MicroLind-Developers/microlind/docs/AudioExpansionCard/AudioExpansionCard3.png

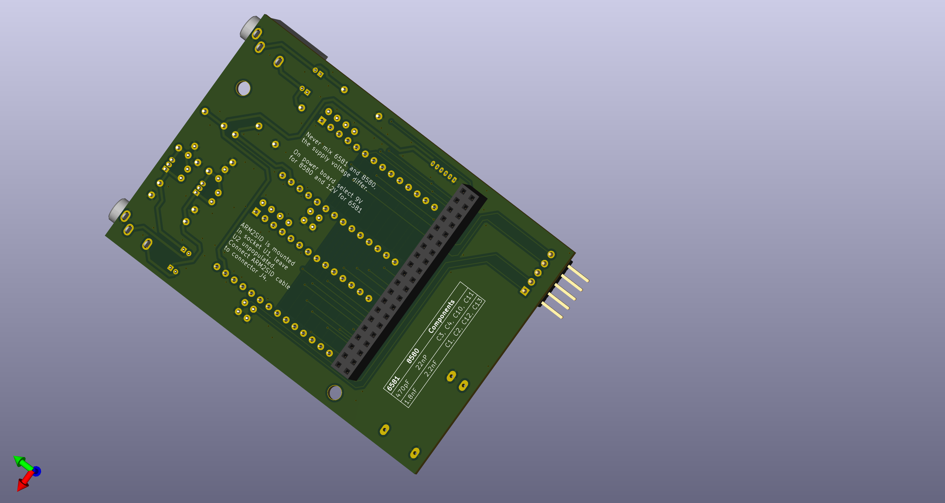
docs/AudioExpansionCard/AudioExpansionCard3.png
