MicroLind-Developers/microlind/README.md

# µLind
A 6809/6309 based micro computer with advanced memory and irq handling.
