MicroLind-Developers/microlind/docs/AudioExpansionCard/aeb-schematics.png

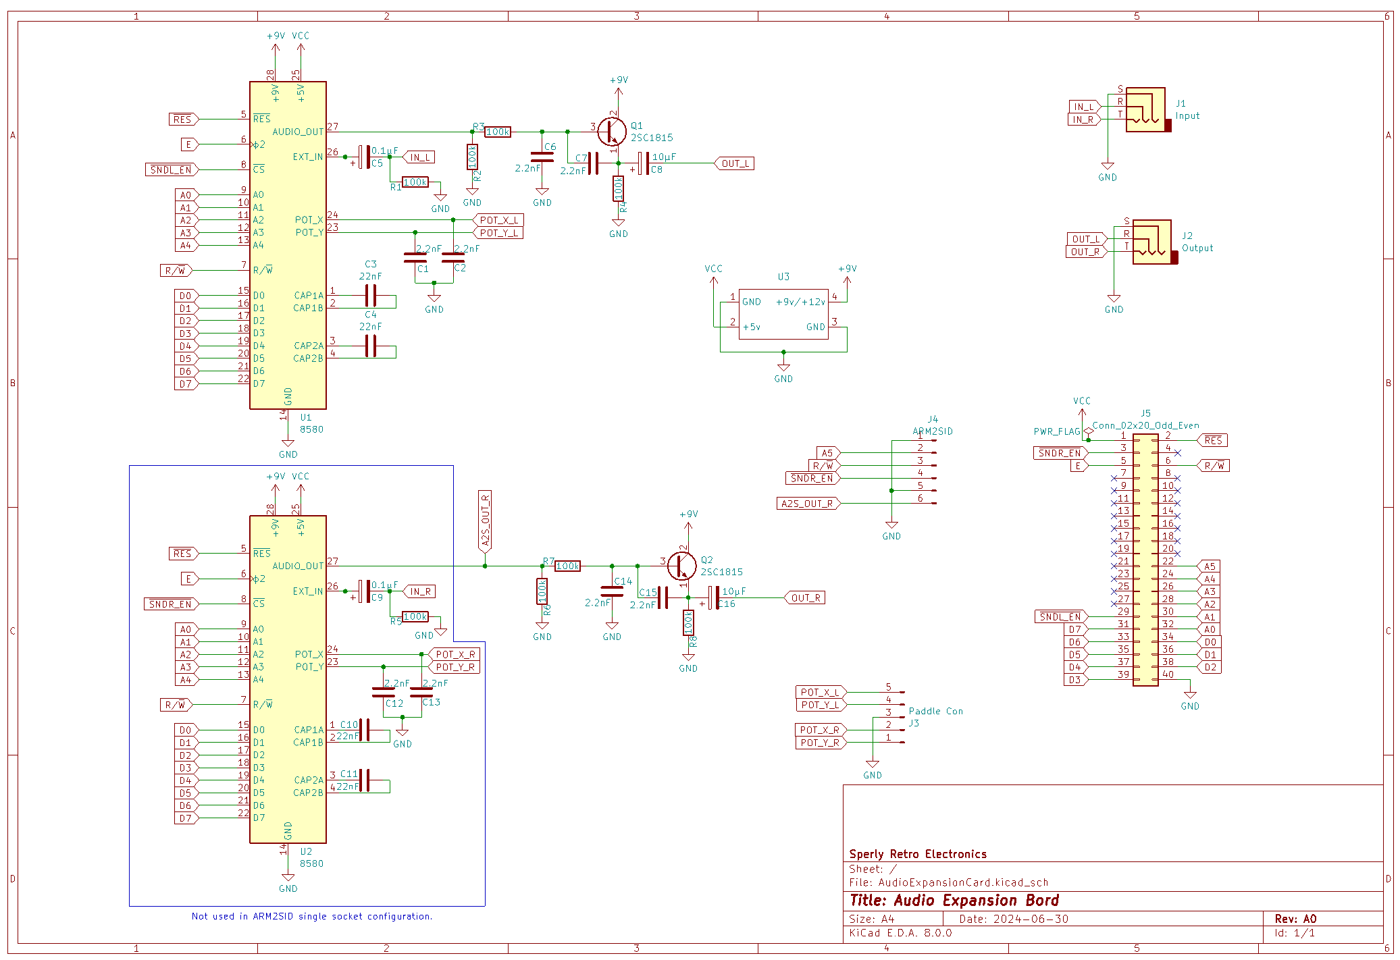
docs/AudioExpansionCard/aeb-schematics.png
