MicroLind-Developers/microlind/docs/AudioExpansionCard/AudioExpansionCard2.png

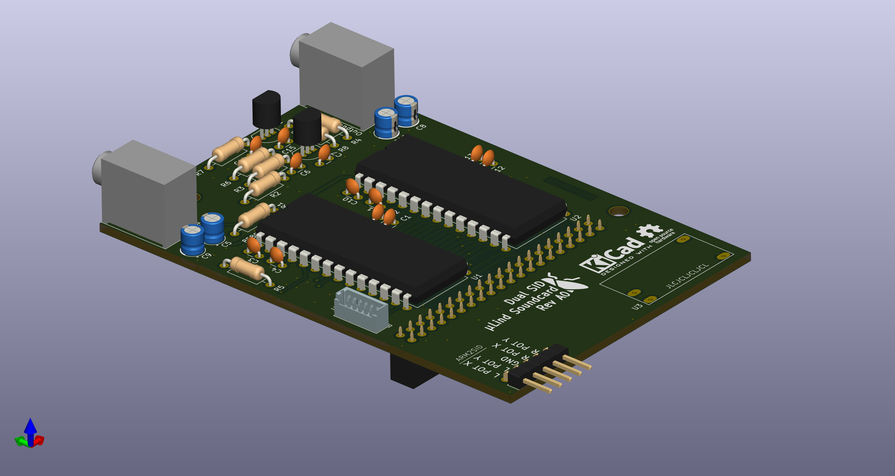
docs/AudioExpansionCard/AudioExpansionCard2.png
