MicroLind-Developers/microlind/docs/AudioExpansionCard/AudioExpansionCard.png

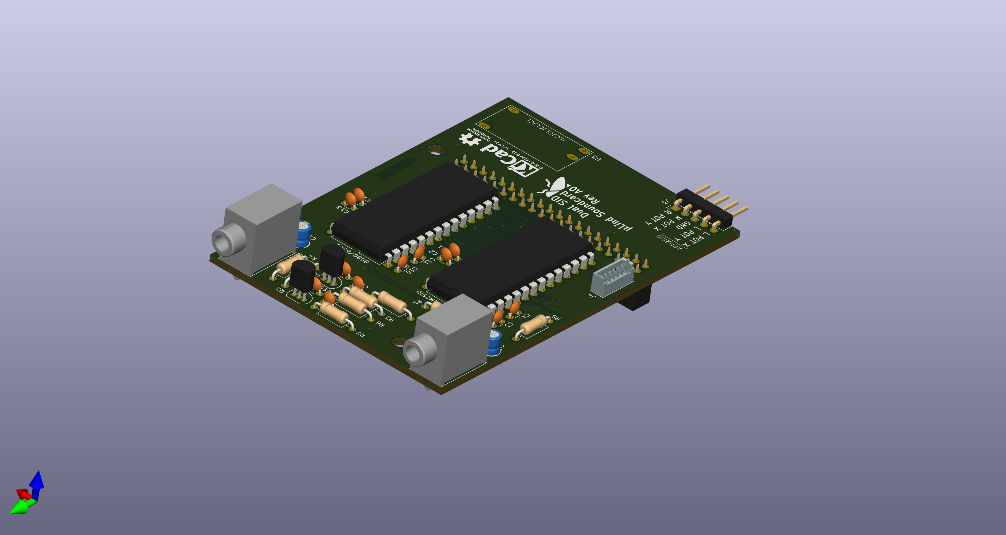
docs/AudioExpansionCard/AudioExpansionCard.png
