MicroLind-Developers/microlind/docs/DSView-240731-161717.png

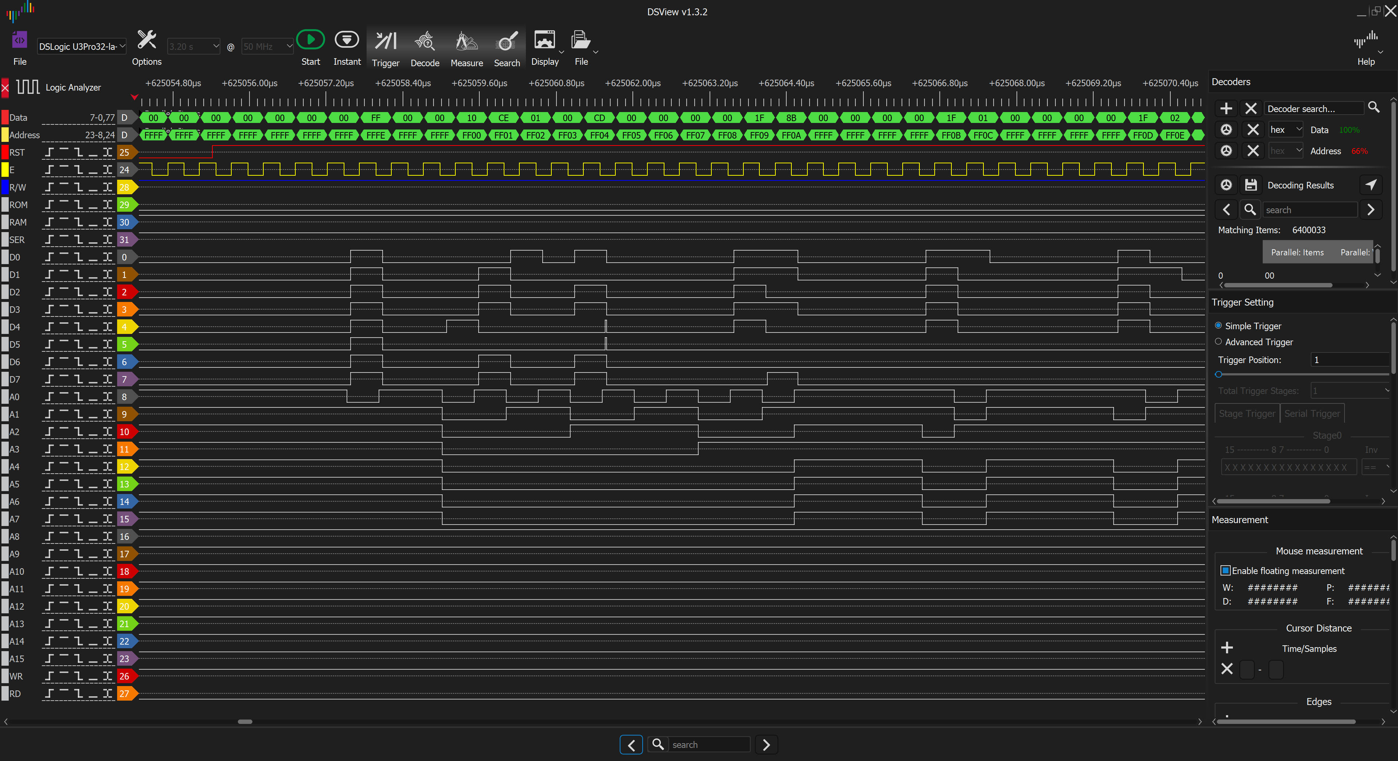
docs/DSView-240731-161717.png
