MicroLind-Developers/microlind/docs/FirstSuccessfulRun.png

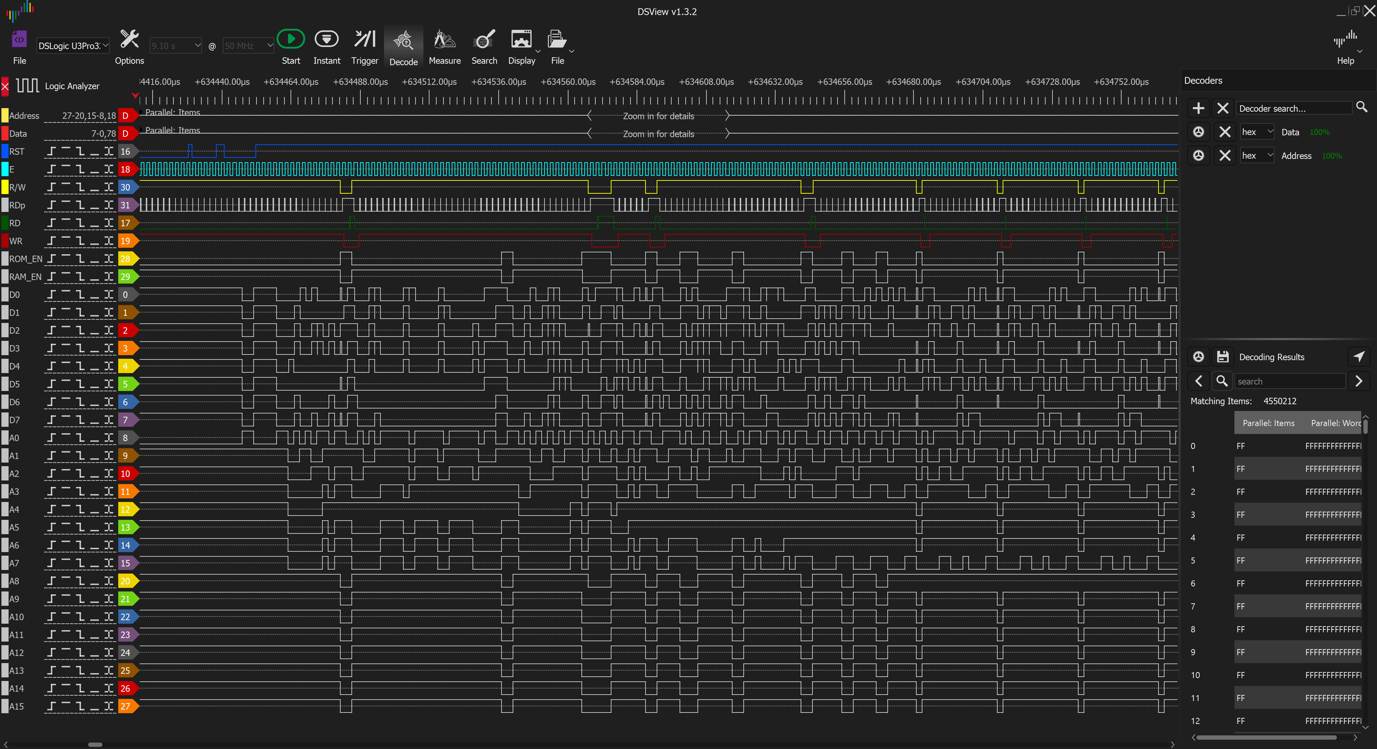
docs/FirstSuccessfulRun.png
