MicroLind-Developers/microlind/docs/motherboard.png

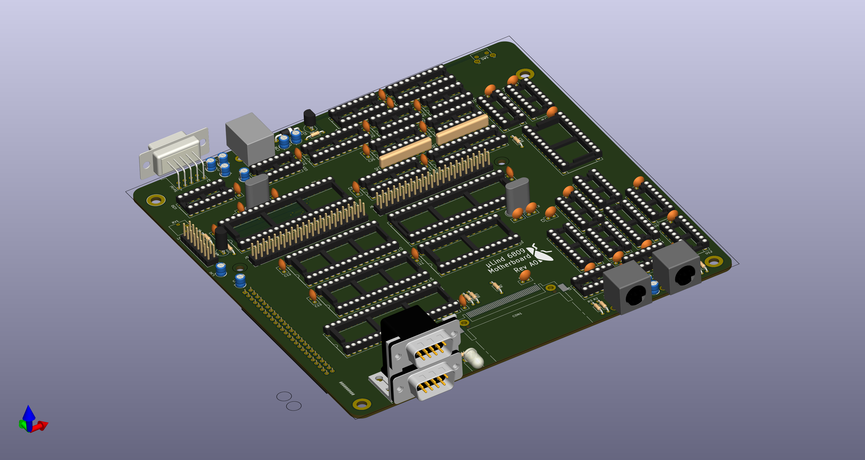
docs/motherboard.png
