MicroLind-Developers/microlind/docs/Parallell-Expansion.png

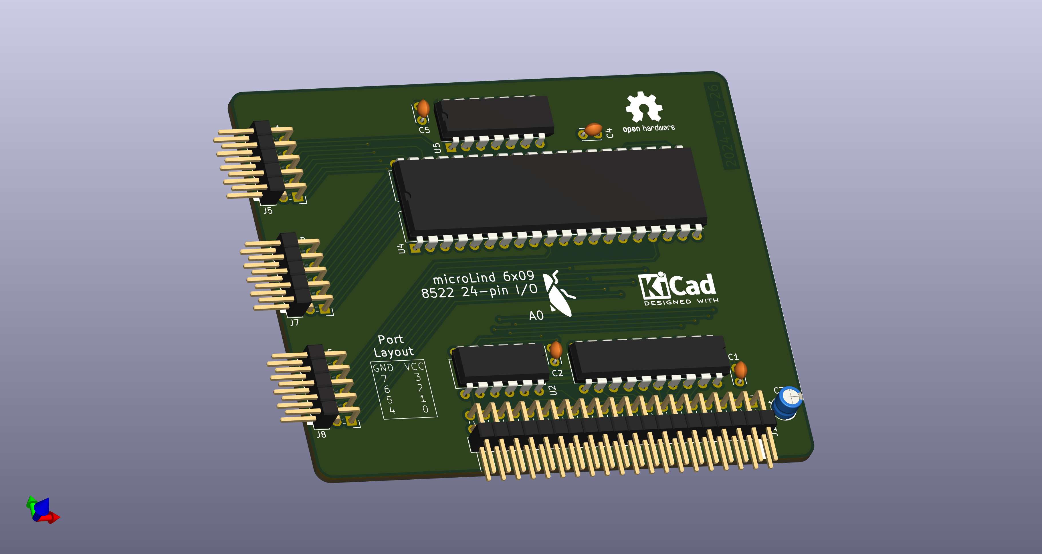
docs/Parallell-Expansion.png
