MicroLind-Developers/microlind/docs/sre.png

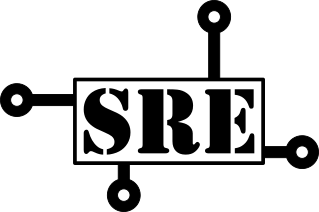
docs/sre.png
