MicroLind-Developers/microlind/docs/system-architecture.png

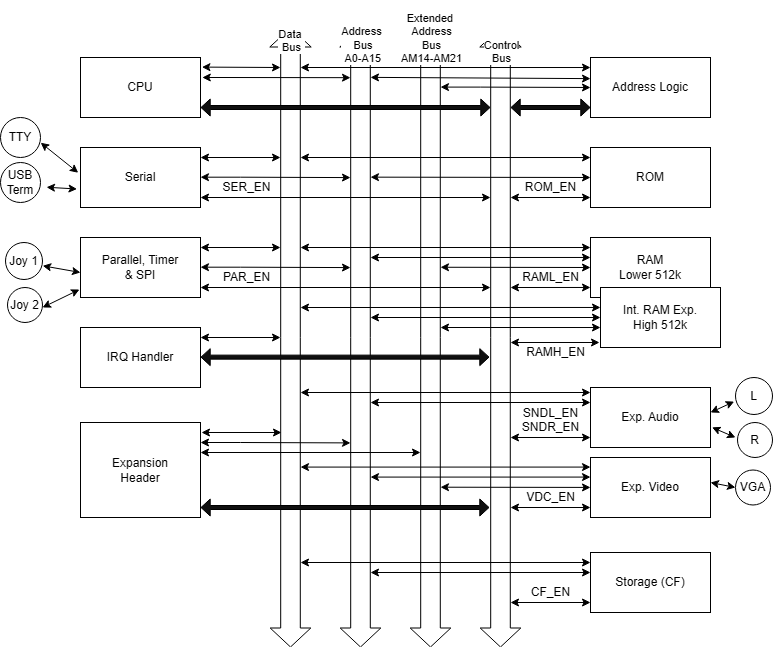
docs/system-architecture.png
