MicroLind-Developers/microlind/docs/TheBlipp.png

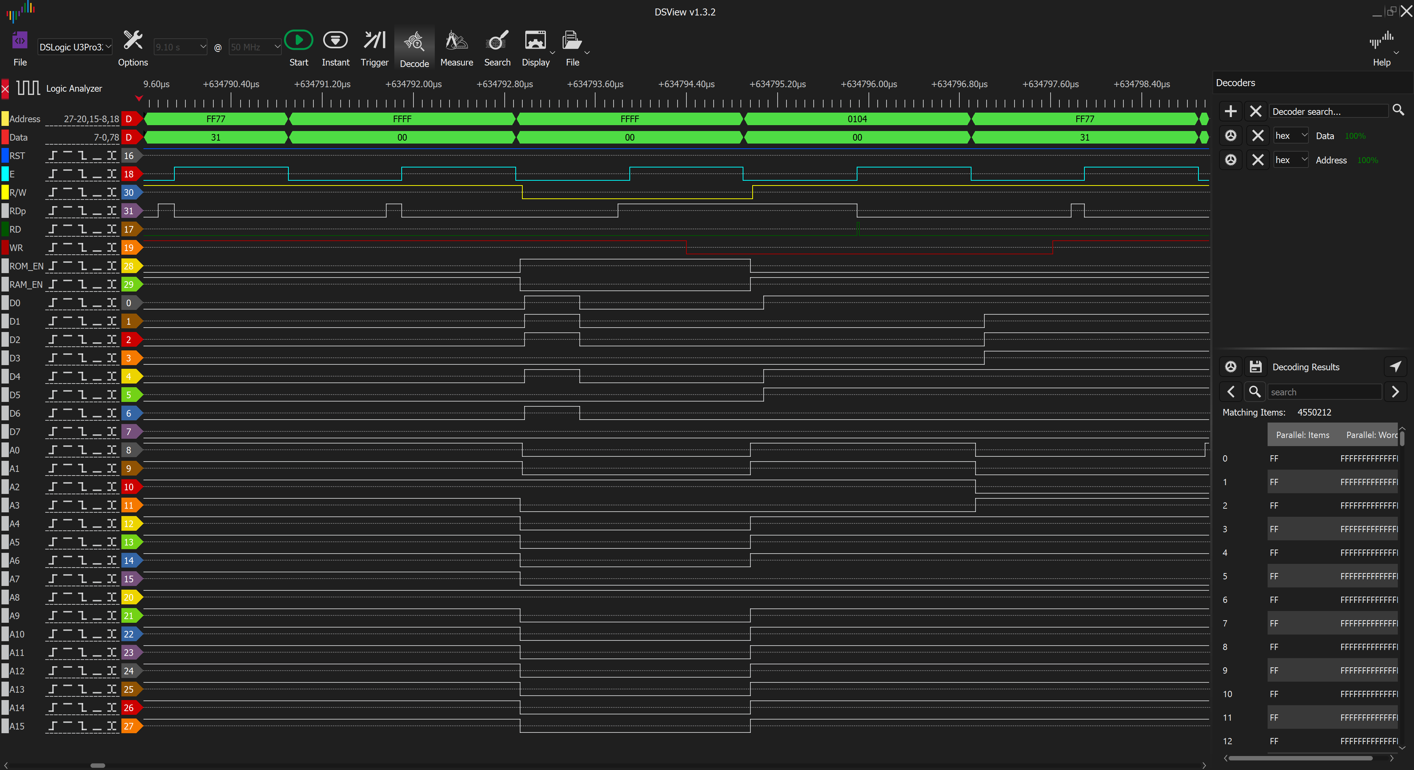
docs/TheBlipp.png
