MicroLind-Developers/microlind/releases/stage1/ml-stage1.png

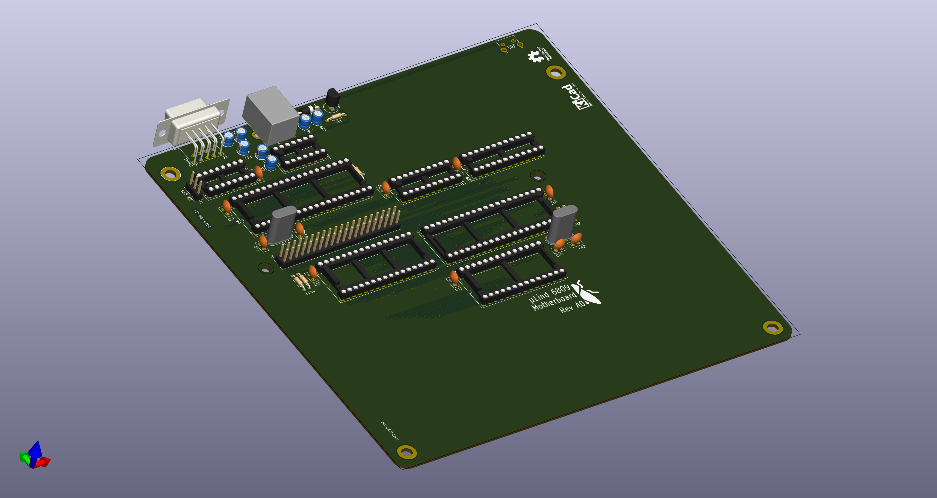
releases/stage1/ml-stage1.png
