MicroLind-Developers/microlind/releases/stage2/motherboard-stage2.png

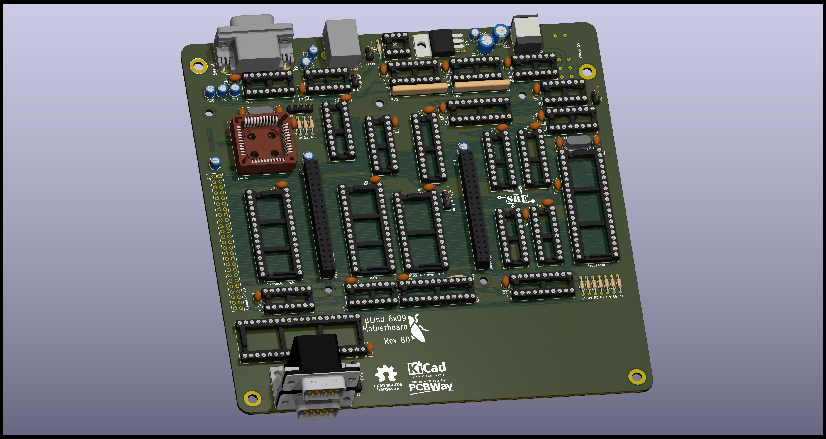
releases/stage2/motherboard-stage2.png
