MicroLind-Developers/microlind/kicad-lib/189-009-613r491.stp

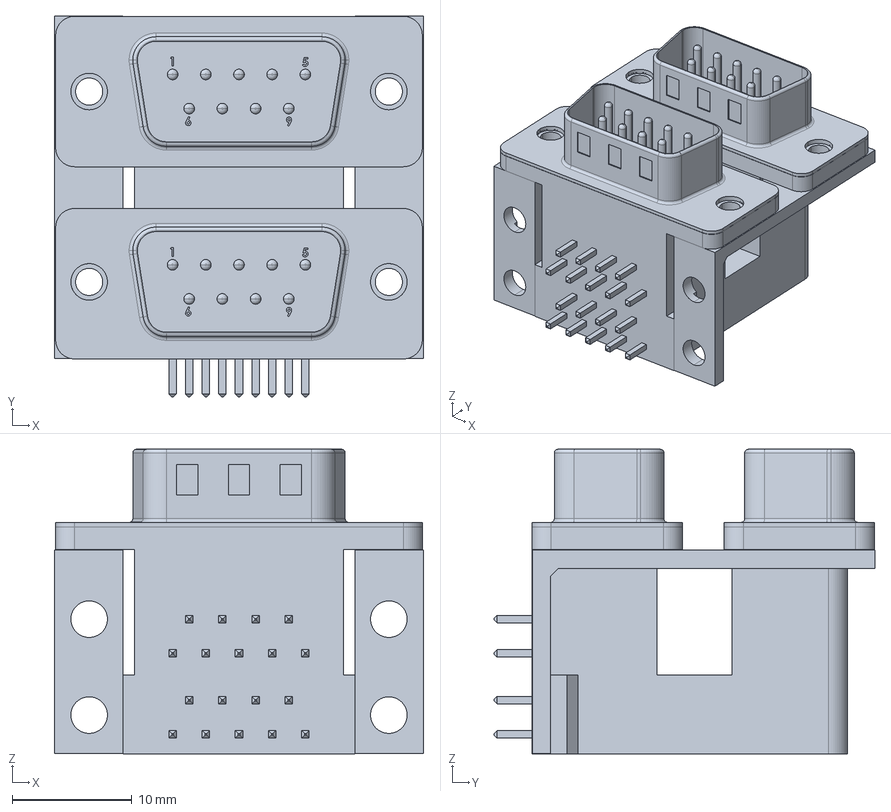
[picture p15: CAD file, 2025-04-27]
kicad-lib/189-009-613r491.stp
30.8 x 31.8 x 25.4 mm
