MicroLind-Developers/microlind/kicad-lib/DualSerialMaleConnector.step

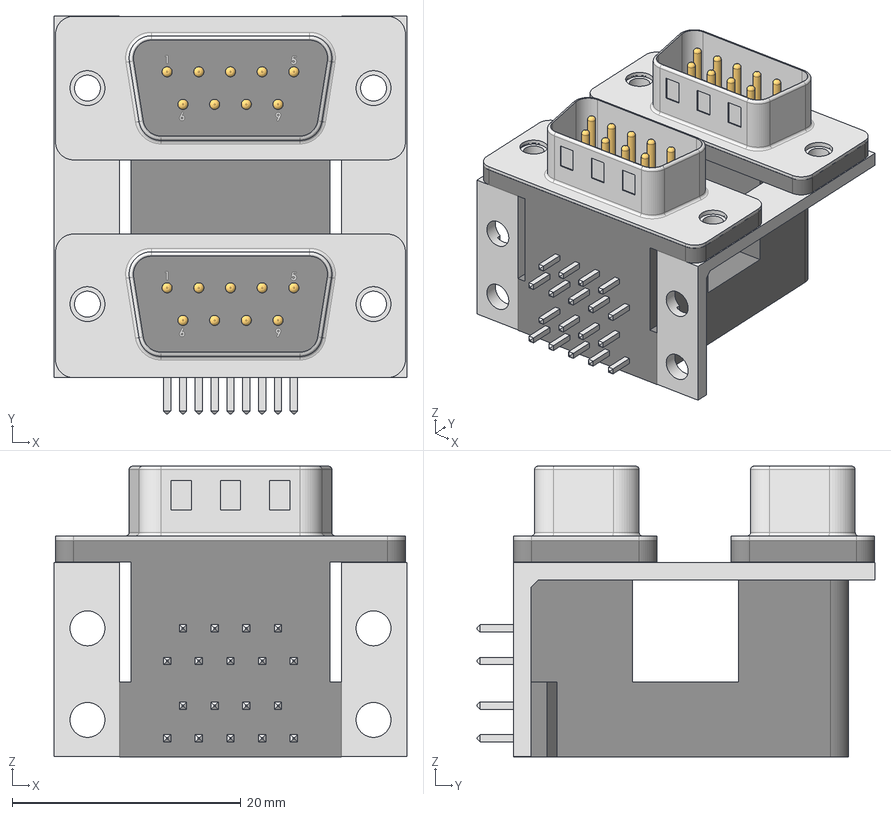
[picture p16: CAD file, 2025-04-27]
kicad-lib/DualSerialMaleConnector.step
30.8 x 34.8 x 25.4 mm
