MicroLind-Developers/microlind/kicad-lib/PLCC44_THT_Socket_P1,27_P2,54.stp

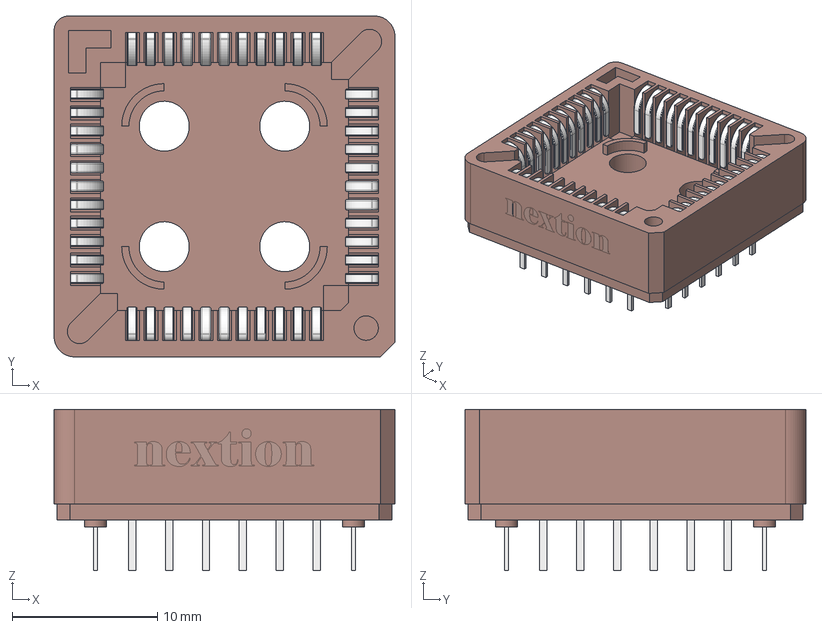
[picture p17: CAD file, 2024-10-30]
kicad-lib/PLCC44_THT_Socket_P1,27_P2,54.stp
23.5 x 23.5 x 11.1 mm
