MicroLind-Developers/microlind/kicad-lib/connector_a-dio-dp_06_gv.stp

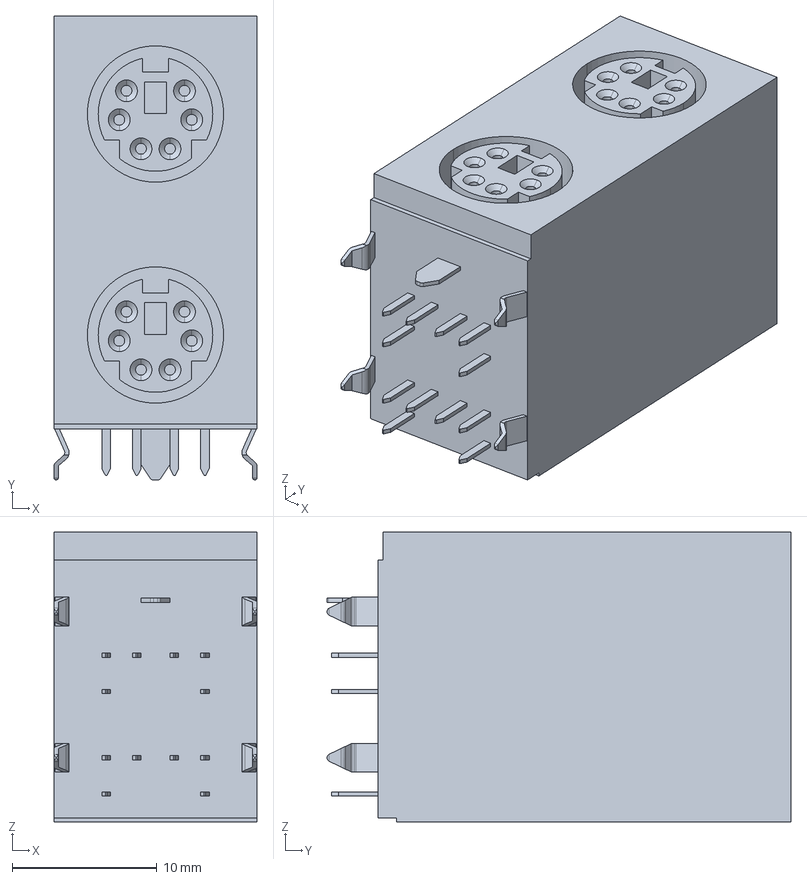
[picture p19: CAD file, 2024-10-30]
kicad-lib/connector_a-dio-dp_06_gv.stp
14.0 x 32.0 x 20.0 mm
