MicroLind-Developers/microlind/kicad-lib/7201J1AQE2.stp

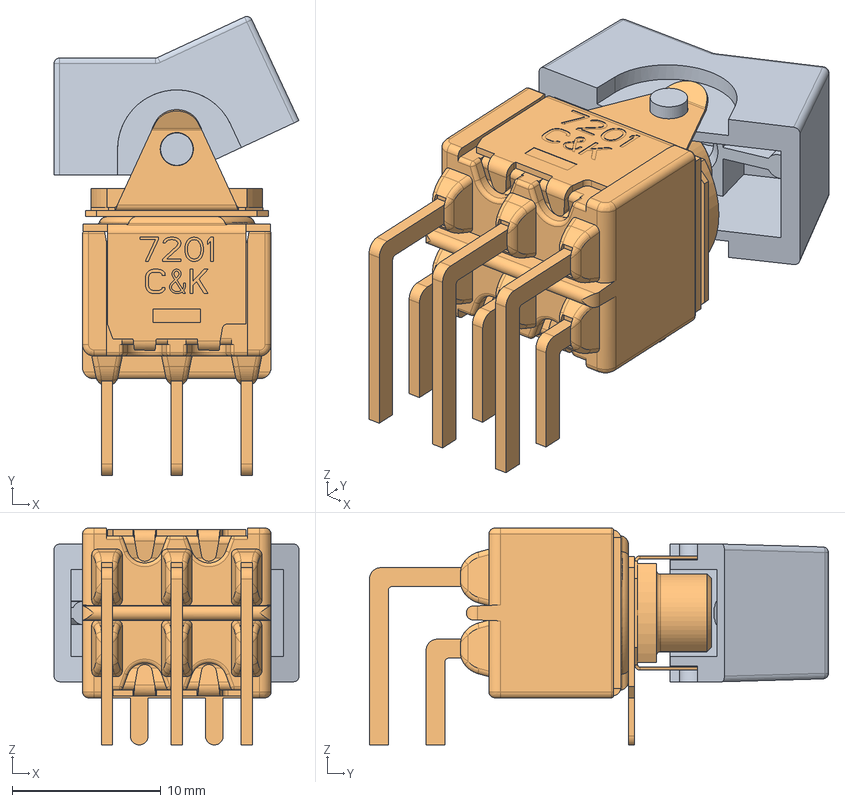
[picture p20: CAD file, 2024-10-30]
kicad-lib/7201J1AQE2.stp
16.5 x 30.9 x 14.6 mm
