MicroLind-Developers/microlind/kicad-lib/USB-B-S-F-B-TH.stp

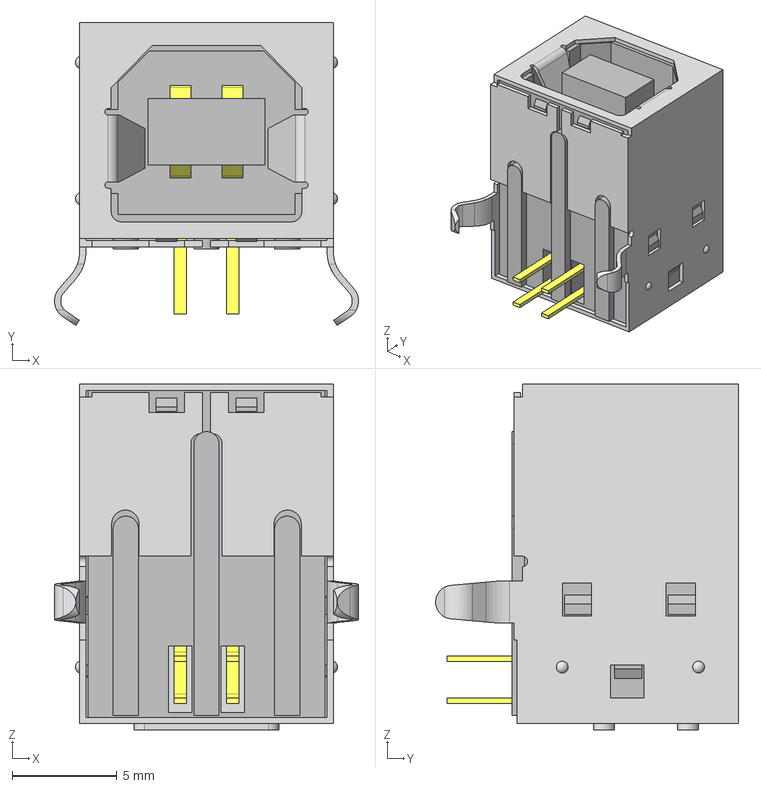
[picture p21: CAD file, 2024-10-30]
kicad-lib/USB-B-S-F-B-TH.stp
14.5 x 14.4 x 16.5 mm
USB-B-S-TH_S
USB-B-S-B-TH_B
USB-B-S-TH_P
