MicroLind-Developers/microlind/kicad-lib/USB type-B female PCB.STEP

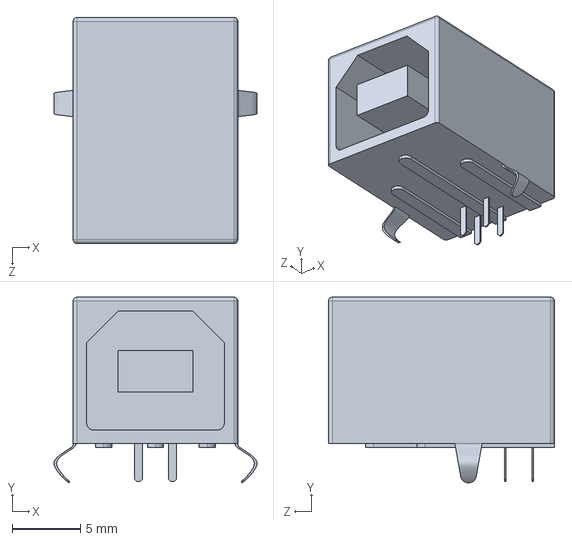
[picture p22: CAD file, 2024-10-30]
kicad-lib/USB type-B female PCB.STEP
14.9 x 13.6 x 16.6 mm
