MicroLind-Developers/microlind/kicad-lib/CUI_DEVICES_SJ1-3533NG.step

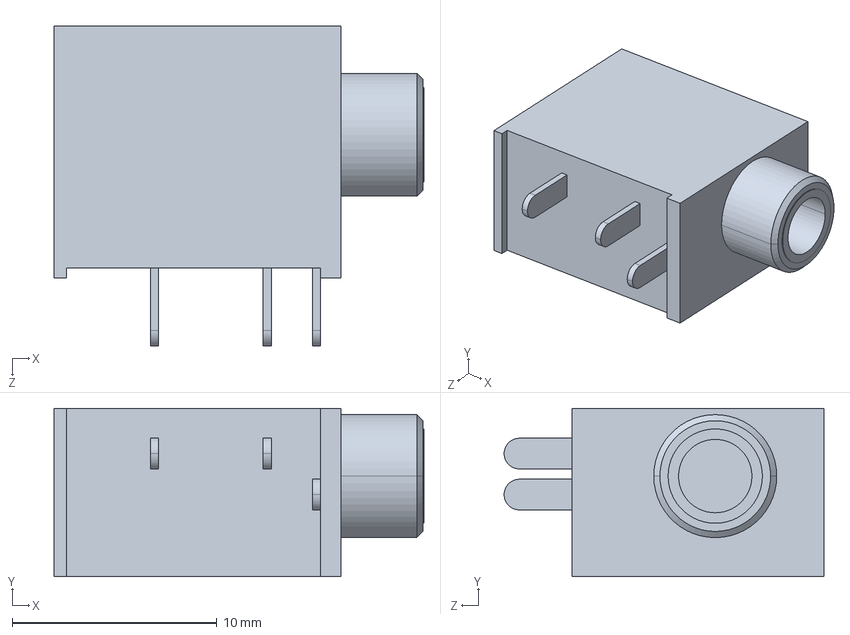
[picture p23: CAD file, 2024-10-30]
kicad-lib/CUI_DEVICES_SJ1-3533NG.step
18.1 x 8.20 x 15.6 mm
