MicroLind-Developers/microlind/kicad-lib/Mini-DIN-6P.step

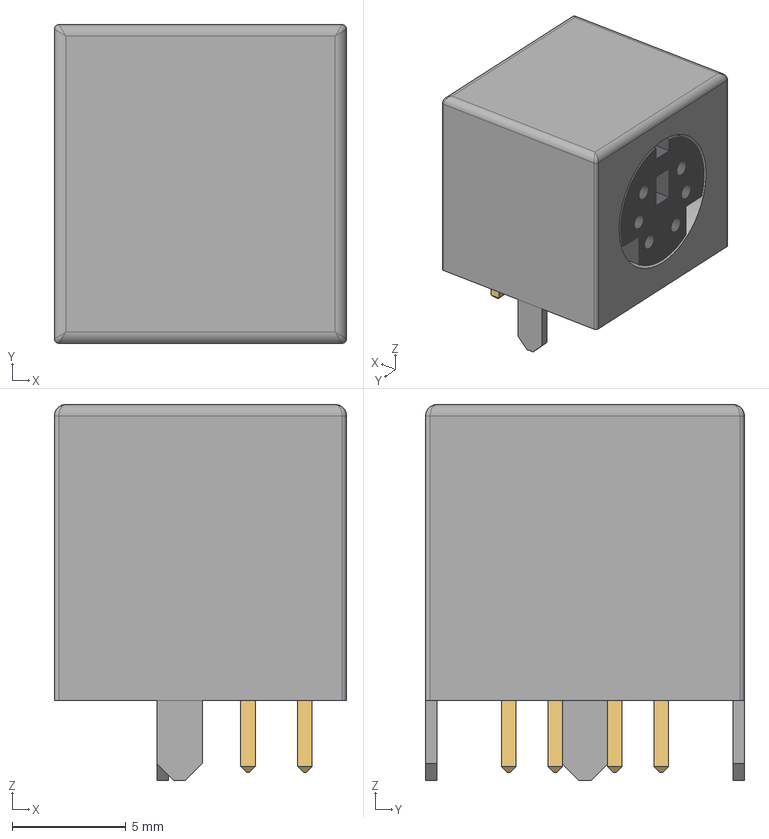
[picture p24: CAD file, 2024-07-31]
kicad-lib/Mini-DIN-6P.step
12.8 x 14.0 x 16.5 mm
