MicroLind-Developers/microlind/kicad-lib/PRT-16764.stp

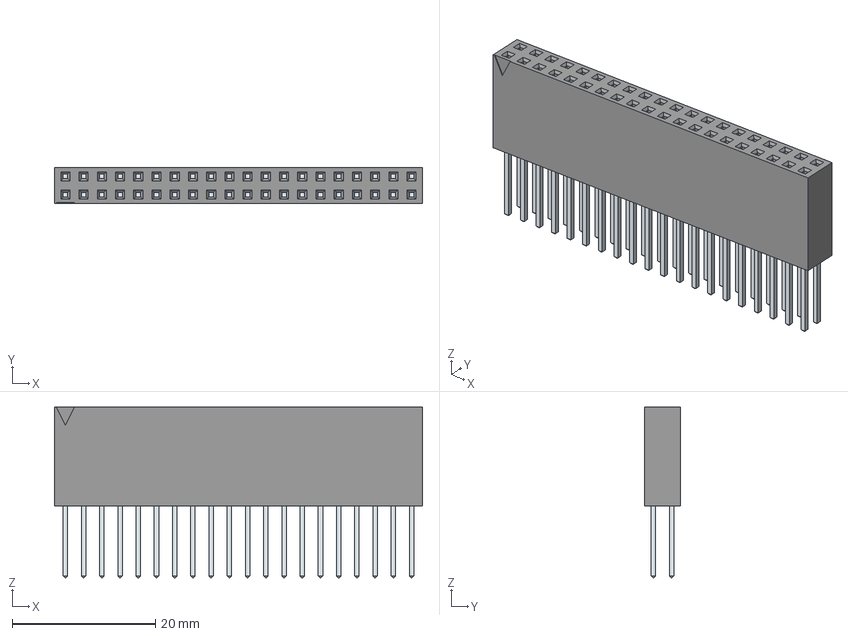
[picture p25: CAD file, 2024-07-31]
kicad-lib/PRT-16764.stp
51.3 x 5.00 x 23.8 mm
LeadsArray
