MicroLind-Developers/microlind/kicad-lib/N7E50-7516PK-20.stp

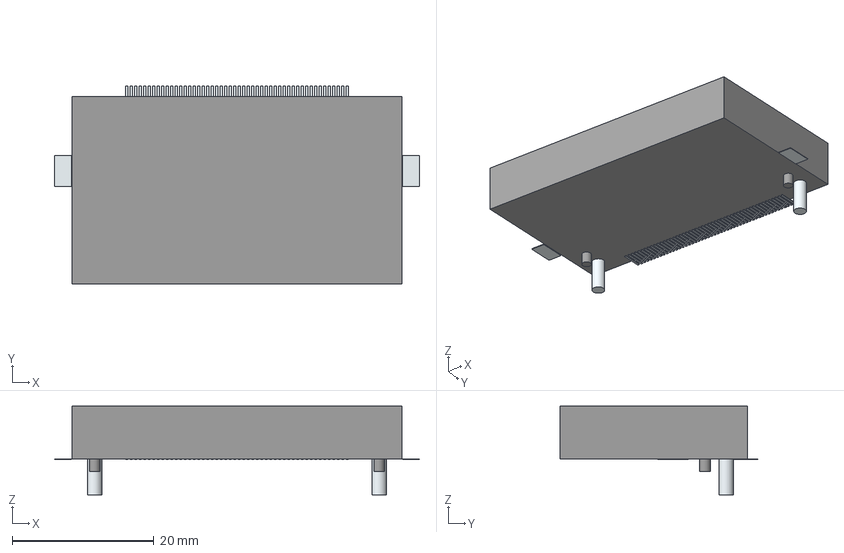
[picture p26: CAD file, 2024-07-31]
kicad-lib/N7E50-7516PK-20.stp
51.5 x 28.0 x 12.5 mm
Pins
Lugs x 4
Leads x 4
