MicroLind-Developers/microlind/kicad-lib/AudioExpansionCard.step

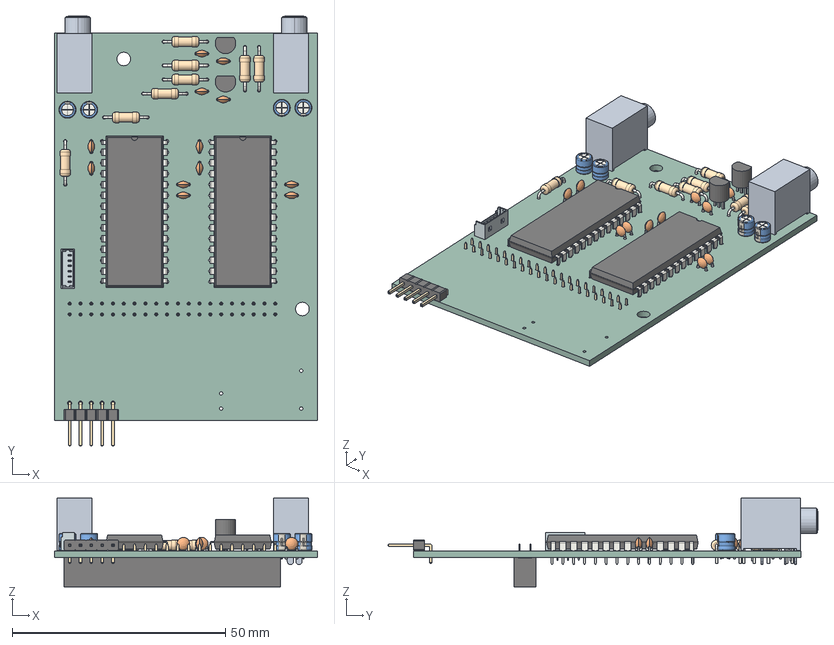
[picture p27: CAD file, 2024-07-31]
kicad-lib/AudioExpansionCard.step
61.7 x 100.9 x 20.8 mm
R_Axial_DIN0207_L63mm_D25mm_P1016mm_Horizontal x 8
C_Disc_D30mm_W16mm_P250mm x 12
DIP-28_W15.24mm x 2
CP_Radial_D40mm_P150mm x 4
CUI_DEVICES_SJ1-3533NG x 2
PinHeader_1x05_P254mm_Horizontal
530470610wbm000_01
PinSocket_2x20_P254mm_Vertical
TO-92_Inline_Narrow x 2
AudioExpansionCard_PCB
