MicroLind-Developers/microlind/kicad-lib/M3x8.STEP

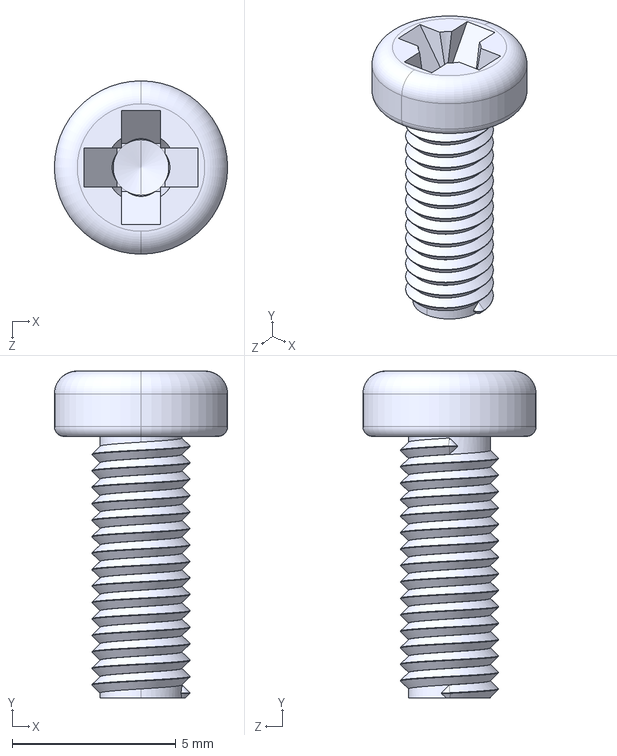
[picture p28: CAD file, 2024-10-30]
kicad-lib/M3x8.STEP
5.30 x 10.0 x 5.30 mm
