MicroLind-Developers/microlind/kicad-lib/530470610.stp

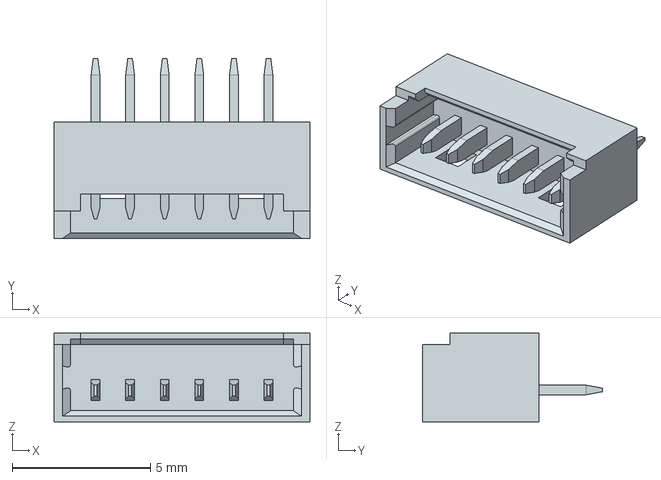
[picture p29: CAD file, 2024-10-30]
kicad-lib/530470610.stp
9.25 x 6.50 x 3.20 mm
