MicroLind-Developers/microlind/kicad-lib/5788667-1.stp

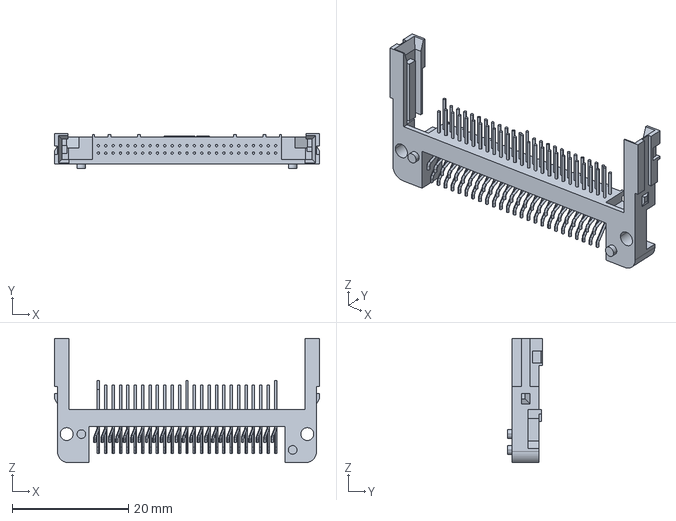
[picture p30: CAD file, 2024-10-30]
kicad-lib/5788667-1.stp
45.6 x 5.97 x 21.4 mm
