MicroLind-Developers/microlind/kicad-lib/2301843-1.step

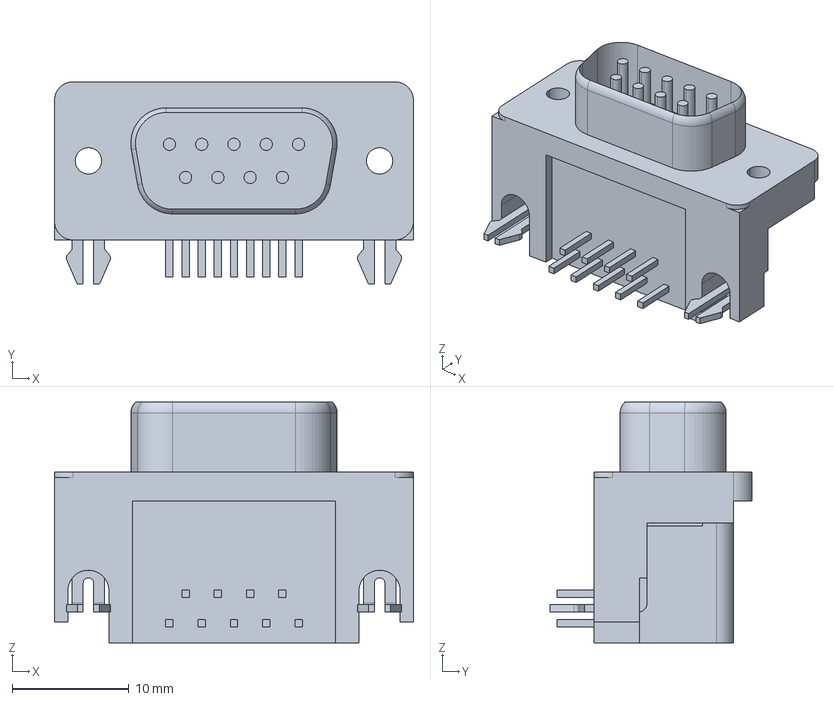
[picture p31: CAD file, 2024-07-31]
kicad-lib/2301843-1.step
30.8 x 17.4 x 20.6 mm
