MicroLind-Developers/microlind/(list of files, cad)

Other CAD files:
kicad-lib/189-009-613r571.stp
