MicroLind-Developers/microlind/docs/Microlind_Manual booklet 1-14.pdf

# µLind

# 8-bit Retro Computer

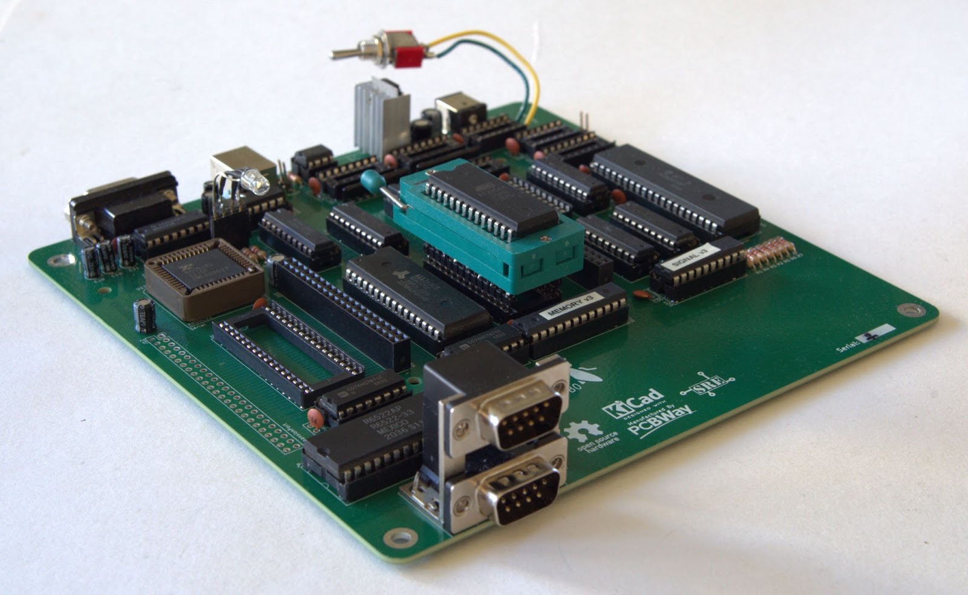
[picture p32: figure]

Sperly Retro Electronics | v1.0 | 2025-05-23

# noit cudort nI

si ht ni gni ht yr eve wohr eb me mer ot snae ma sa, dni L cir E, e myb nettir w si l auna msi hT eht , uoy hti w egdel wonk t aht er ahs ot snae m a sa osl a dna kr o w ot dednet ni si met sys ebt hgi msgni dr o w os r ekaeps hsil gnE evit an at on maI .l auna mt nell ecxe si ht f o r edaer e mos ebt hgi mer ehT. hguone r ael c eb ll ahs t net ni eht t aht epoh I t ub se mit e mos dri e w t uohti woS.ti xif nacI os e mot kcabti tr oper esael p, yna dnif uoyfi t ubll e wsa sr orr el aut caf

! sseni sub eht ot ni t eg s't el , odar ehtr uf

## wei vr evot cej or pf eir B

r of dna, gnit ser et ni na dnuof nos dl o r aey 41 neht y mr etf a, 3202 ni detr at s t cej or p si hT neeb gnol ecni s dahI ! 9086 ehT: spi hc dl of o gab a ni r ossecor por ci m, n wonknu suf o ht ob si ht f o ngi sed eht yb deugirt ni yl et ai de mmi sa wdnar et up mocor ci ma dli ub ot woh no suoir uc di va er a nos y m dna e m ht ob( 0156/ 2056 eht hti wr aili maf eti uq gni eB. pi hc elttil cit oxe e W. gnit ser et ni 9086 eht f o ser ut aef " decnavda" eht dnuof e w)! 46 OG. sr esu er odo mmo C dnA. od ot el ba eb ot r et up moc a ekil dl uo w e wt ah wf o saedi t ner effi d no gni hct eks detr at s r ossecor p si ht eda mt aht ser ut aef l ar eves dnuof r edaer t eehsat ad gni za ma na si oh wnos y m

. no met sys a dli ub ot gnit ser et ni f ot sil a no deltt es e wdnuor a saedi gni wor ht dna noi ssucsi df o sht no mf o el puoc ar etf A

: evah ot met sys eht det na we wser ut aef

) 9036 eht no dedi ced e wnor et al( r ossecor p 90x6 eht no desaB ●

) gni knabf o dni k e mos eri uqer dl uo wsi hT( MARel bali avaf o b M1t sael t a eva H ● sr evir d dna SOI B gnir ot sr of MORPEE ●

) gubed ot el ba eb ot( tr op el osnoc desab BSU ● noit aci nu mmocl ar ehpir epr of tr opl air eS ●

)t ne mni atr et ner of , el bit ap moc 46 C( str op kcit syoJ ●

)ll e wsa ecafr et ni esuo myll uf epoh dna( ecafr et ni dr aobyeK 2SP ●

) ytili bit ap mocti b- 8 ot eud, FCyl ekil t so m( snoit acil ppa dna SOr of egar ot sl anr et x E ●

) dnuos DI Sl ufr edno wt aht t na we w( tr oppus oi duA ●

) doogtif dl uo w821 Ceht ni pi hcl oc 08 ehT( seitili bapac oedi V ● …seitili bi ssop noi snapxer ehtr uf dnA ●

! sl ol r of t suj , egakcap XTI-i ni Ma ni si ht ll A ●

)fl esy mt uoyal dr aob eht f oll a di dI( I dr aob eno no si ht ll a egana m ot el ba eb ot dnA dr aobt aht t eg, ser ut aef e mos dda, gni kr o wci sab gni ht yr evet eg, segat s ni ti od ot dedi ced t aht was osl a e W. gnor wsi t ah w et al osi ot r ei sae si ti ya w si hT.t ser eht dda dna gni kr o w os, dr aob eht no sti ucri c oi duar or ell ort noc oedi v r ehti er of moor eb ot gni ogt on sa w er eht l ar eves t set dna r ett eb met sys eht r eyal ot el ba eb ot , str op- nodda ot devo m er e w yeht

. snoit ul os oi dua dna oedi vt ner effi d sci nort cel E ort e Rylr epS 2

## Pinout tables

## Circuit Diagrams & Schematics

### Annotated schematic diagrams

Detailed circuit descriptions

References and additional resources

14 | Sperly Retro Electronics

So we planned following stages:

- Stage 1: Basic functionality, processor, some unbanked RAM, EEPROM, basic logic chip setup and a serial controller.
- Stage 2: Stage 1 + banking system, more RAM, power and reset circuit, addon-ports (to be able to start developing video and audio addons), expansion port (with more “all” signals) and a parallel port for joysticks.
- Stage 3: Stage 2 + PS2 interfaces and CF addon port (this was not possible to fit on the board either).

This manual is written for Stage 3, the “final” stage, and will be updated upon correction and changes done to the system during the development (at the time of writing this, the Stage 3 has not been ordered yet, but all parts of stage 2 have been tested).

## Purpose and intended audience of the manual

This manual will be useful for anyone that needs to either fault trace the µLind, change settings or write applications for the system. Since this manual also contains a listing of all BIOS routines and memory mapping.

# Specifications

### Processor details (HD6x09, clock speed, etc.)

### Memory specifications (RAM/ROM configuration)

### I/O capabilities and peripherals

Sperly Retro Electronics | 3

# wei vr ev O met sy S

hti w esac XTI-i ni ma ni tif ot dengi sed si tI . yr ol g sti ll a ni dr aobr eht o m dni Lµ eht si si hT ekil , str op r esu dna kcab eht noll a er a str op ytilit u ehT. yl gni dr occa dengil a sel oh wer cs eht r of el bi ssecca yli sae,t norf eht no er a hsal Ft cap mo C dna esuo m, dr aobyek , skcit syoj gni kcat s r of dr aob eht f o edi s r eppu r ehti e no der edl os eb nac tr op noi snapxe ehT.r esu

. edi s eht ot r o wol eb snoi snapxe kcat s ot , edi s mott ob eht no r o pot no sdr ac noi snapxe ot der evil ed si dr aob eht neh w der edl os ebt on r edaeh dr aob noi snapxe eht lli w er of er ehT

.r esu dne eht

sci hpar G
- 044F$

nodda sci hpar g no gni dnepe D F74F$

L oi duA
- 084F$

nodda oi duA no gni dnepe D FB4F$

Roi duA
- 0 C4F$

nodda oi duA no gni dnepe D FF4F$

noi snapx E

tr oP
- 005F$

) ni ppa mr et si ger noi snapxe eS( snoi snapx E no gni dnepe D FF7F$

: woll of sa er a dr aob noi snapxe eht r of pa myr o me meht dnA ci goL sser ddA dr aoB noi snapxE

0A 1A 2A 3A 4A 5A 6A 7A 8A

1 dr aoBesaB x x x x x x 0 0 0 F36F 006F x x x x x x 1 0 0 F76F 046F

)ti B 7( 1t ol S

x x x x x x 0 1 0 FB6F 086F

)ti B 5( 2t ol S x x x x 1 0 1 1 0 FD6F 0 C6F

)ti B 3( 3t ol S x x x 0 0 1 1 1 0 7E6F 0E6F

)ti B 3( 4t ol S x x x 1 0 1 1 1 0 FE6F 8E6F

)ti B 3( 5t ol S x x x 0 1 1 1 1 0 7F6F 0F6F

)ti B 3( 6t ol S x x x 1 1 1 1 1 0 FF6F 8F6F

2 dr aoBesaB x x x x x x 0 0 1 F37F 007F x x x x x x 1 0 1 F77F 047F

)ti B 7( 1t ol S

x x x x x x 0 1 1 FB7F 087F

)ti B 5( 2t ol S x x x x 1 0 1 1 1 FD7F 0 C7F

)ti B 3( 3t ol S x x x 0 0 1 1 1 1 7E7F 0E7F

)ti B 3( 4t ol S x x x 1 0 1 1 1 1 FE7F 8E7F

)ti B 3( 5t ol S x x x 0 1 1 1 1 1 7F7F 0F7F

)ti B 3( 6t ol S x x x 1 1 1 1 1 1 FF7F 8F7F sr eil ppus dnat sil str aP

31 sci nort cel E ort e Rylr epS

$F409 | ER/FR | ErrorRegister | FeatureRegister
$F40A | SCR | Sector count register
$F40B | SNR | Sector number register
$F40C | CLR | Cylinder low register
$F40D | CHR | Cylinder high register
$F40E | DHR | Drive head register
$F40F | SR/CR | Status register | Command register
Parallel (VIA) | $F410 | ORB/IRA | Input Register B | Output Register B
| $F411 | ORA | Input Register A | Output Register A
| $F412 | DDRB | Data Direction Register B
| $F413 | DDRA | Data Direction Register A
| $F414 | T1L-L / T1C-L | T1 Counter Low | T1 Latch Low
| $F415 | T1C-H | T1 Counter High
| $F416 | T1L-L | T1 Latch Low
| $F417 | T1L-H | T1 Latch High
| $F418 | T2C-L | T2 Counter Low | T2 Latch Low
| $F419 | T2C-H | T2 Counter High
| $F41A | SR | Shift Register
| $F41B | ACR | Aux Control Register
| $F41C | PCR | Peripheral Control Register
| $F41D | IFR | Interupt Flag Register
| $F41E | IER | Interupt Enable Register
| $F41F | ORA/IRA | Same as register 1 without "handshake"
Serial (XR88C92) | $F420 | MRA | Mode Register A
| $F421 | SRA/CSRA | Status Register A | Clock Select Register A
| $F422 | CRA | Reserved | Command Register A
| $F423 | RXA/TXA | Receive Buffer A | Transmit Buffer A
| $F424 | IPCR/ACR | Input Port Change Register | Auxiliary Control Register
| $F425 | ISR/IMR | Interrupt Status Register | Interrupt Mask Register
| $F426 | CUR/CTPU | Counter / Timer Upper Register | C/T Pre-load Value Upper Register
| $F427 | CLR/CTPL | Counter / Timer Lower Register | C/T Pre-load Value Lower Register
| $F428 | MRB | Mode Register B
| $F429 | SRB/CSRB | Status Register B | Clock Select Register B
| $F42A | CRB | Reserved | Command Register B
| $F42B | RXB/TXB | Receive Buffer B | Transmit Buffer B
| $F42C | GPR | General Purpose Register
| $F42D | IPR/OPCR | Input Port Register | Output Port Control Register
| $F42E | STCR/SOPR | Start C/T Command | Set Output Port Register
| $F42F | SPCR/ROPR | Stop C/T Command | Reset Output Port Register
12 | Sperly Retro Electronics

## Block diagram of the µLind system

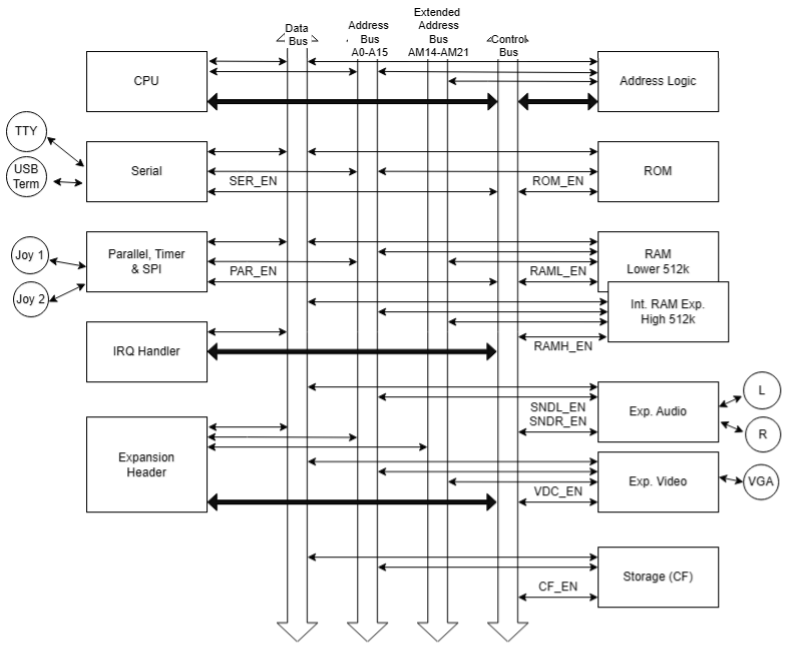
[picture p33: figure]

The block diagram shows the principle behind the µLind system. It shows what signals each subsystem is using and how they are interconnected. Do note that this is a simplified image and some signals may not be included.

## Explanation of key subsystems

To make it easier to explain how µLind is interconnected it will be described as subsystem according to the block diagram.

### The CPU subsystem

This is the heart of the µLind system and is connected to all main buses. It has the system clock crystal connected and will generate a E & Q clock, with the Q clock 90° before the E clock.

Sperly Retro Electronics | 5

### met sysbusl air eS ehT

l air es 2 hti wr ell ort nocl air es a ya w el p mi s a ni met sys dni Lµ eht ot t cennoc ot el ba eb oT l air es a sa desu yll a mr on, noit cennoc BSU a r of desu si tr op t srif ehT. dedda sa w str op

.tr opl air es el bali avar esu a si tr op dnoces ehT.l ani mr et

# st nenop mo Cer a wdr a H

## :t nenop moc ni a mhcaef o esopr up dna noit pir cse D

### ) 90x6 DH( r ossecor P

### o wt er a er ehT

### ) MOR/ MAR( sel udo myr o me M

### yrti ucri c noit ar eneg kcol C

### str opt upt uo/t upnI

### sr ot cennoc noi snapx E

### st ne meri uqer yl ppusr e woP

# snoit p O & noit ar ugif no C

## . sr ep muj gnil dnah no snoit curt sni l ar ene G

l acirt cel e na esuac nact ahT. nor e wop eht hti wt aht od T ONod, degnahc eb ot si r ep muj afI r e wop eht gul pnu sya wl A. el basunu dr aob r uoy r edner t hgi m dna met sys r uoy ni tl uaf

. sr ep muj dr aob yna gni gnahc er of ebr ot cennoc

## snoit p Onoit ar ugif no Cdna sgnitt eSr ep muJ

# er a wmri F dna gni mmar gor P

st ne mnori vne er a wtf os detr oppusf o wei vr ev O snoit curt sni er a wmrif gnit adpu dna gni daoL

# seci dneppA

## senit uo R SOI B

f o noit cell oc a si er eht dni Lµ eht r of gni mmar gor p neh w seussi ezi mi ni m dna yfil p mi s oT ot knab yr o me m gnitt es morf , sksat dr adnat s f o t ol a hti w pl eh nac t aht senit uor SOI B

. noiti sop yr o me ma ot FC morf elif a gni daol

## pa Myr o me M

ebt hgi myal psi d oedi v eht ekil snoit cnuf e mos( deppa myr o me msi met sys O/I erit ne ehT

: el bat si ht ot gni dr occa el bali avar et si ger yr eve si er of er eht dna) deppa myr o me moduesp noit cnuF: R W noit cnuF: DR ci no menN sser dA ti nU OI

yr o me M

0B M 004F$ r eppa M
t a egapr of kcol byr o me mt est nerr uc dae R

FFF3$- 0000$
t a egapr of kcol Byr o me Mt eS

FFF3$- 0000$

1B M 104F$
t a egapr of kcol byr o me mt est nerr uc dae R

FFF7$- 0004$
t a egapr of kcol Byr o me Mt eS

FFF7$- 0004$

2B M 204F$
t a egapr of kcol byr o me mt est nerr uc dae R

FFFB$- 0008$
t a egapr of kcol Byr o me Mt eS

FFFB$- 0008$

3B M 304F$
t a egapr of kcol byr o me mt est nerr uc dae R

FFFD$- 000 C$
t a egapr of kcol Byr o me Mt eS

) k8 yl no( FFFD$- 000 C$

MQRI/ RQRI 404F$ r el dna H QRI , QRI evit cat nerr uc el bbi n wol : DR ksa m QRI der ugif noc ylt nerr uc el bbi n hgi h

, ksa m QRI t es ot el bbi n hgi h: R W

r eggirt lli wksa mnaht r ehgi h s QRI yl no

QRI

SLP 504F$ DELr e woP
, woll eY = 3, neer G= 2, de R= 1,ff O= 0 eti h W= 7, nay C= 6,t el oi V = 5, eul B = 4 sser p yekt nerr uct e G RPK 604F$ 2SP et yb esuo mt nerr uct e G RM 704F$

r et si ge Rat a D RD 804F$ hsal Ft cap mo C

11 sci nort cel E ort e Rylr epS

### Typical Use-Cases

Storage expansion.

Boot options and file systems supported.

### Additional Expansion Options (if applicable)

Description of other possible expansions or optional modules planned or supported.

Information on compatibility and special considerations.

# Assembly Instructions

List of required components

Step-by-step assembly guidance

PCB layout considerations

# Testing and Troubleshooting

Initial power-up tests

Diagnostic routines

Common hardware troubleshooting scenarios and solutions

10 | Sperly Retro Electronics

The µLind board contains 16 different jumpers and on-board connectors that can be used for configuration of board functions.

Jumpers and Internal connectors
ID | Name
J1 | Halt
J2 | ROM Write Enable
J3 | USB Reset Enable
J4 | RGBLed
J5 | Reset
J6 | PWM Speaker
J7 | Pot Connector (For SID board)
J8 | SPI Port
J9 | LightPen (For VDC board)
J10 | CTS Enable (Must be used with J11)
J11 | RTS Enable (Must be used with J10)
J12 | Memory 1M
J13 | Expansion Board
J14 | Expansion Board 2
J15 | (For Future Use)
J16 | 12v In

### J1. Halt connector

This connector lets the user add a Halt button to the µLind board. The halt button lets you halt execution, for debugging or fault tracing purposes for example.

### J2. ROM Write Enable

This jumper, when added, lets you write to the EEPROM. It connects the WR line to the EEPROMS WR input. Special considerations need to be taken of how the EEPROM handles writes.

Sperly Retro Electronics | 7

### el banEt ese R BSU. 3J

ot det cennoc si ecafr et nI BSU eht f o enil TESER eht ecal p ni si r ep muj si ht fI e mit yr ever ell ort noc BSUeht t eser lli wsi hT. dr aob dni Lµ eht no enil TSR eht si ht t uohti w( yll a mr o N. desser p si dr aob dni Lµ eht no nott ub TESER eht det cennoc eht ot noit cennoc eht peek r ell ort noc BSU eht lli w )r ep muj

. st eser gnir udl ani mr et r et up moc

### r edae HdeL BGR. 4J

met sys wohs ot DEL BGR a gnit cennoc r of desu si r edaeh DEL BGR ehT si tI . KO s met sys ll a wohs ot putr at s t a neer g wohs lli w DEL si hT . sut at s

. putr at sr etf a DEL eht l ort noc ot r esu eht r of el bi ssop

r edae Ht ese R. 5J

r edae Hr ekaepS MWP. 6J

) DI Sr of yl n O( r ot cenno Ct oP. 7J

tr oPI PS. 8J

) CDVr of yl n O( r ot cenno CnePt hgi L. 9J

el banE STC. 01J

el banE STR. 11J

### el banE M1. 21J

eht gni dnapxe ,tr op yr o me m yr adnoces eht el bane ot dedda eb ot sdeen r ep muj si hT

. et ybage M1 ot yr o me m

### el banE 1 dr aob noi snapx E. 31J

. dr aob noi snapxet srif eht el bane ot r ep muj si ht tr ohS

### el banE 2 dr aob noi snapx E. 41J

osl a ot dr aobt srif eht seri uqer si hT. dr aob noi snapxe dnoces eht el bane ot r ep muj si ht tr ohS

) 31J eeS( . del bane eb

### desut o N. 51J

. desunu evaeL. desut on ylt nerr uc si r ep muj si hT

### t upnI v21. 61J

er a er ehT. str op noi snapxe eht ot v21r evil ed ot dr aob nodda v21 eht yb desu si r ep muj si hT t aht sdr ac noi snapxe/ nodda eb t hgi m er eht t ub ,fl es ti dr aob dni Lµ eht no r esu v21 on

v21r ehti e eri uqer lli wdr aob nodda oi dua DI S a el p maxer oF. v5 naht egatl ov r ehgi h eri uqer

. noi sr ev DI S no gni dneped v9r o

### ) 3 & 2 sr ep muJ( noit ar ugif no Cr ep muJ STR/ STC

. sl angi s STR/ STCeht f o noit pir cse D

. 3 & 2 sr ep muj gni su STR/ STCer ugif noc ot wo H

. sesac esul aci pyt dna sgnitt es dedne mmoce R

### snoit ar ugif no Cr ep muJr eht O

. dr aob eht not neser p sr ep muj noit ar ugif nocl anoiti dda ynaf o egasu dna noit anal px E

## )l anoit p O( dr aoB no- ddA hsal Ft cap mo C

### no- ddA hsal Ft cap mo Ceht ot noit cudort nI

. stif eneb dna ser ut aeF

. snoit ar edi snoc noit all at sni dna ytili bit ap moc er a wdr a H

### snoit curt snI noit all at snI

. er udecor p noit all at sni pet s- yb- pet S

. sr ep muj dna snoit cennoc yr assece N

### put eS dna noit ar ugif no C

. noit ar aper p dna gnitt a mr of evir d hsal Ft cap mo C

.tr oppus hsal Ft cap mo Cel bane ot noit ar ugif noc er a wmri F/ SOI B

9 sci nort cel E ort e Rylr epS
