MicroLind-Developers/microlind/docs/Stage3/schematics.pdf

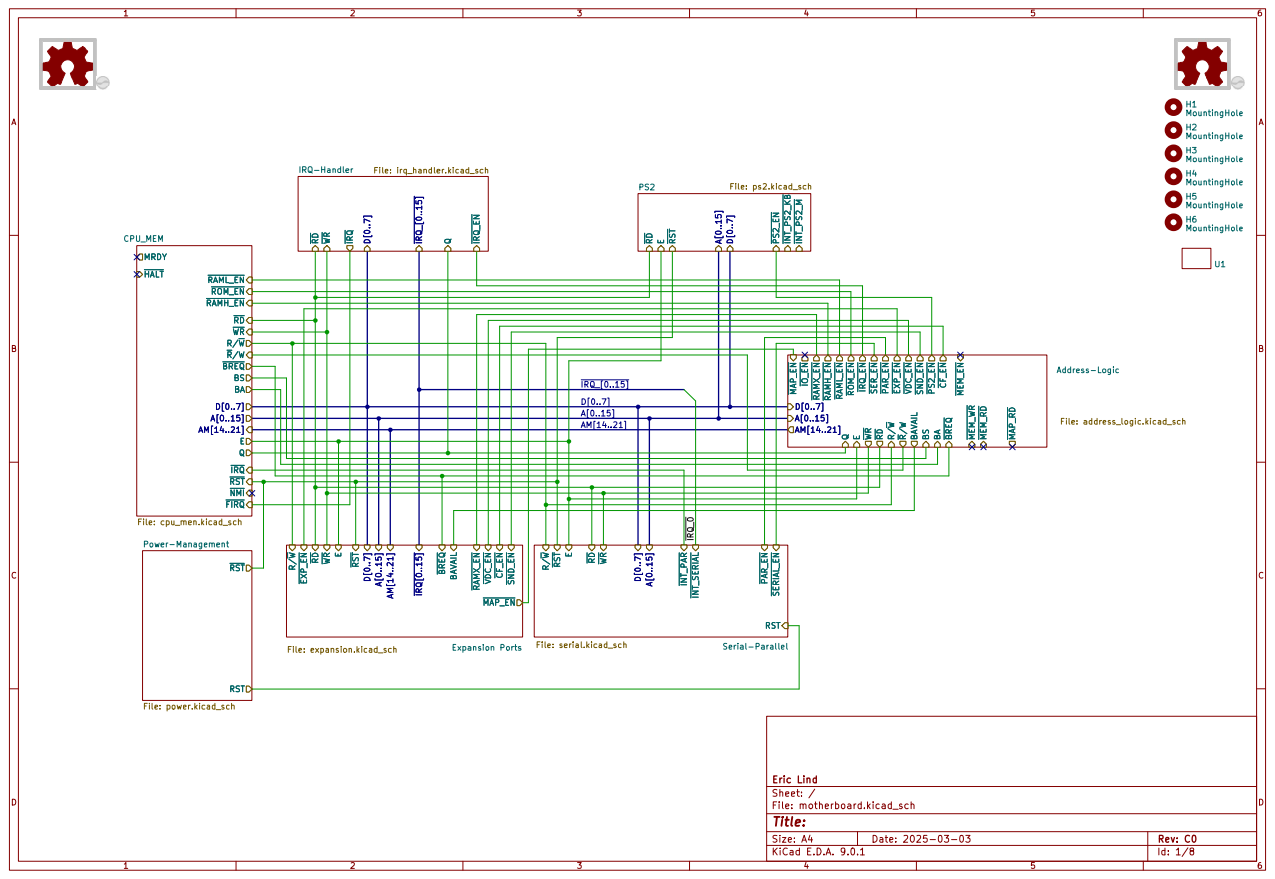
[picture p36: page 1]

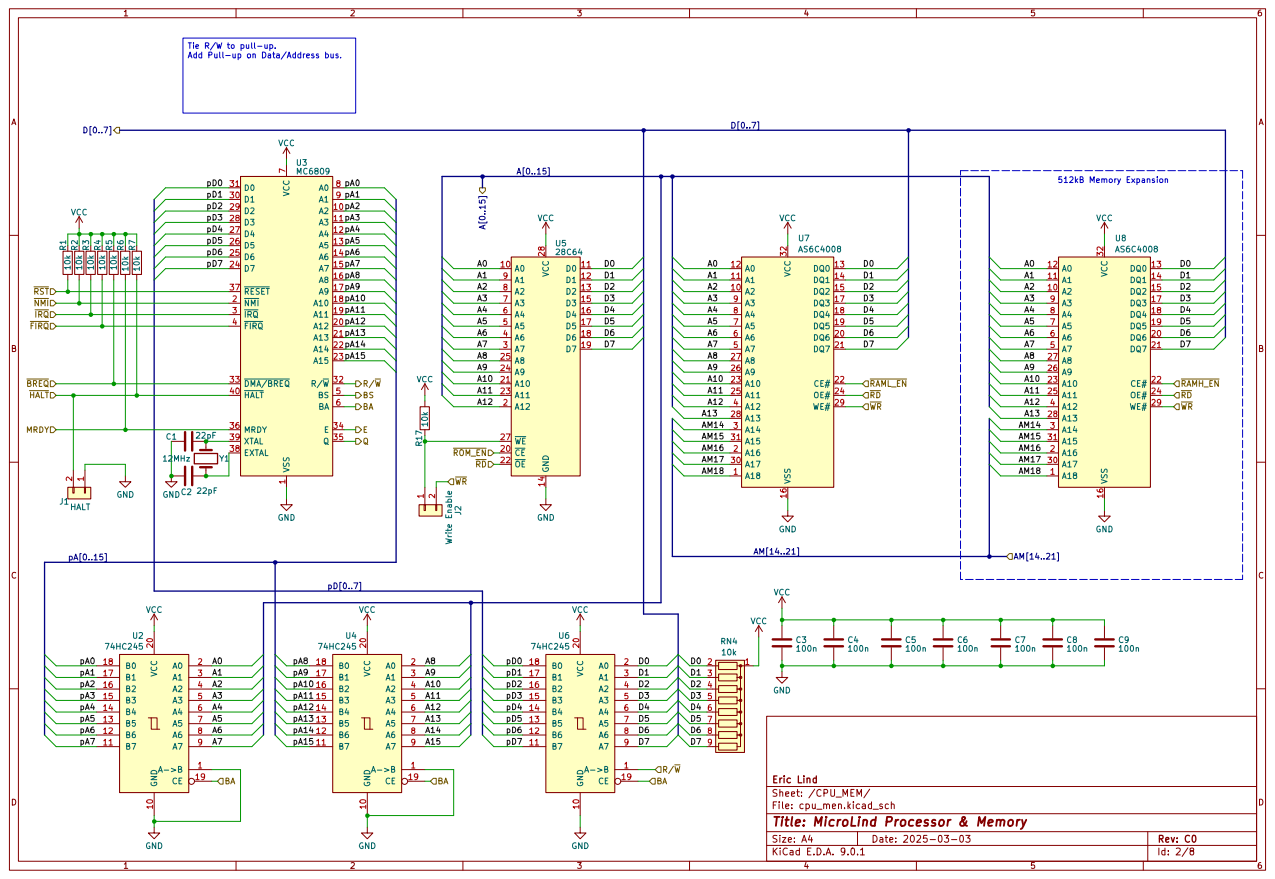
[picture p37: page 2]

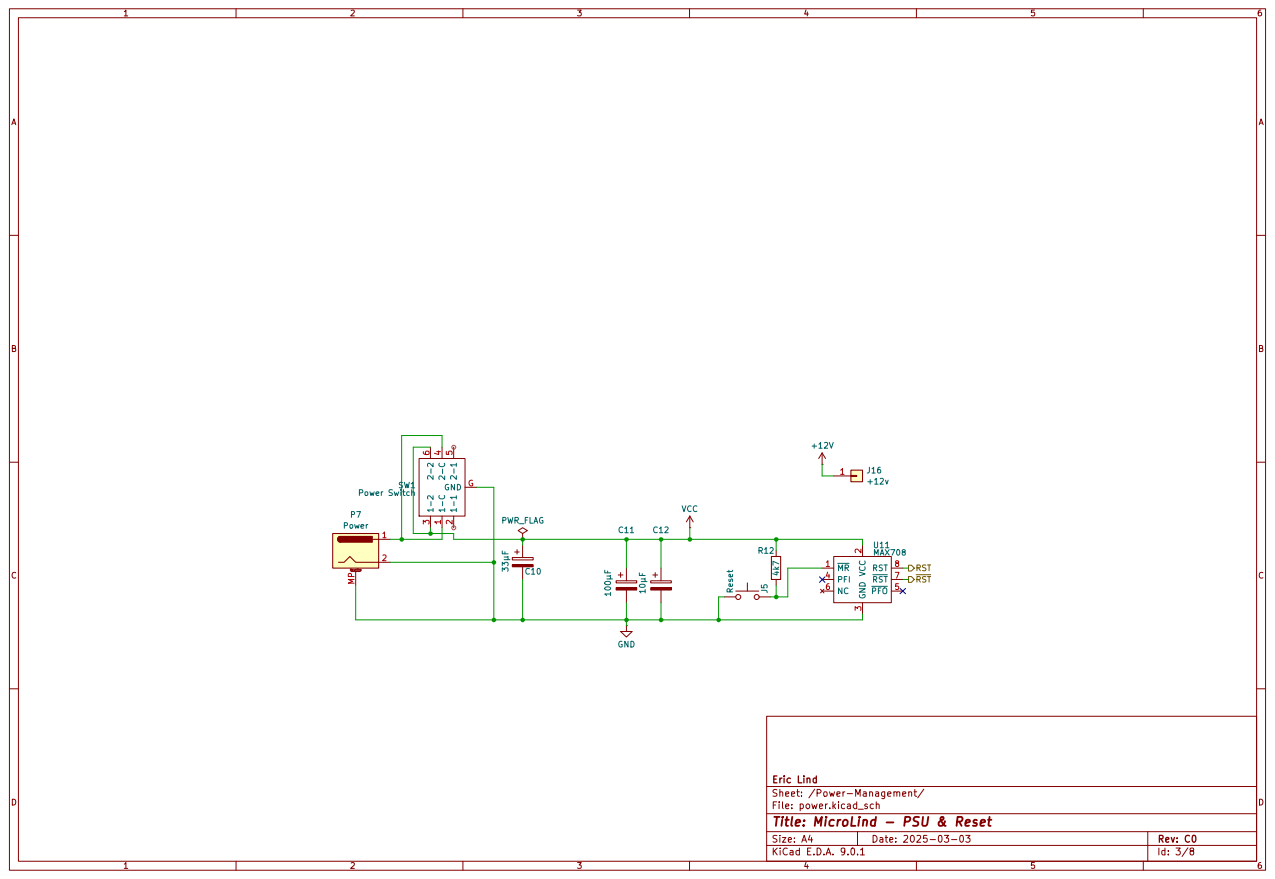
[picture p38: page 3]

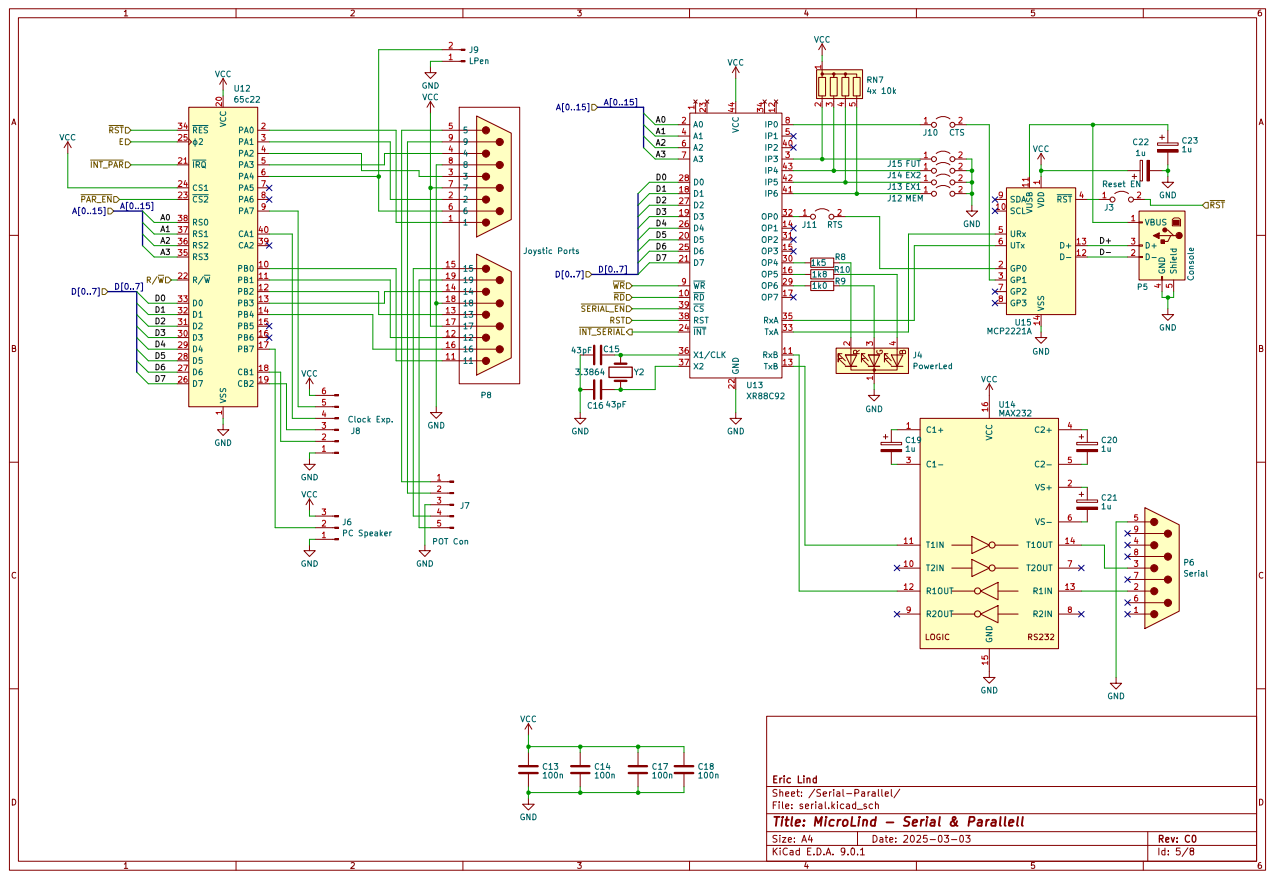
[picture p39: page 4]

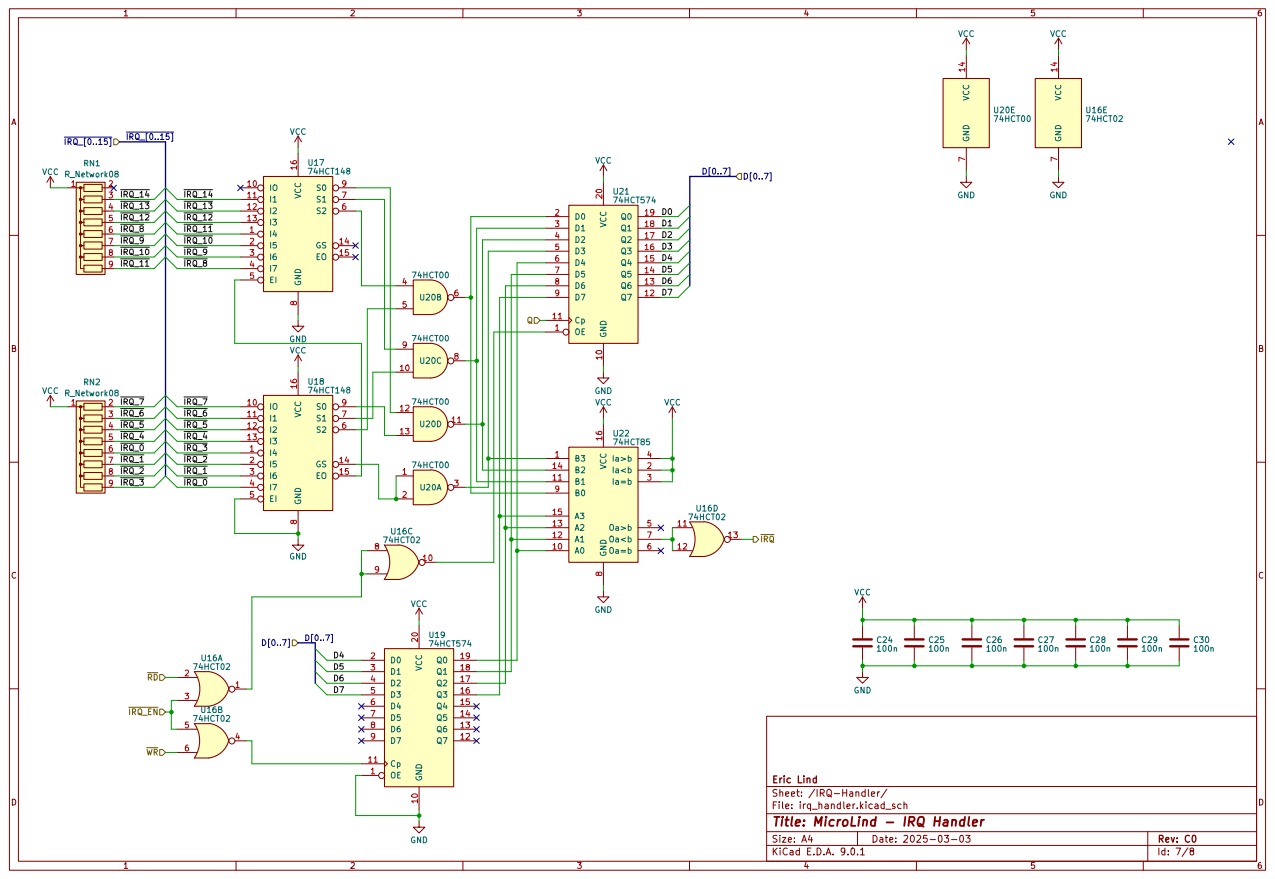
[picture p40: page 5]

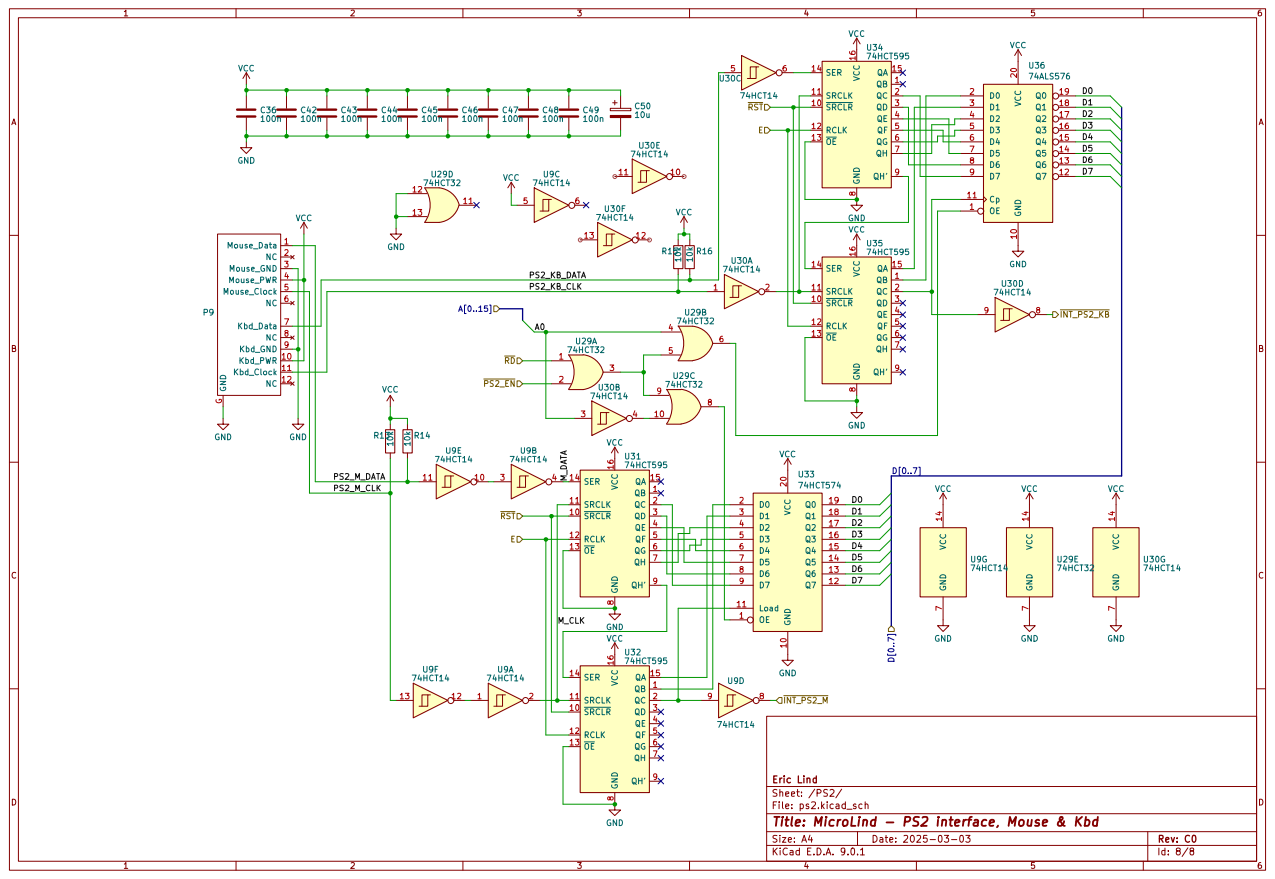
[picture p41: page 6]

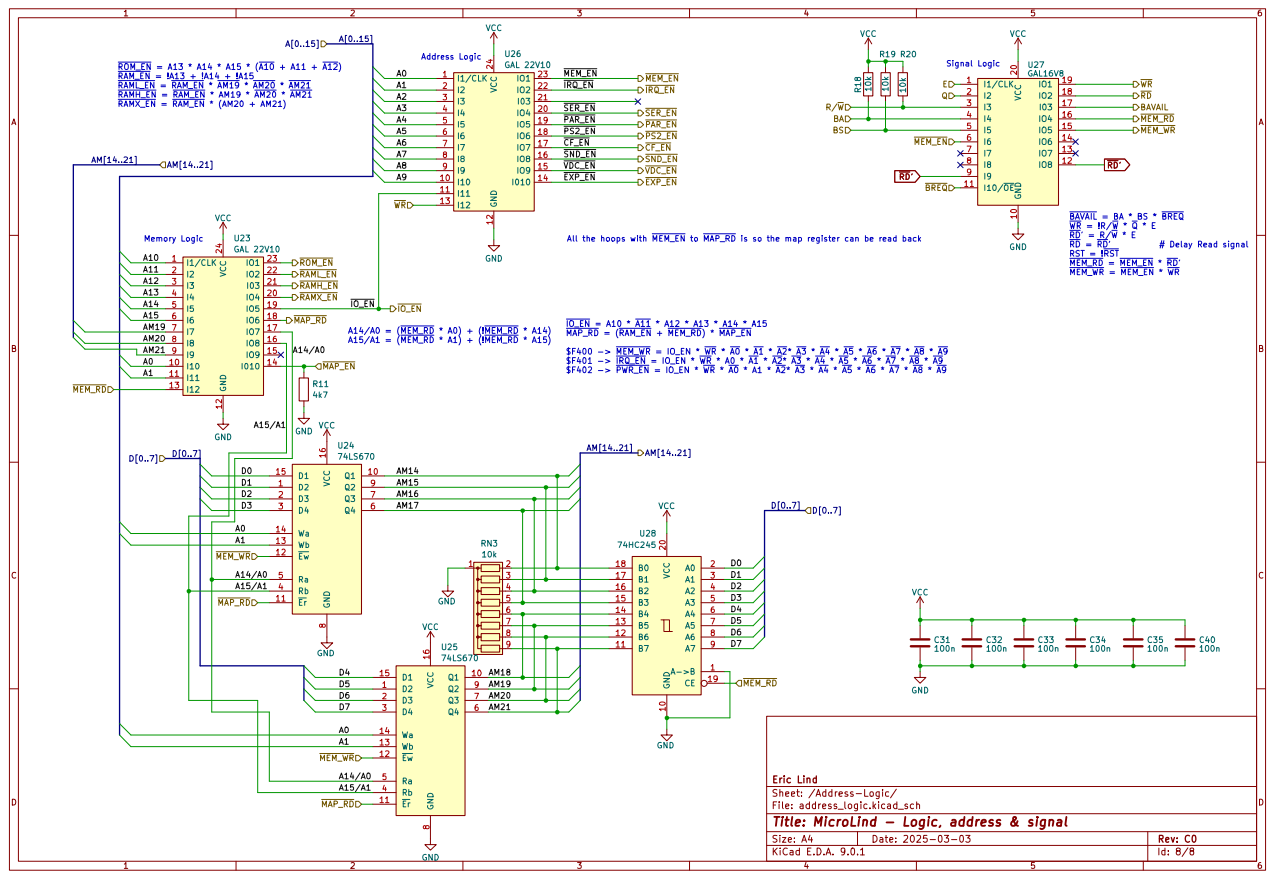
[picture p42: page 7]

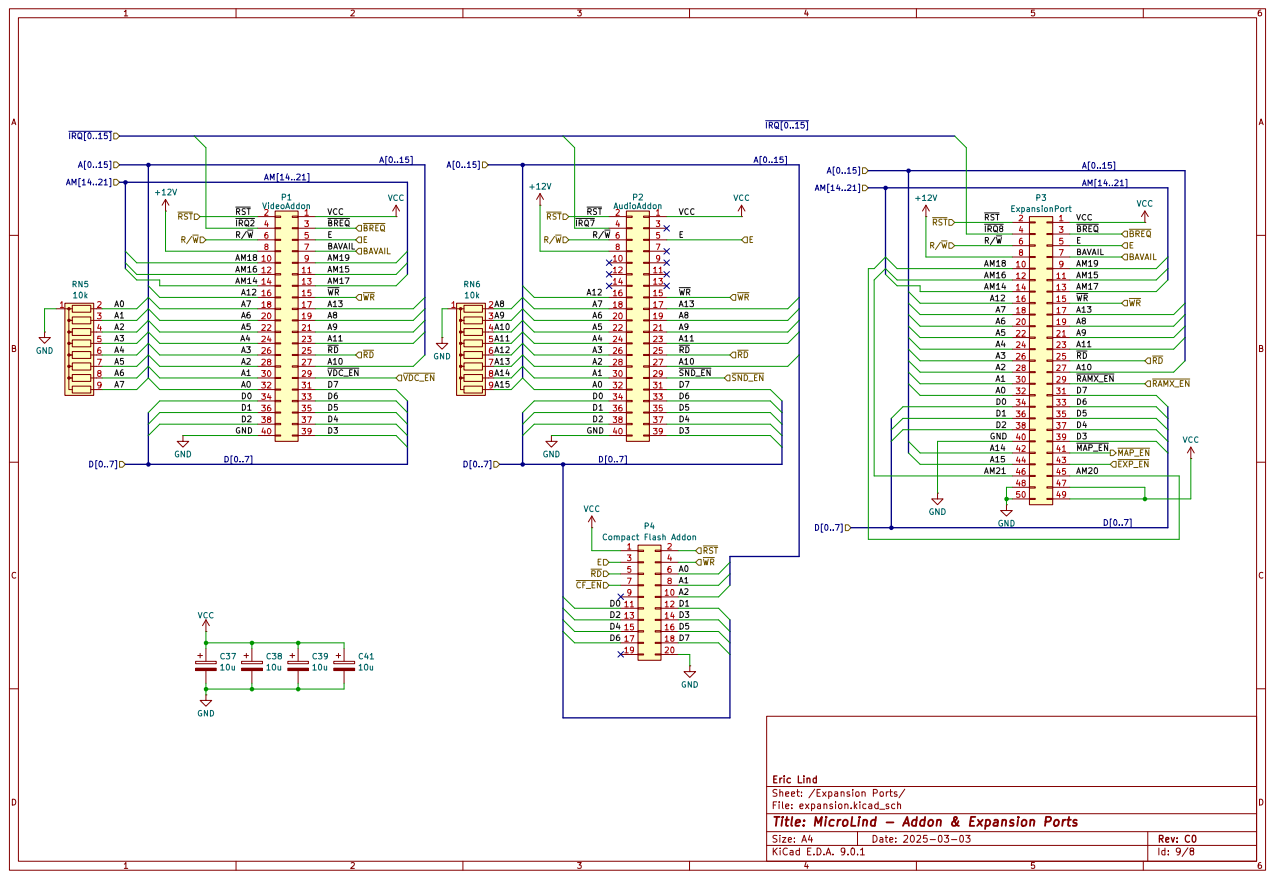
[picture p43: page 8]
