MicroLind-Developers/microlind/releases/stage1/schematics_stage1.pdf

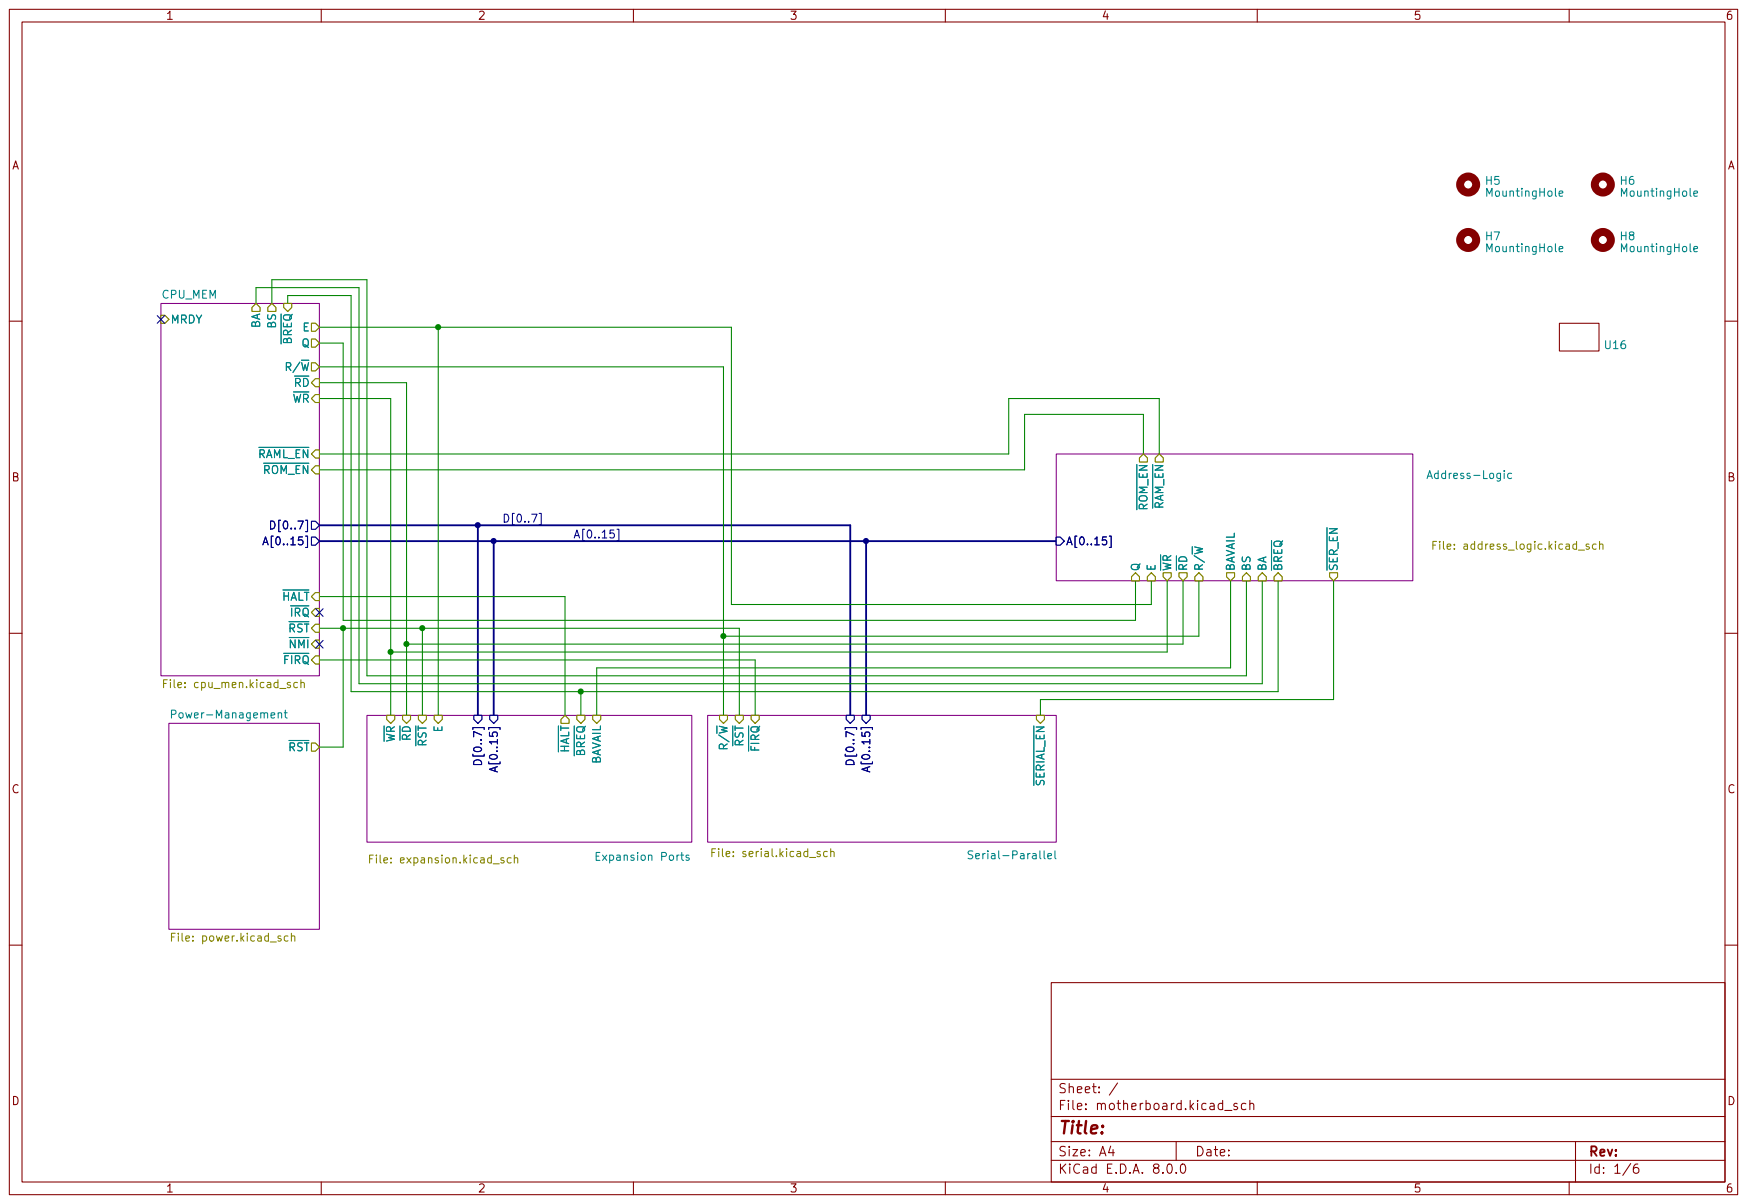
[picture p44: page 1]

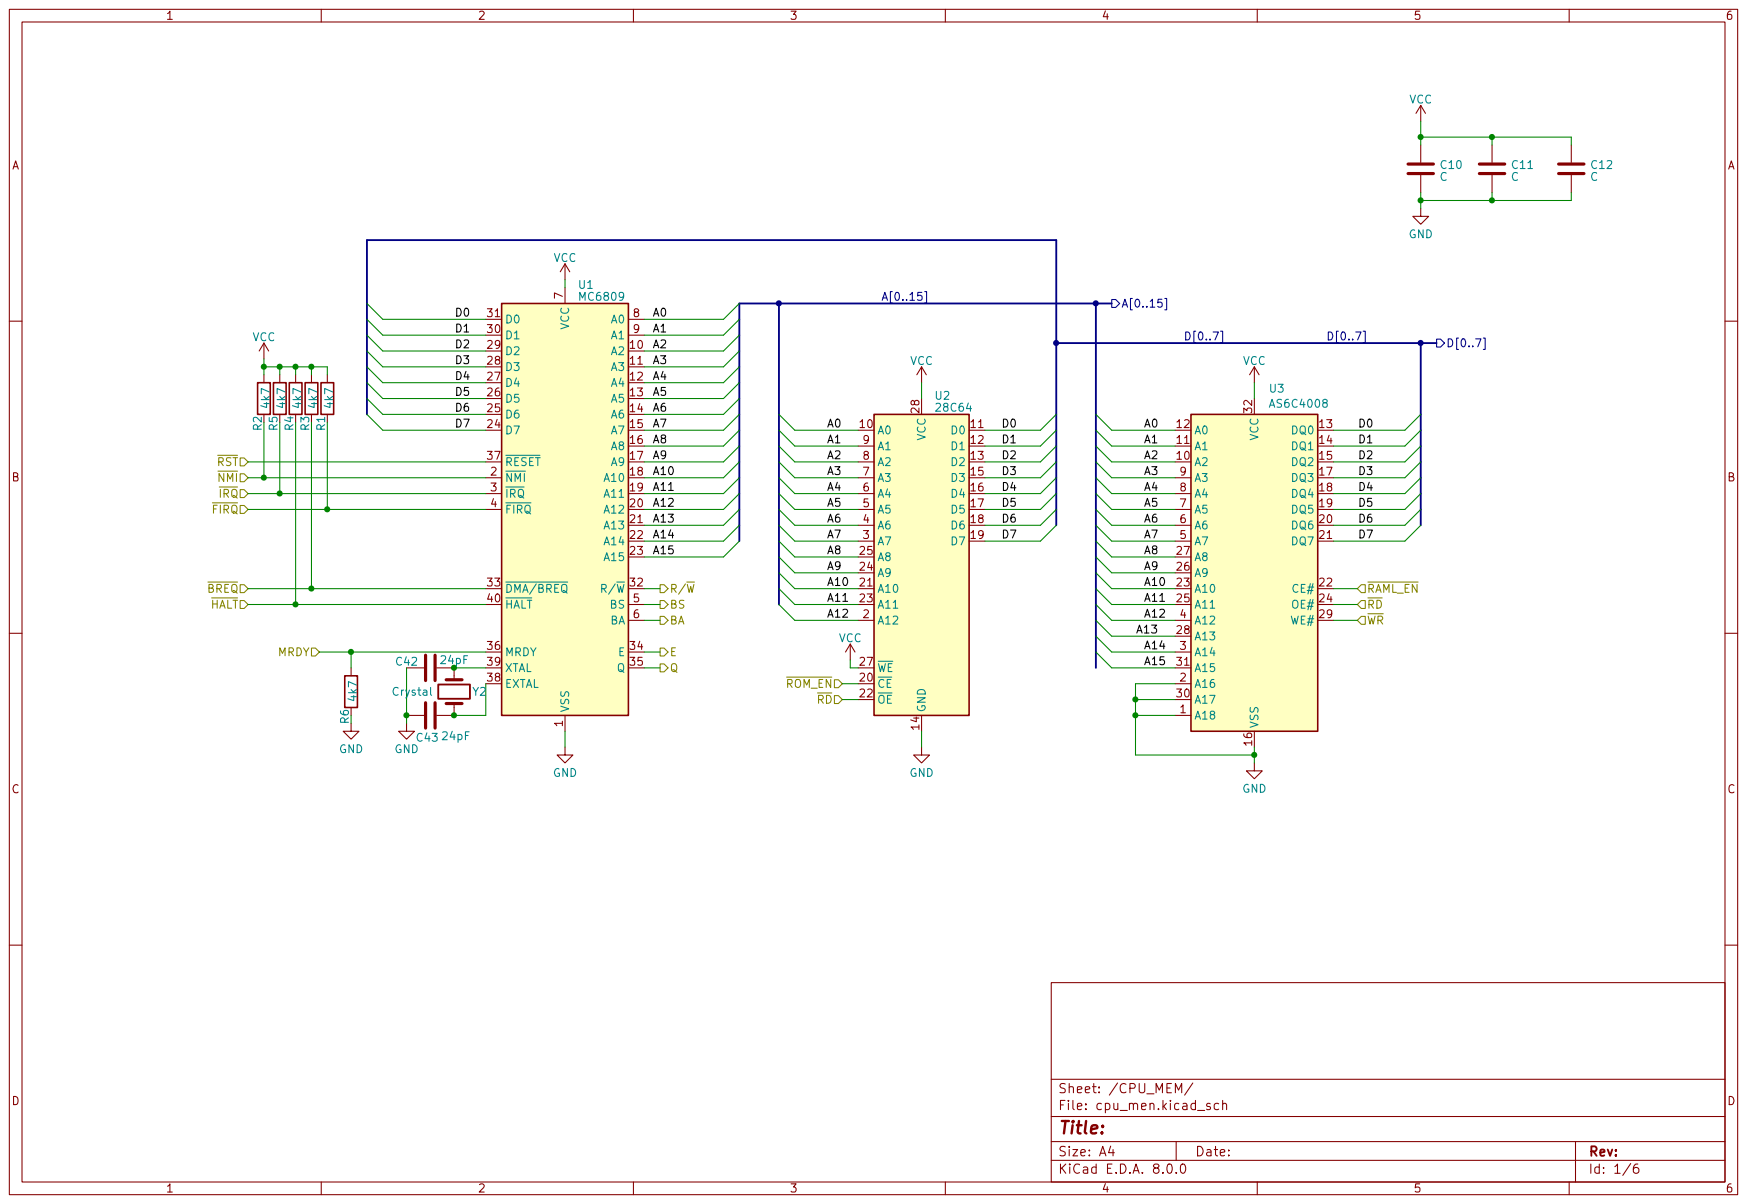
[picture p45: page 2]

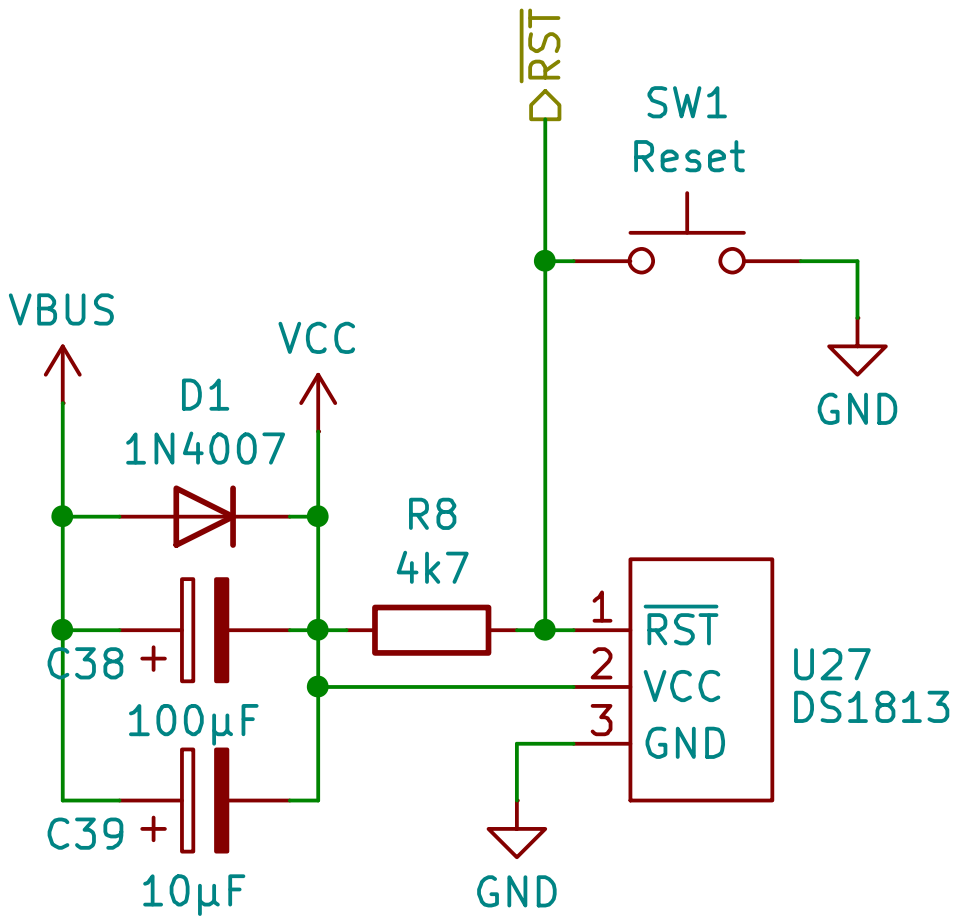
[picture p46: page 3]

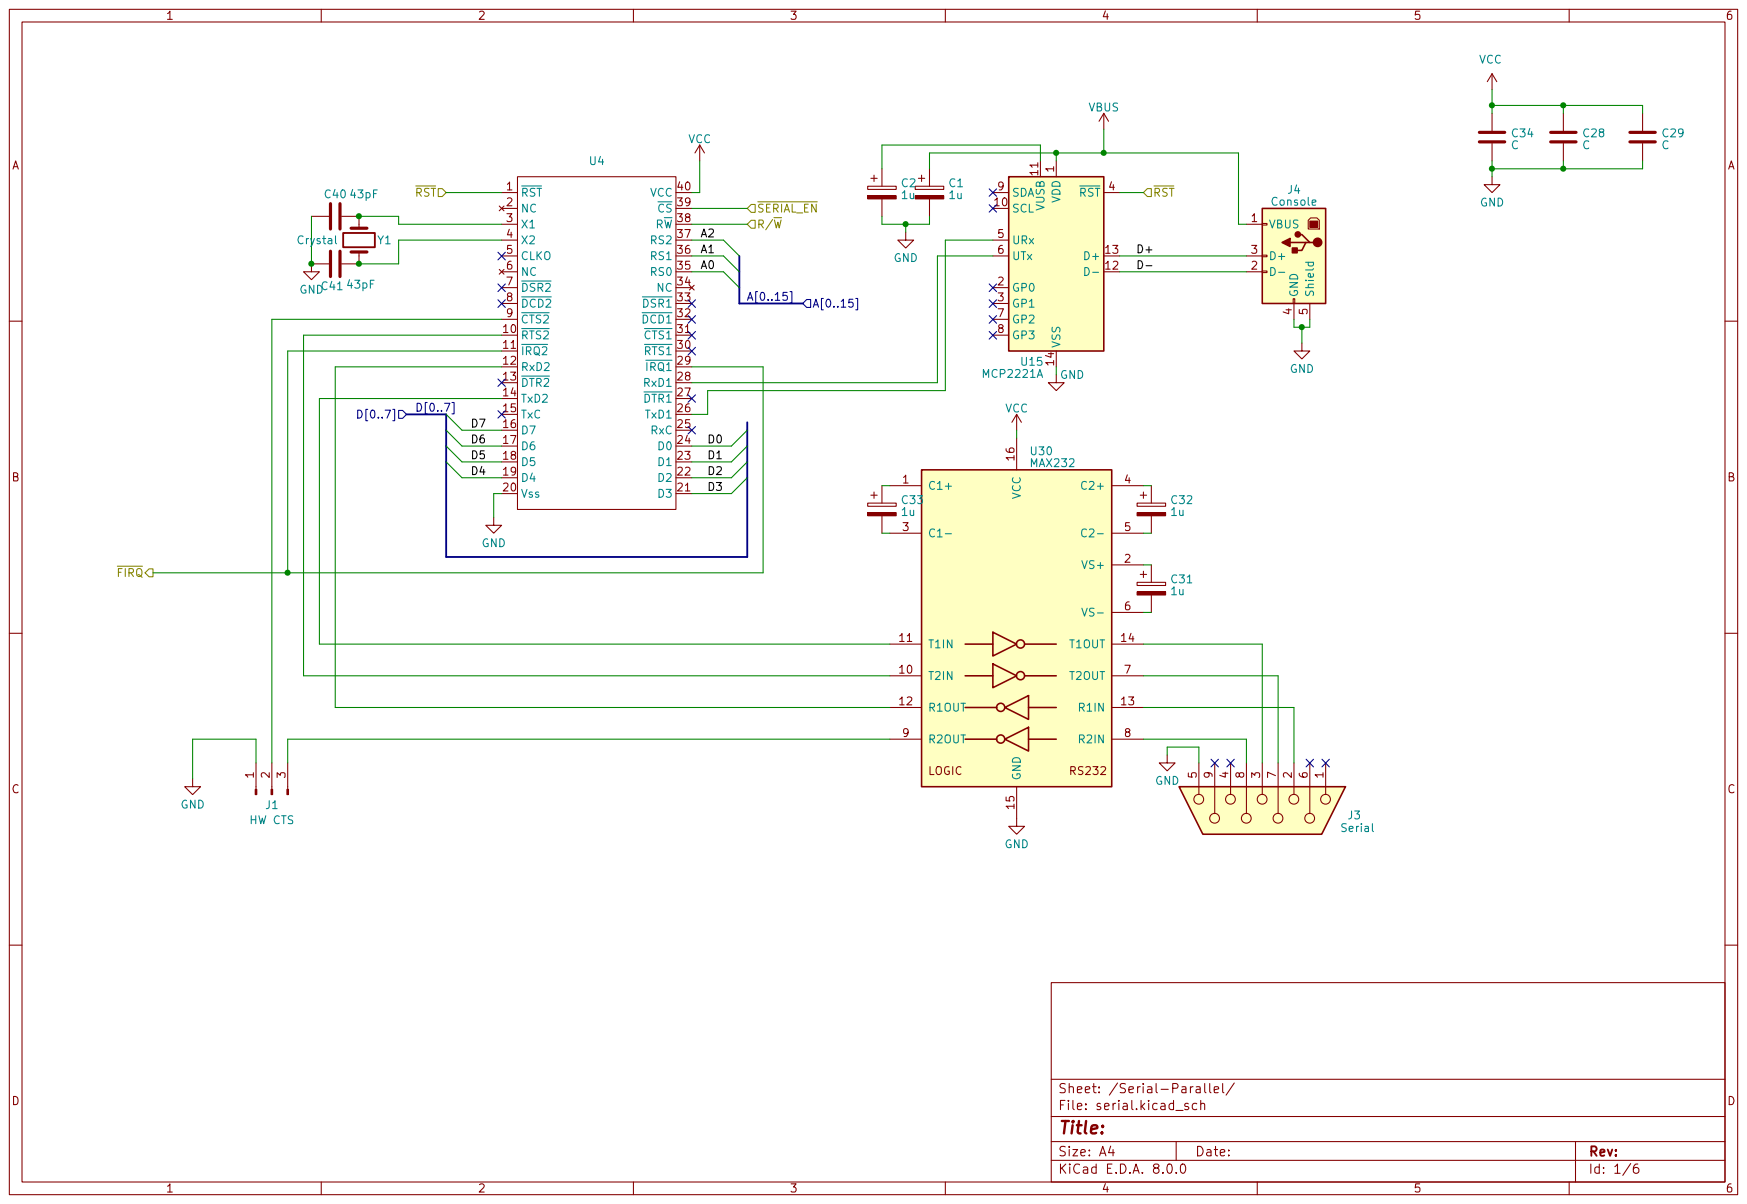
[picture p47: page 4]

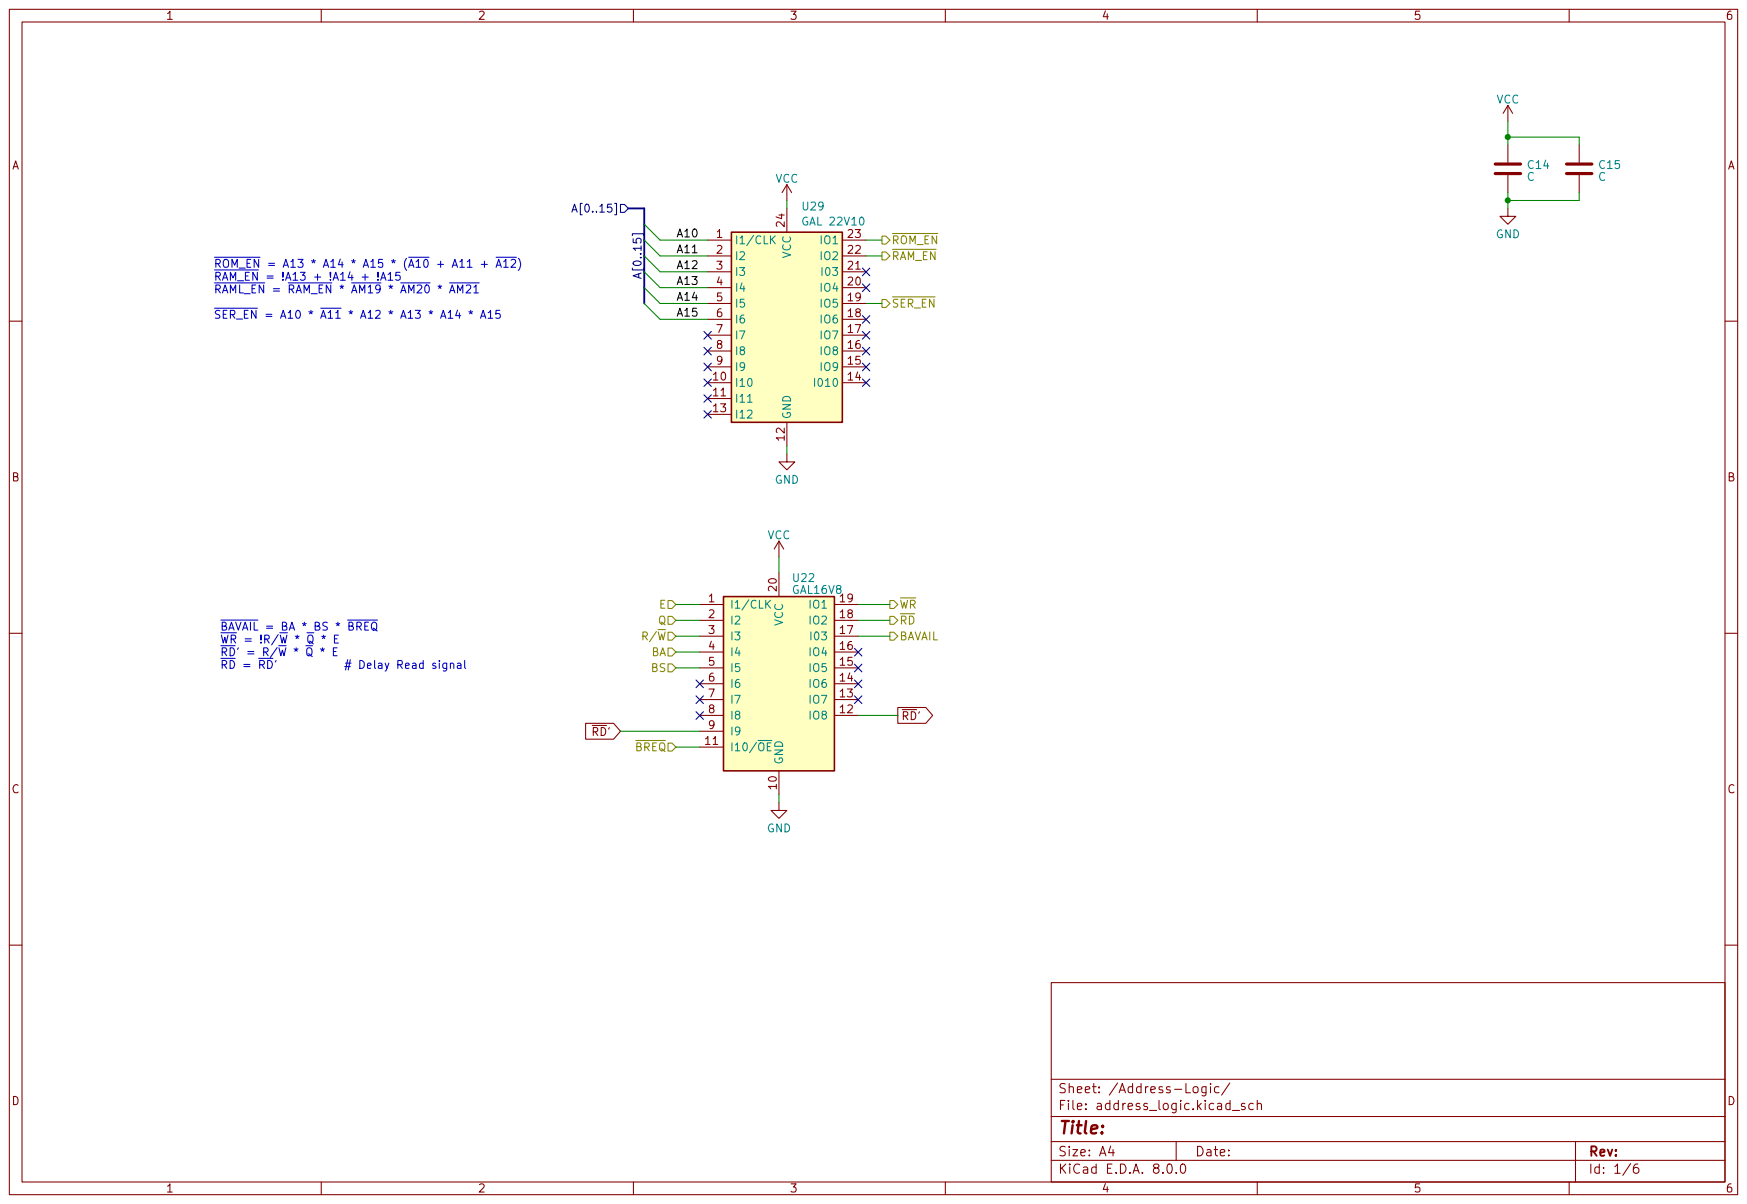
[picture p48: page 5]

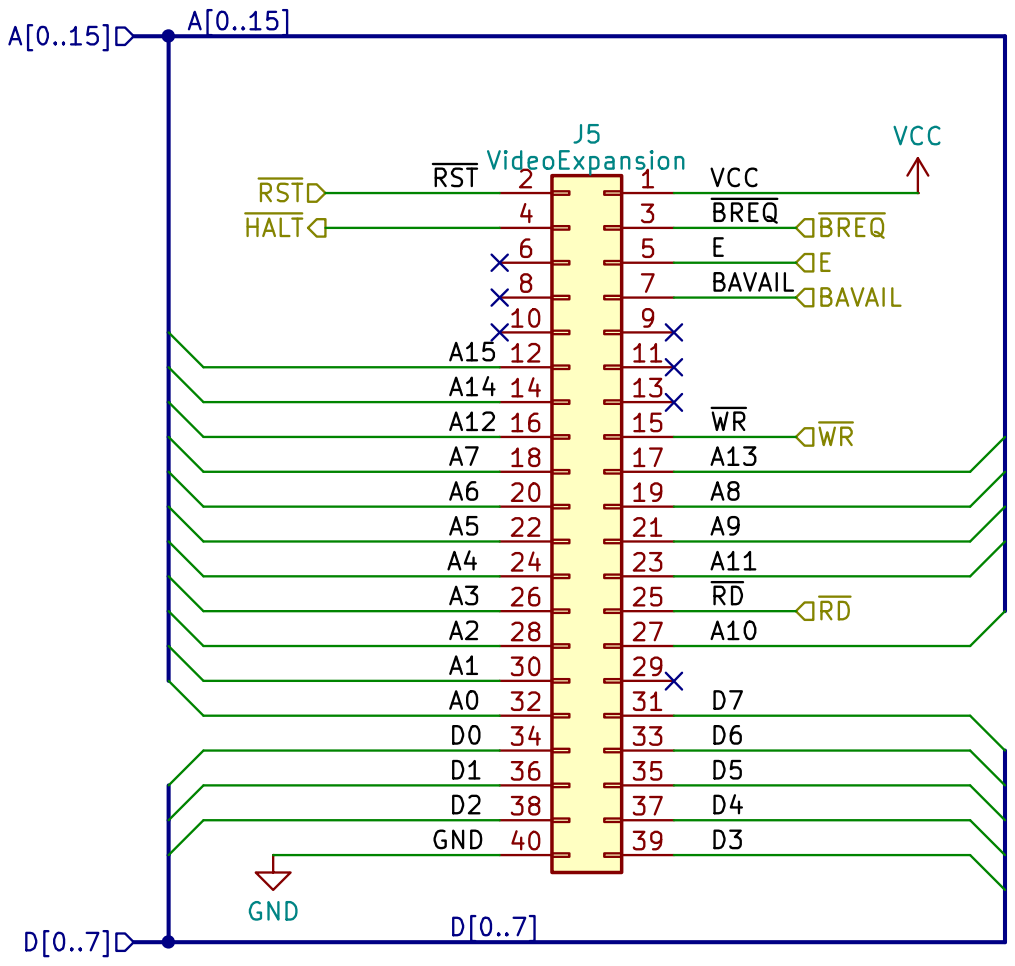
[picture p49: page 6]
