MicroLind-Developers/microlind/docs/AudioExpansionCard/Schematics.pdf

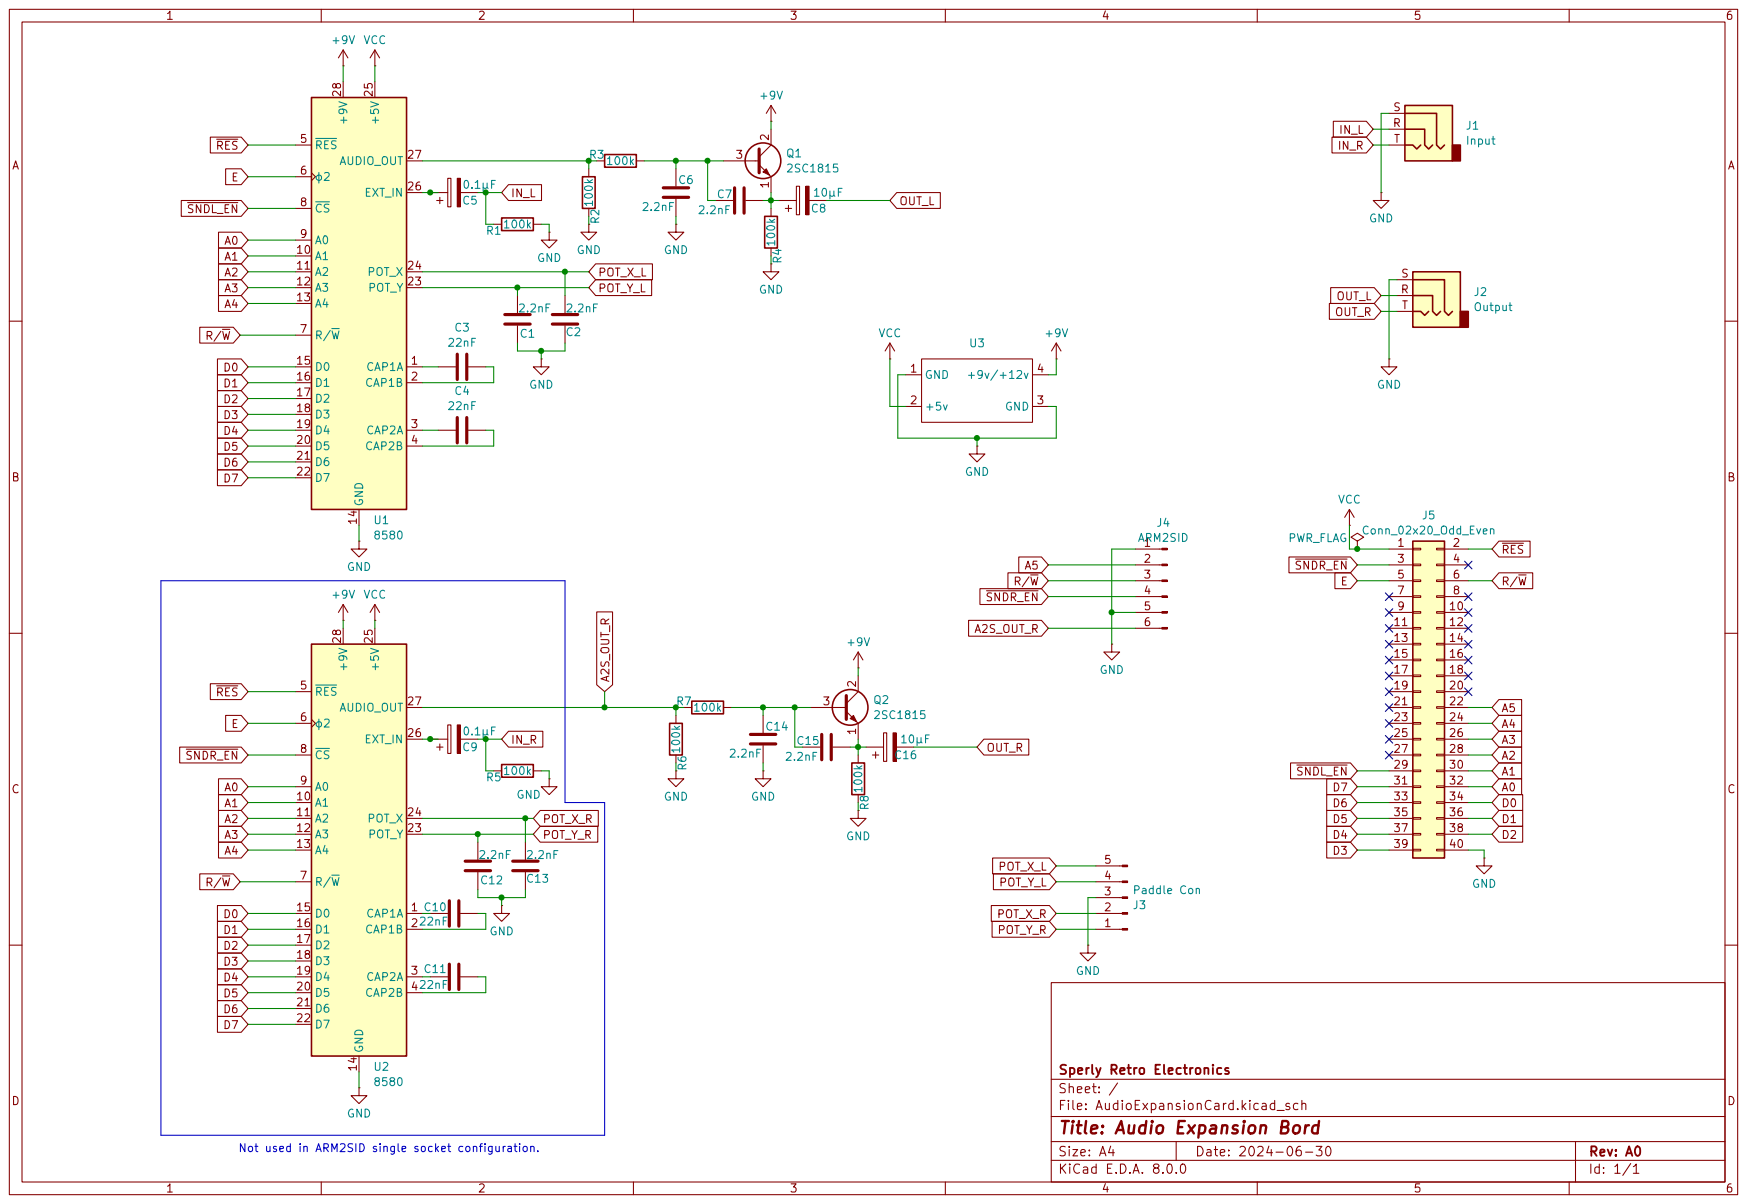
[picture p50: page 1]
