MicroLind-Developers/microlind/docs/µLind Motherboard - Ports.pdf

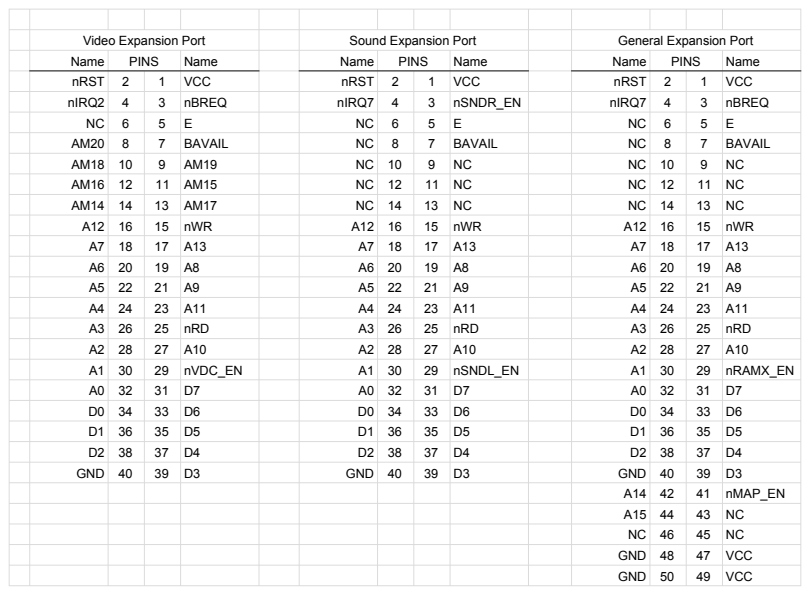
[picture p51: page 1]
