MicroLind-Developers/microlind/releases/stage2/motherboard-stage2.pdf

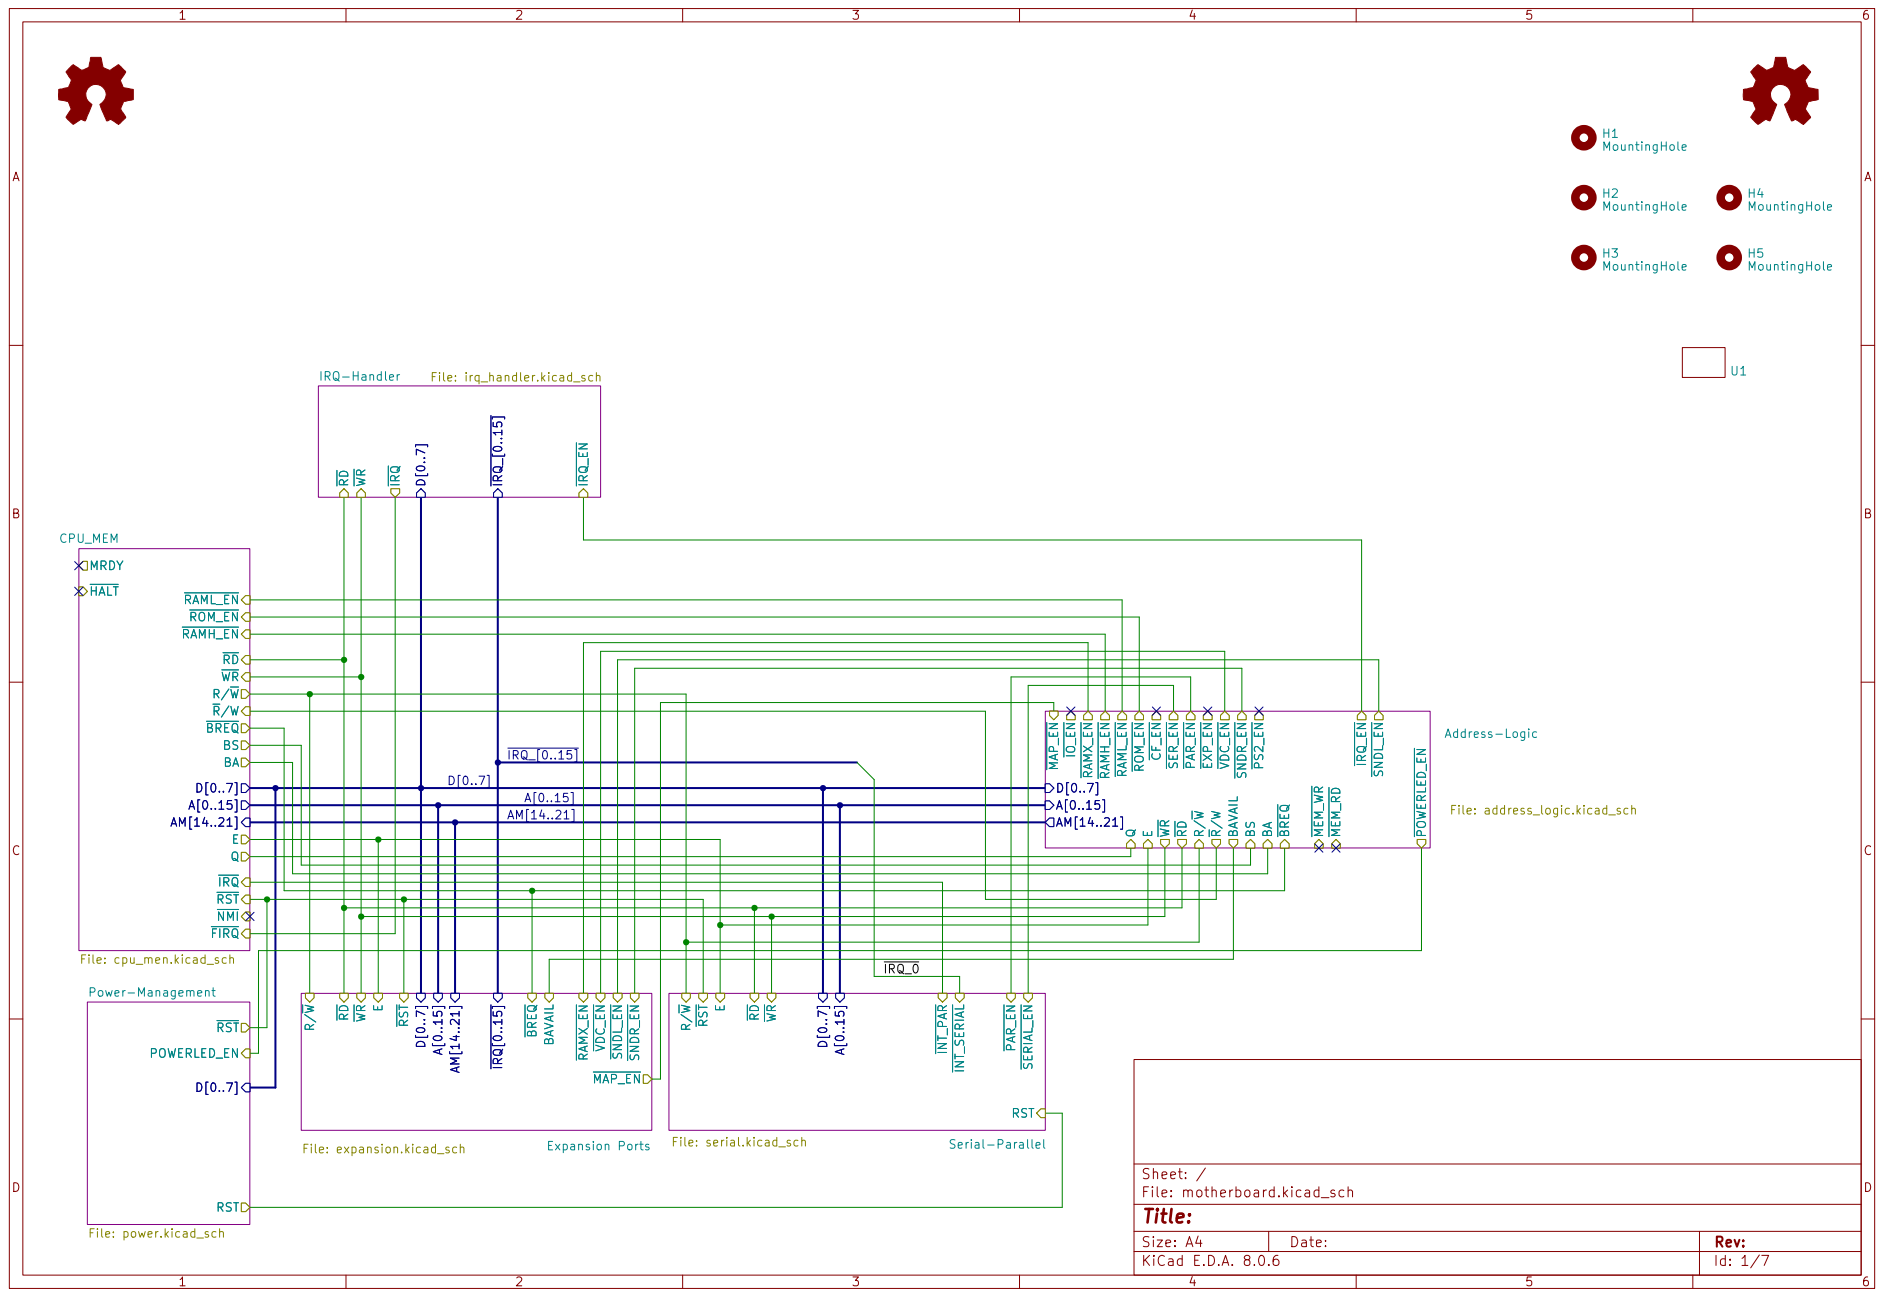
[picture p52: page 1]

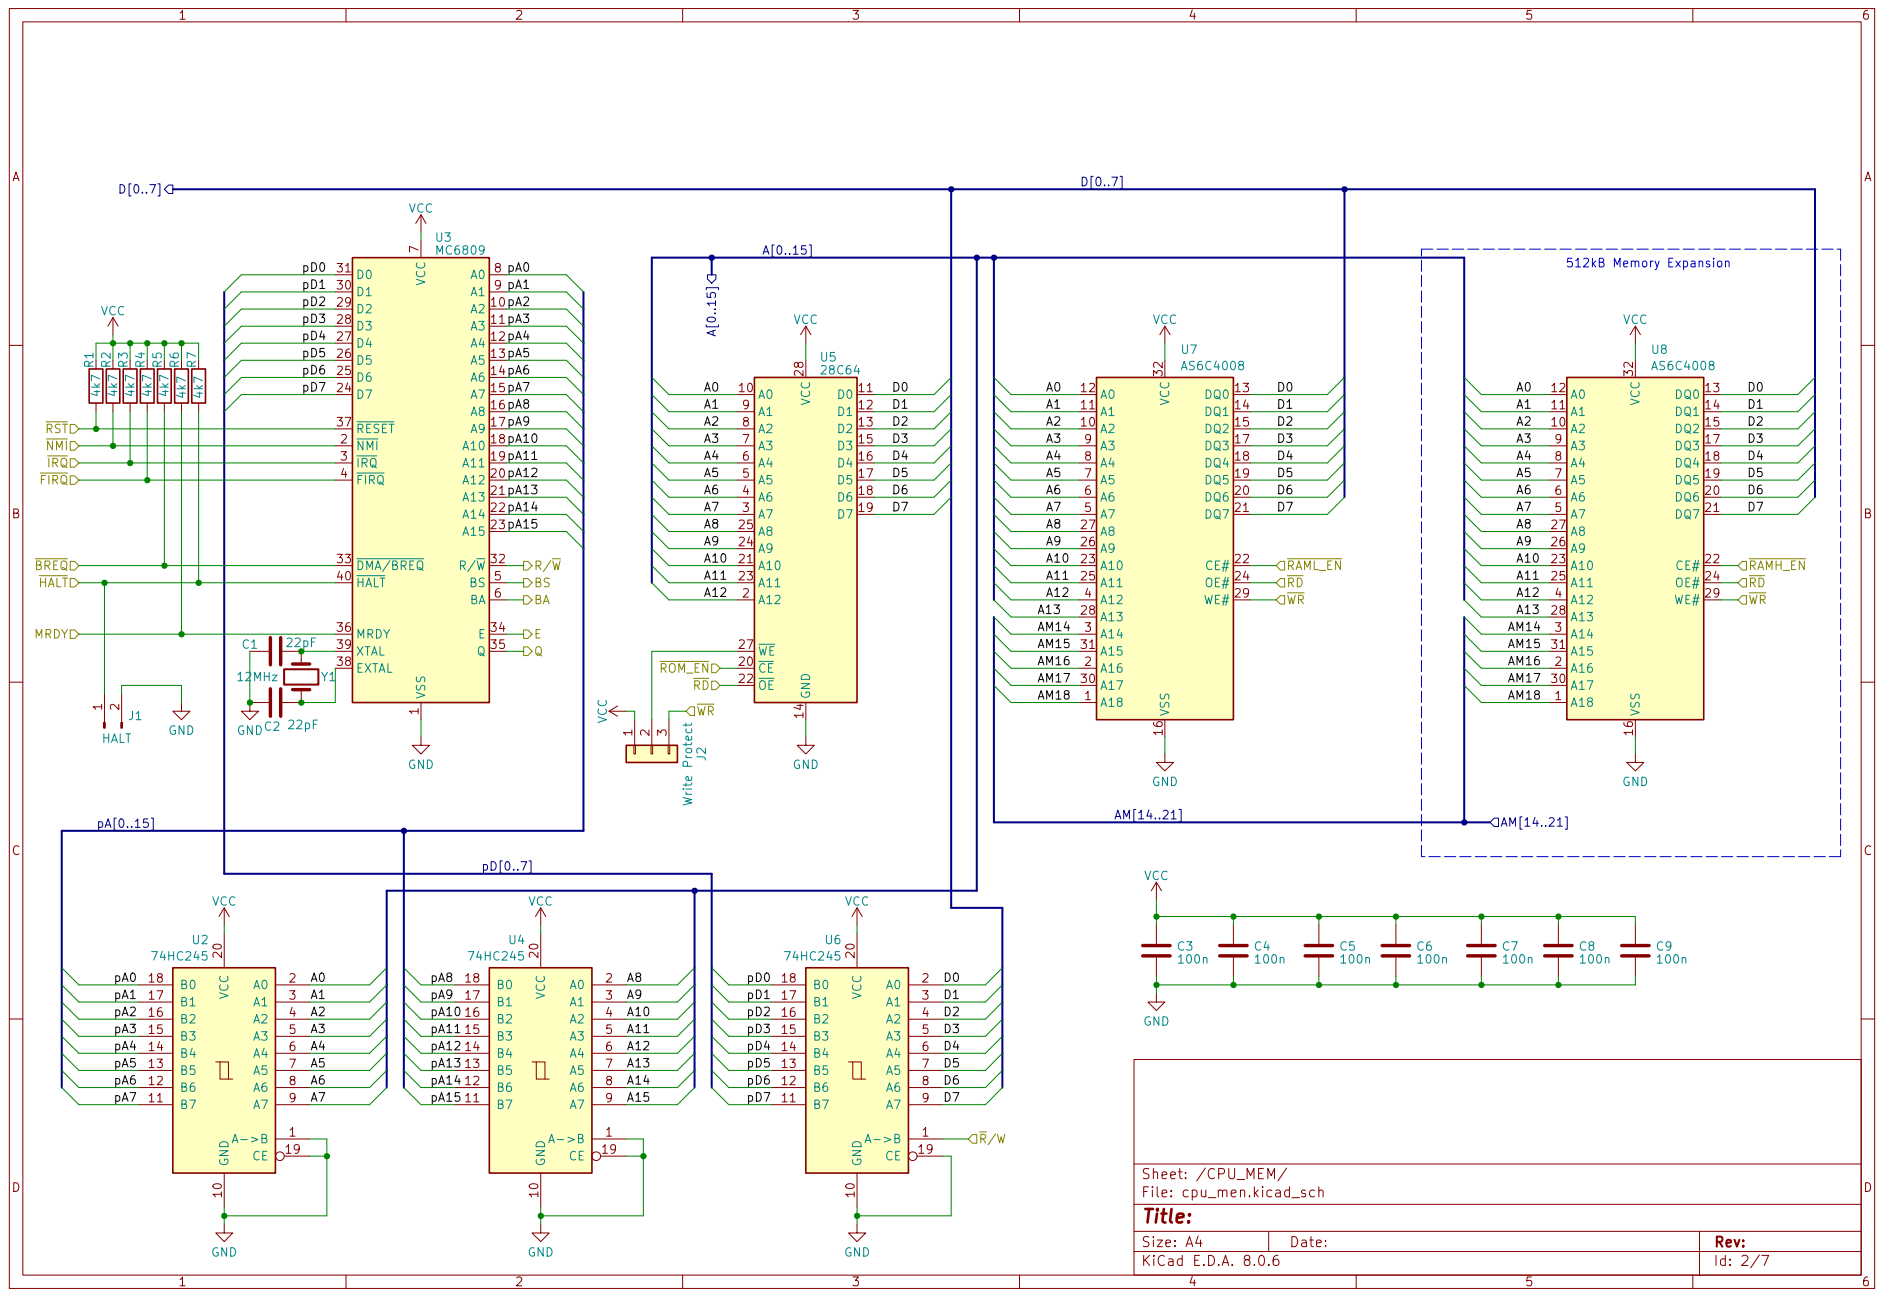
[picture p53: page 2]

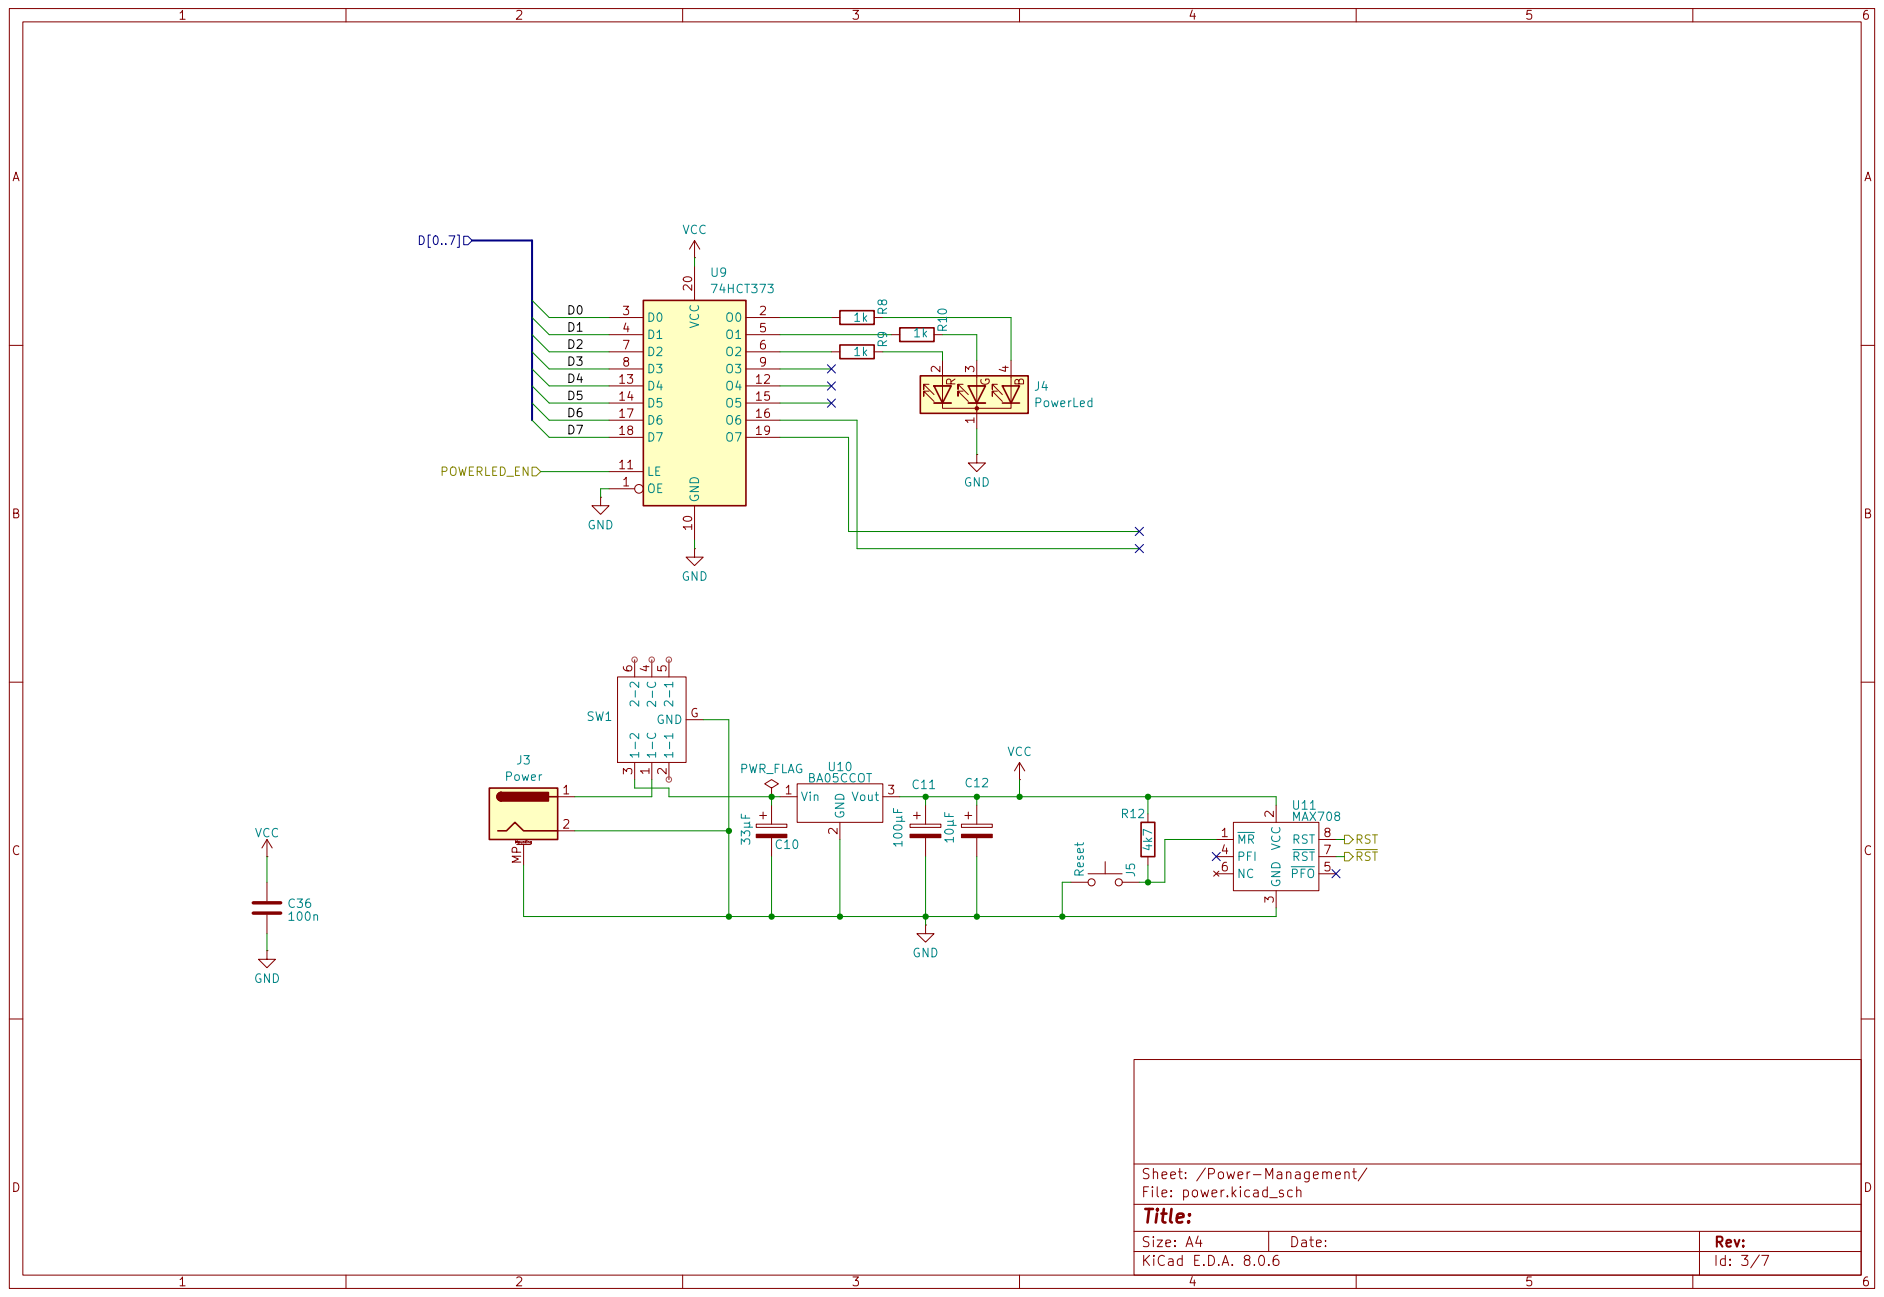
[picture p54: page 3]

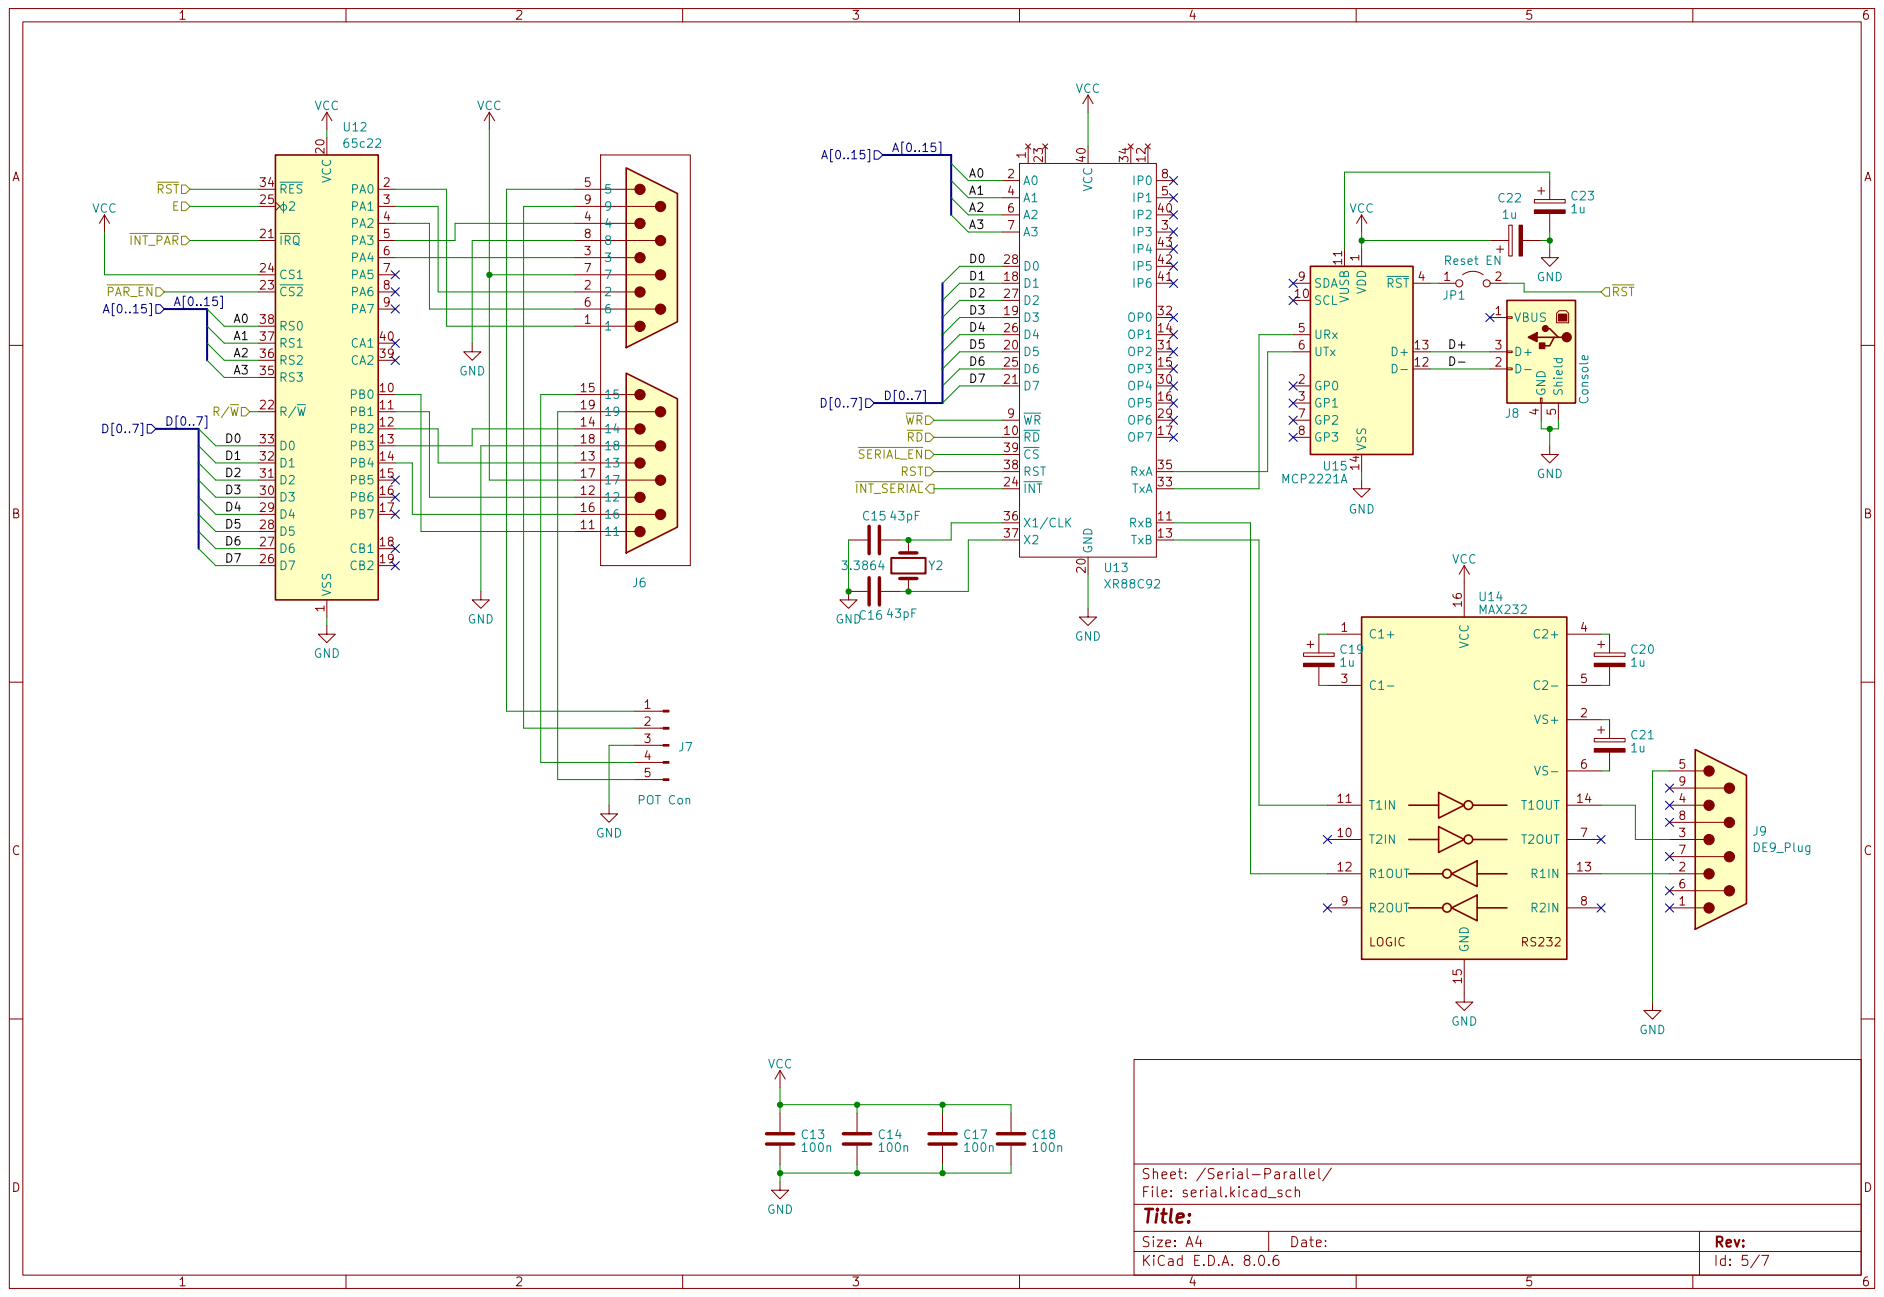
[picture p55: page 4]

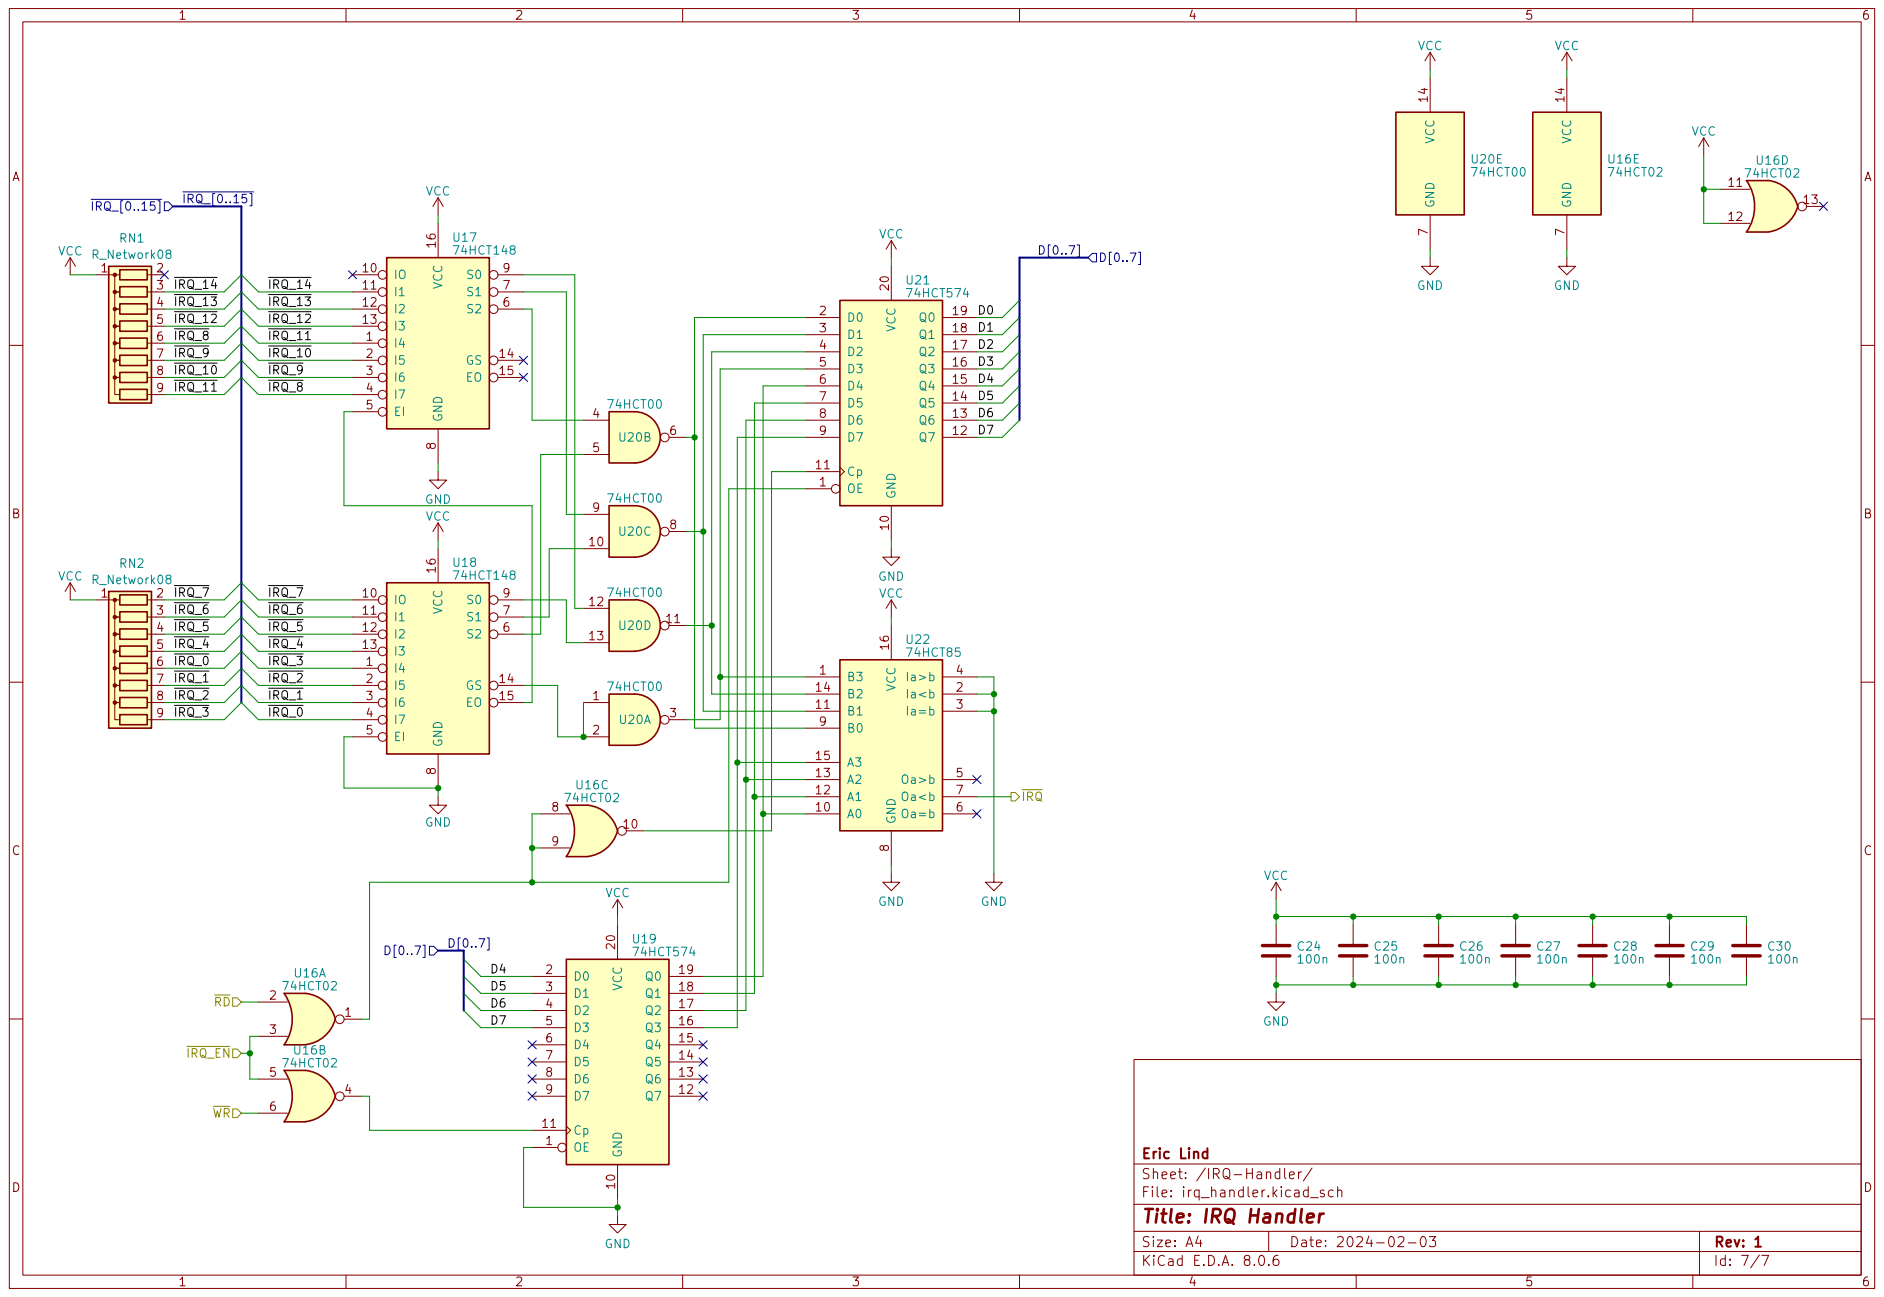
[picture p56: page 5]

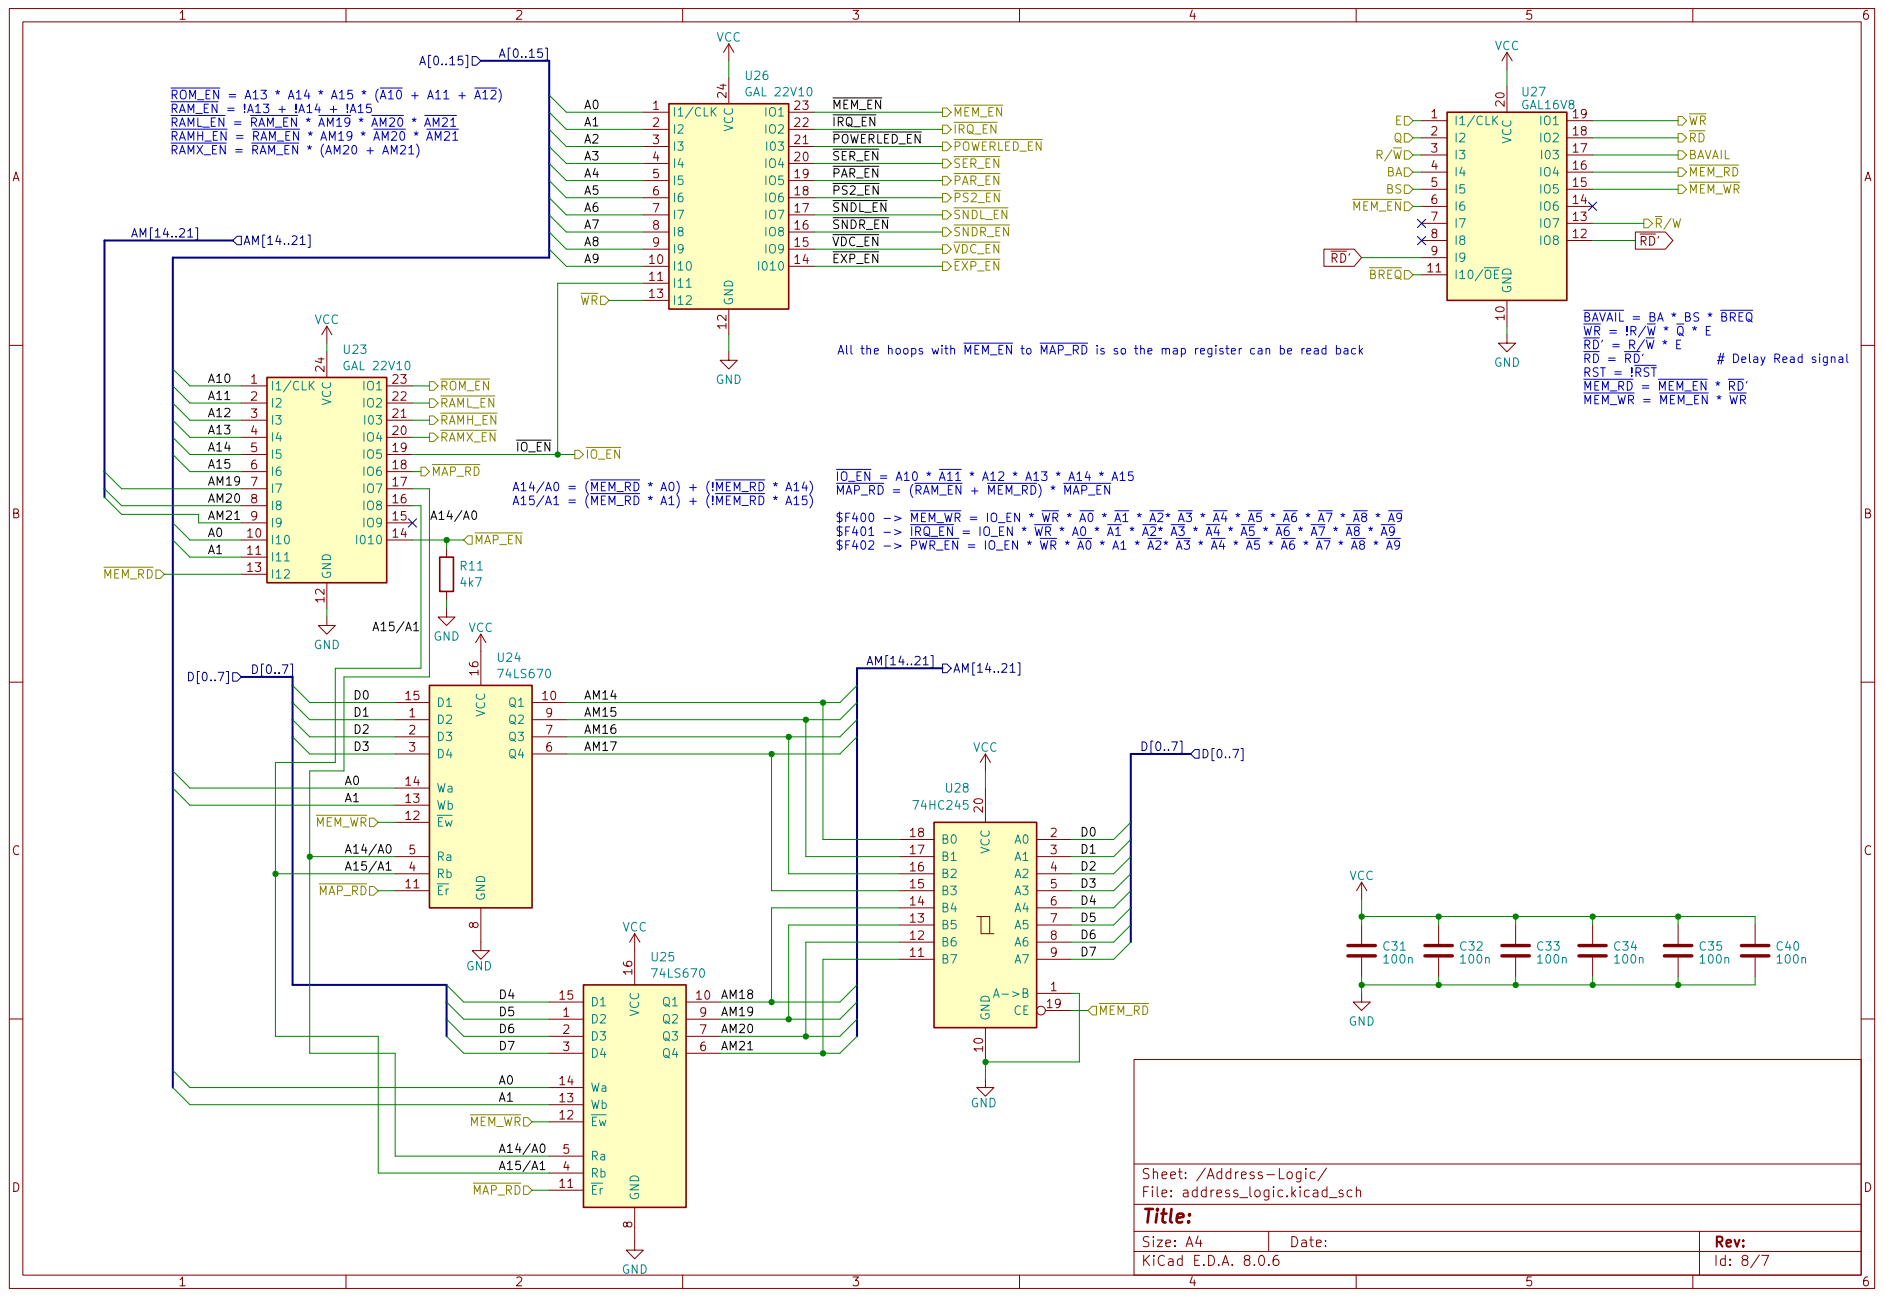
[picture p57: page 6]

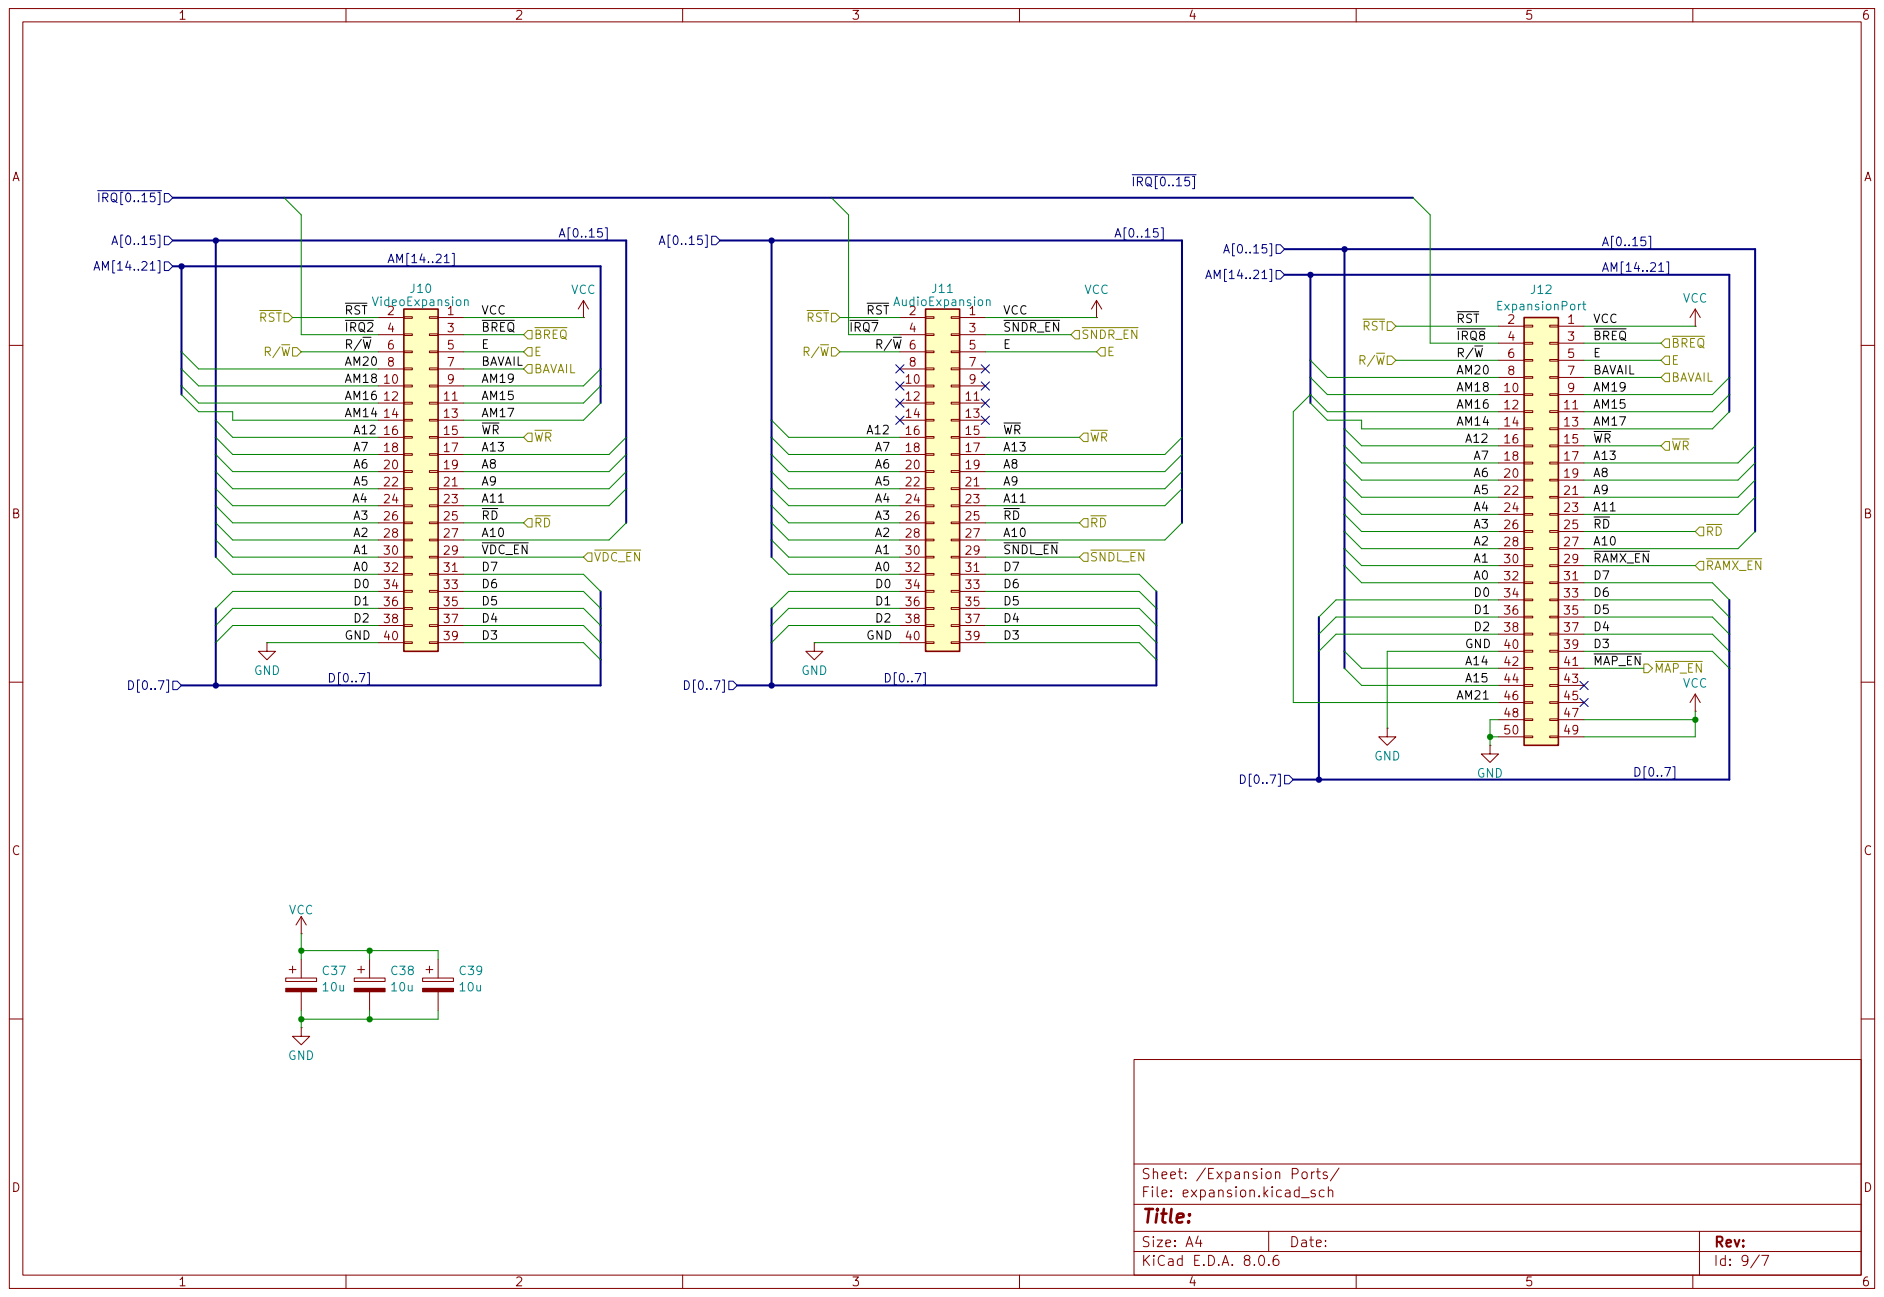
[picture p58: page 7]
