MicroLind-Developers/microlind/releases/stage1/board.pdf

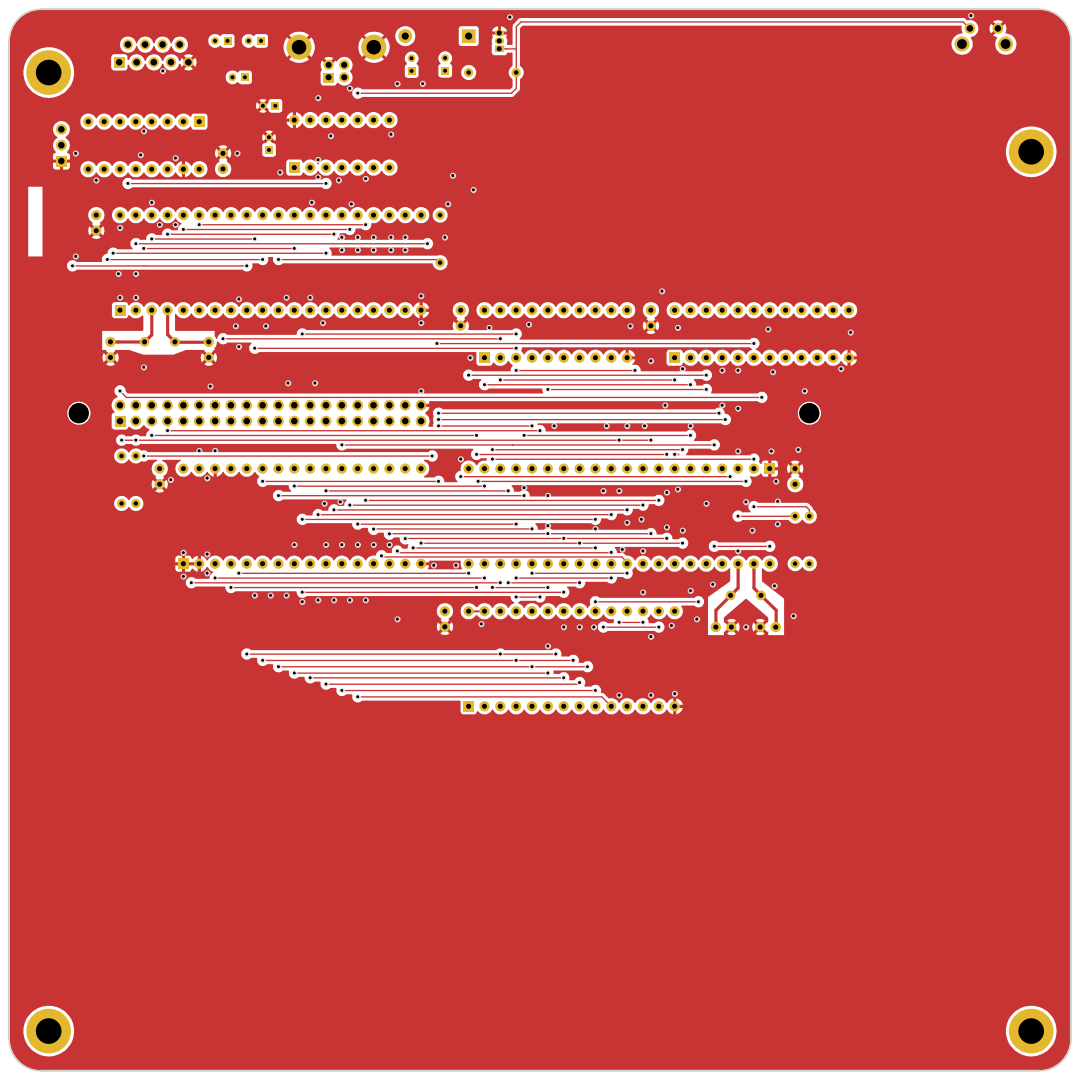
[picture p59: page 1]

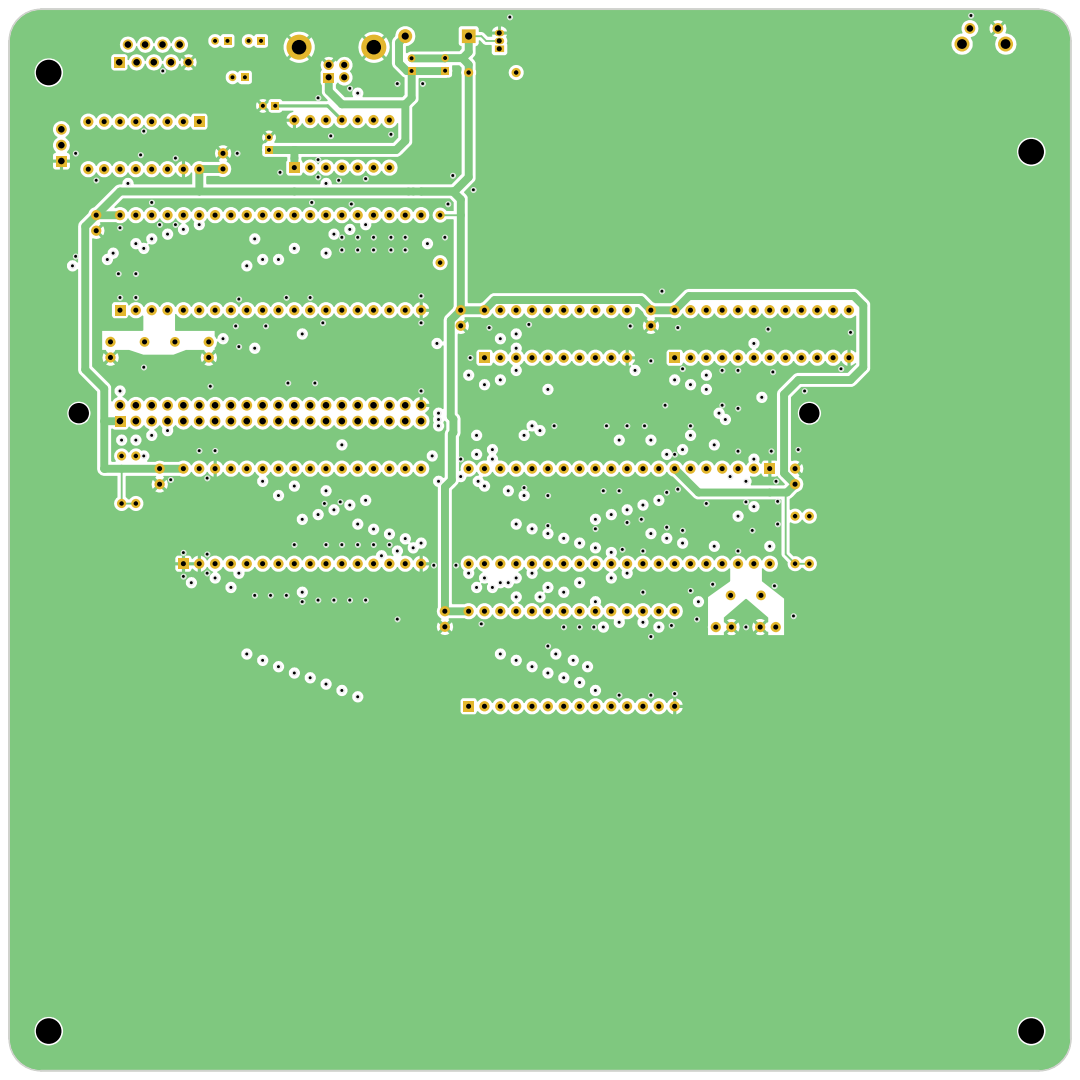
[picture p60: page 2]

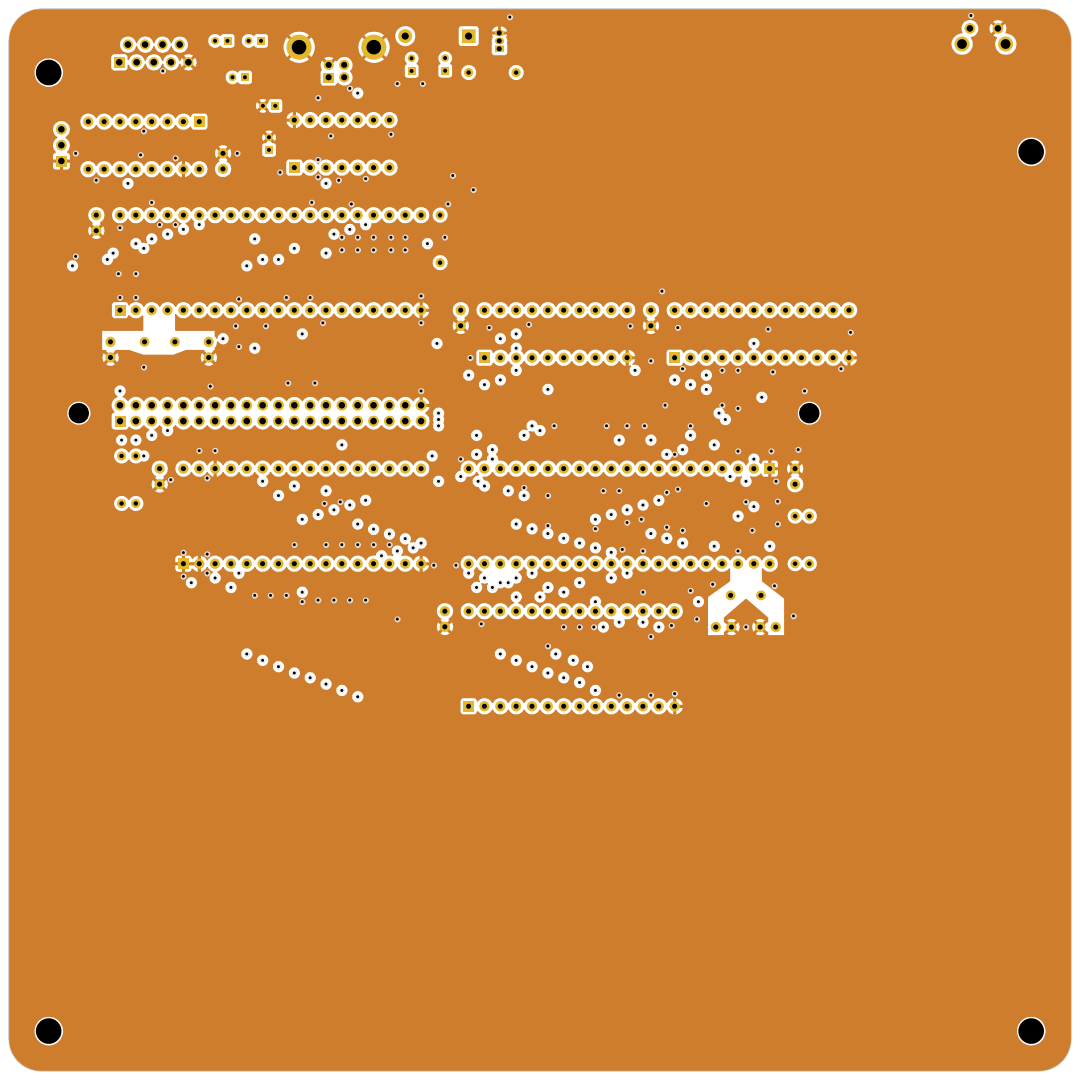
[picture p61: page 3]

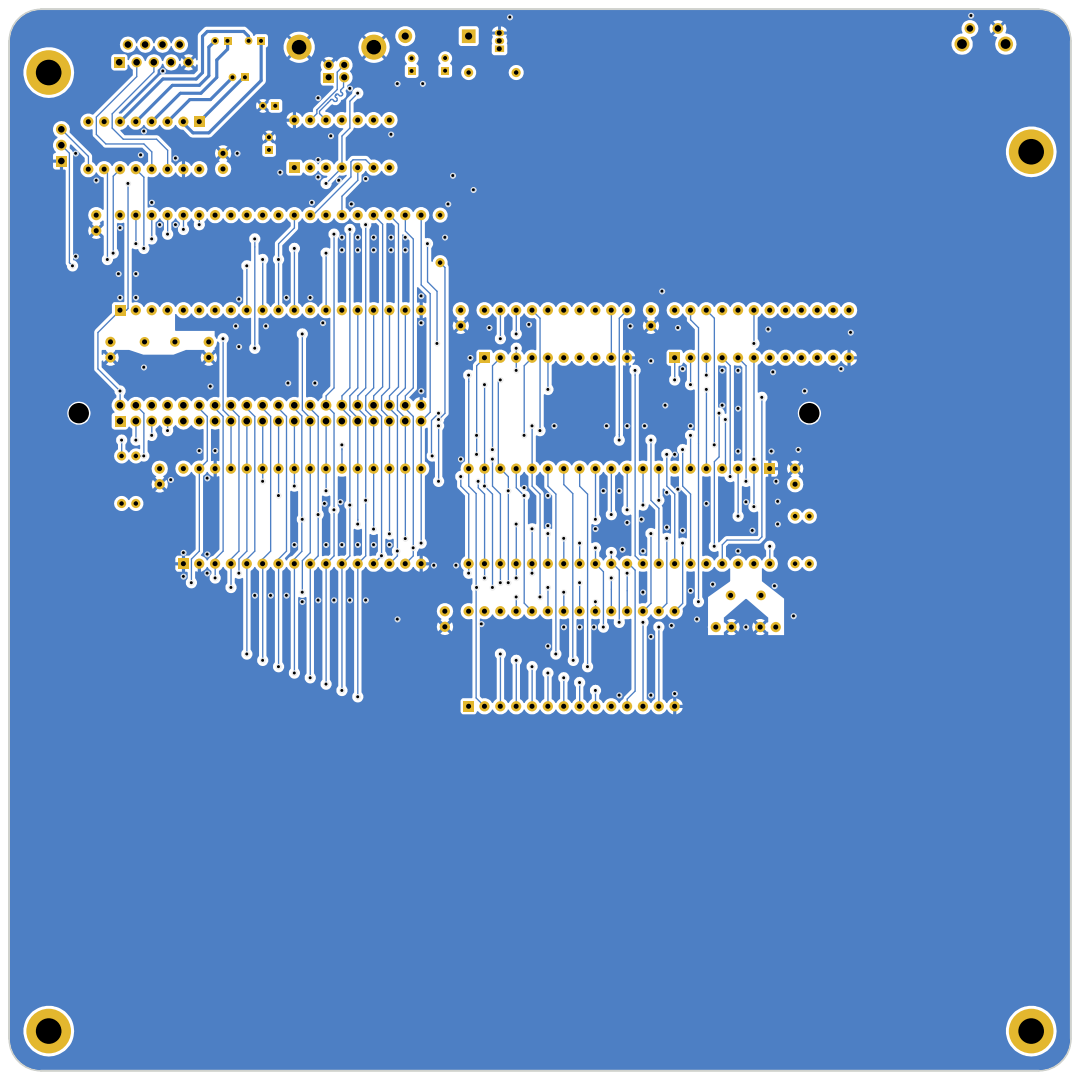
[picture p62: page 4]

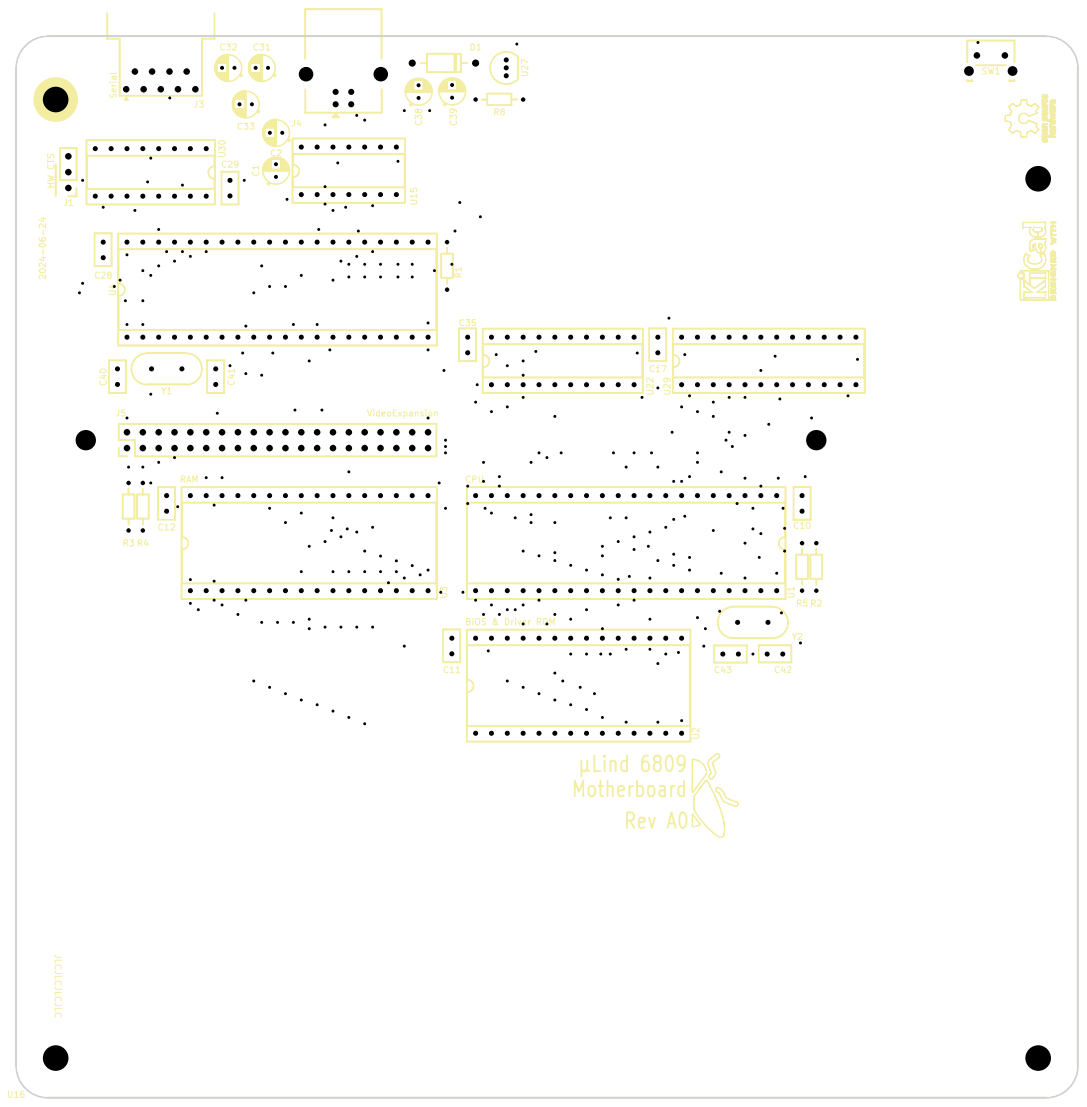
[picture p63: page 5]

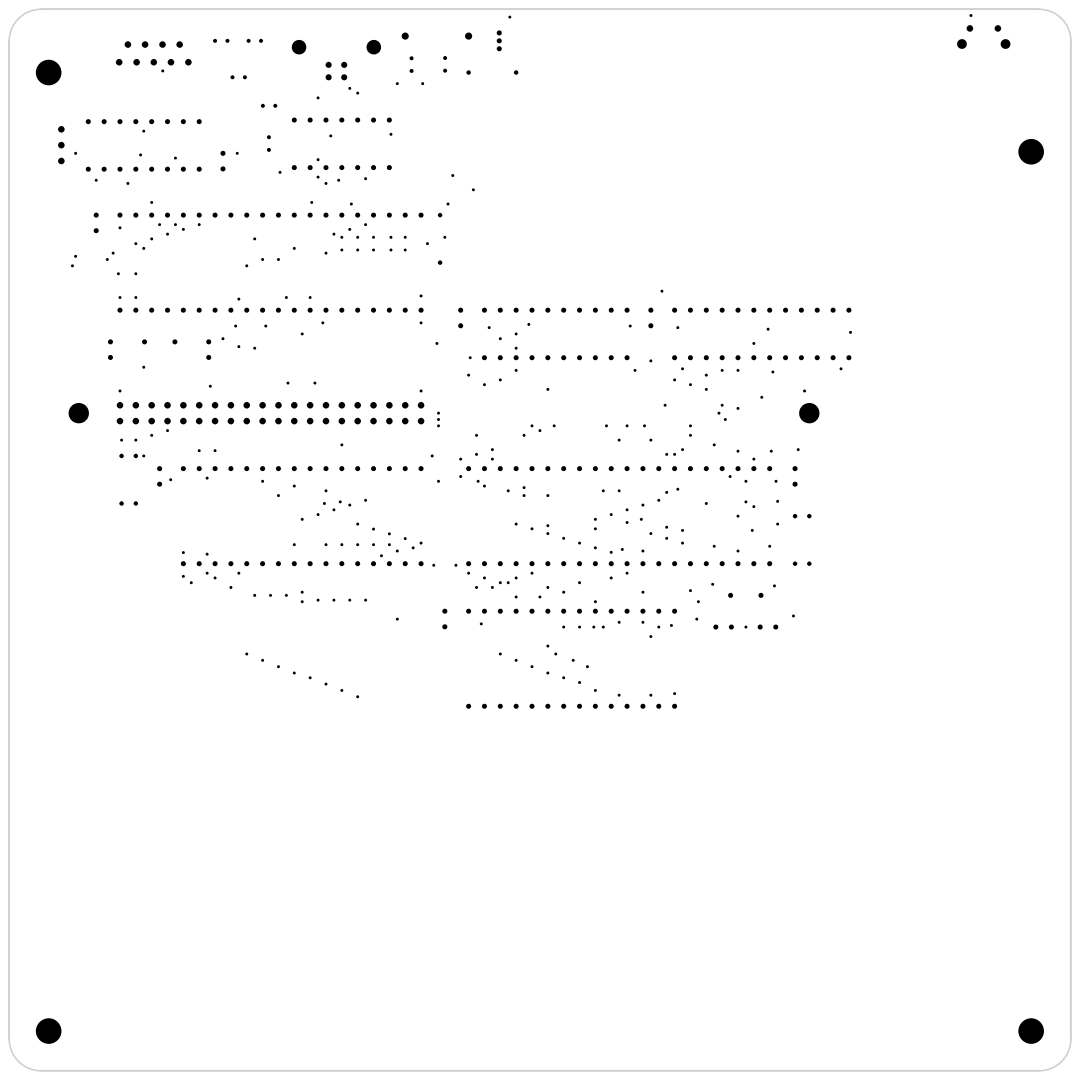
[picture p64: page 6]
