MicroLind-Developers/microlind/(commit log)

2024-06-24 Last updates of motherboard
    [address_logic.kicad_sch, cpu_men.kicad_sch, expansion.kicad_sch, irq_handler.kicad_sch, motherboard.kicad_sch, power.kicad_sch, ps2.kicad_sch, serial.kicad_sch]
2024-07-02 A lot of updates
    [AudioExpansionCard.kicad_pcb, AudioExpansionCard.kicad_sch, address_logic.kicad_sch, character_rom.kicad_sch, cpu_men.kicad_sch, cpu_proto.kicad_pcb, cpu_proto.kicad_sch, dram-tester.kicad_pcb]
2024-07-31 Splitting the repo into separate parts for firmware, software and hardware. This repo will hold them together and maintain releases and documents
    [189-009-613r571.stp, 2301843-1.step, 530470610.stp, 5788667-1.stp, AudioExpansionCard.kicad_pcb, AudioExpansionCard.kicad_sch, AudioExpansionCard.step, CUI_DEVICES_SJ1-3533NG.step]
2024-10-30 Updates to a lot of stuf
    [189-009-613r571.stp, 530470610.stp, 5788667-1.stp, 7201J1AQE2.stp, CUI_DEVICES_SJ1-3533NG.step, CUI_DEVICES_SJ1-3534NG.step, M3x8.STEP, PLCC44_THT_Socket_P1,27_P2,54.stp]
2024-11-15 Updates to hw and builder
    [189-009-613r491.stp]
2025-04-01 Added info and bumped repos
    [DualSerialMaleConnector.step, TimingAnalysis.xlsx]
2025-04-23 Bumping all the things and addind stage2 release
2025-04-25 Stage 2 bump!
2025-08-05 Added stage 3 schematics
