MicroLind-Developers/microlind/(notices)

Notices in the files:
kicad-lib/7201J1AQE2.stp:
author */ ('License CC BY-ND 4.0'),
